Nickster90s/Inferno-FPGA/MCR_REPLACEMENT.md

# Replacing `mcr` — design for a Dante media clock

Written at the end of a session that hit three separate clock failures, all
centred on `mcr`. The conclusion, which the operator reached first: `mcr` is AVB
media-clock-recovery machinery and Dante does not need most of it.

## What mcr is, and why it fights us

`mcr` was built to recover a media clock from an **AVB CRF stream**. It carries:

- CRF stream binding (`crf_stream_id`, `crf_dmac`, talker EID), persisted in config
- a CRF-loss **watchdog** that snaps `current_increment` back to `base_increment`
- its own `servo_locked` state machine and a CRF PI servo
- a *secondary* path that derives the NCO from the gPTP addend ratio

**Dante has no CRF.** Nothing binds a stream, nothing feeds the CRF servo, the
watchdog can only ever fire in the "lost" direction, and the gPTP path is gated
on `gptp_t.servo_locked` — a flag set only by `gptp_servo_update()`, i.e. the
802.1AS servo, which this device no longer runs.

Net effect today: `mcr_compute_gptp_base()` always returns the undisciplined
`base_increment`. The media clock free-runs at the crystal rate.

## Measured evidence (this session)

| state | drift | underrun |
|---|---|---|
| undisciplined (current) | +4.34 ppm, +15.6 ms/hour | ~130 total, not growing |
| mcr pointed at `g_ptpv1` | **+0.17 ppm**, +0.61 ms/hour | 40547 in 4 min, then a 4.19M burst |
| following servo integral only | — | same underrun storm |
| firmware NCO trim on top | timestamp fell **5.3 s** behind in 115 s | — |

The drift fix works. Something about changing the NCO increment at runtime
starves the ring — and `fifo_level` reads centre (65-67) throughout, which no
one has explained. The 5.3 s divergence is three orders of magnitude beyond the
±50 ppm the trim was clamped to, so it is not an arithmetic error; it is the
same fault at its most extreme.

**Start the rewrite from that contradiction, not from the drift.**

## What a Dante media clock actually needs

One thing: an NCO whose rate is slaved to the PTPv1 rate estimate.

    increment = base_increment * (1 + rate_error)

where `rate_error` comes from the PTPv1 servo. `g_ptpv1` already exposes
`locked`, `base_addend_full` and `current_addend_full`; the ratio of the last two
IS the rate correction, in exactly the form needed.

Deliberately absent: CRF binding, CRF servo, the loss watchdog, `servo_locked`,
the config fields, the `cs` media-clock-source selector.

## Prime suspects for the underrun

1. **The watchdog.** `watchdog_reset_active` snaps the increment back to
   `base_increment`. If it fires while the gPTP path is also writing, the NCO
   oscillates between two rates — which would starve a ring while the *average*
   level still looks correct. This fits the `fifo_level`-at-centre contradiction
   better than anything else and should be checked first.
2. **CSR write path.** `mcr_increment_write()` is called from several places
   (`mcr.c:53, 388, 442`). Concurrent writers with different sources would
   produce exactly this.
3. **Deadband interaction.** The gPTP-base deadband suppresses rewrites; combined
   with a watchdog reset the effective rate could latch to the wrong value.

## Reference: statime's overlay clock (`origin/inferno-dev`)

That branch is the **PTPv1** fork, not upstream PTPv2 — I got this wrong once and
the operator corrected it. `statime/src/overlay_clock.rs` is directly relevant:

    pub struct ClockOverlay {
        pub last_sync: Time,   // underlying clock's timestamp of last sync
        pub shift: Duration,   // add to OS clock -> virtual clock
        pub freq_scale: f64,   // + accelerates the virtual clock
    }
    pub trait ClockOverlayExporter {
        fn export(&mut self, overlay: &ClockOverlay);
    }

Two things to take from it:

1. **Rate and phase are separate, explicit state.** `freq_scale` is the standing
   rate correction; `shift` is phase. Our servo conflates them inside one addend,
   which is why "follow the integral" and "follow the full addend" both went
   wrong in different ways — neither is cleanly one or the other.
2. **One owner, one export point.** The overlay is the single writer, and
   consumers are *told* when it changes via the exporter callback. Our
   `mcr_increment_write()` is called from three sites (`mcr.c:53, 388, 442`) with
   independently computed values. If two of them disagree the NCO alternates
   between rates — which starves a ring while its AVERAGE level still reads
   centre, matching the one observation nothing else explains.

The replacement should therefore be shaped as: PTPv1 owns `(shift, freq_scale)`,
exports `freq_scale` on change, and the NCO has exactly ONE writer that consumes
it. That is a stronger constraint than "slave the NCO to g_ptpv1" and is probably
the actual fix.

## Suggested order

1. Instrument before changing: log every `mcr_increment_write()` with its value
   and caller for 30 s with the clock disciplined. If the value oscillates,
   suspect 1 or 2 is confirmed and the rewrite is straightforward. This is the
   cheapest decisive experiment available and should come before any new code.
2. Write `mcr_dante.c`: NCO slaved to `g_ptpv1`, nothing else. ~50-80 lines.
3. Keep `mcr.c` in `_avb_reference/` — it is still the reference for the NCO
   arithmetic and the USB feedback servo scaling.
4. Verify in this order: `underrun` delta over 10 min (must stay 0), then drift
   rate over 1 h (target < 0.5 ppm), then an overnight run.

## Also still AVB-shaped, lower priority

- `config.h` carries `cs`, `crf_valid`, `crf_stream_id`, `crf_dmac`,
  `crf_talker_eid` — all dead under Dante.
- `gptp.c` remains as the TSU accessor and servo library; `ptpv1.c` reuses parts.
  That layering is fine, but `gptp_t.servo_locked` being read by `mcr` while only
  the 802.1AS servo sets it is exactly the trap that caused the undisciplined
  clock. Any remaining cross-module reads of gPTP state deserve the same audit.

---

# DONE (2026-08-03) — `mcr_dante.c`

Built and measured. `mcr_watchdog_tick()` no longer owns the NCO; `mcr_dante.c`
is the single writer.

## The mechanism, finally identified

Two things had been missed, and together they explain why both previous attempts
failed:

**1. An AVB watchdog was setting the Dante sample rate.** Under Dante there is no
CRF, so `mcr_pump_hw()` is a no-op, `mcr_servo_update()` is gated off
(`cs==1 && crf_rate_valid`), and `mcr_usb_lock()` — itself a PI servo that writes
the NCO — has **no callers at all**. The one live writer was the CRF-loss
watchdog's fallback branch (`mcr.c:267`), rewriting the increment on **every
main-loop iteration (~4 kHz)** with a 2-unit (~0.5 ppm) deadband.

**2. The ring already has a controller.** The USB wrapper's async feedback is not
a rate report. Traced in `rtl/usb_avb_subsystem.v`:

    err    = 64 - block_level      // setpoint = ring centre
    integ += err                   // integrator, clamped +/-0x080000
    fb_out = f(strobe_rate, err<<6, integ)    // updated every SOF

That is a PI servo on ring level. So disciplining the NCO adds a **second**
controller to one buffer — and the old code stepped it at 4 kHz underneath a
servo correcting at SOF rate.

So the missing constraint was never *which* rate estimate to follow. Following
the full addend (rate+phase) and following the integral alone both failed for the
same reason: **neither was slew-limited.**

## The rewrite

- **One owner.** `mcr_dante.c` only. `main.c` no longer calls
  `mcr_watchdog_tick()`.
- **Rate only.** Follows `g_ptpv1.rate_ppb` — the servo integral. The
  proportional term is phase and never reaches the audio sample rate.
- **Slew-limited to 100 ppb/s, updated at 1 Hz.** The whole 4.3 ppm correction
  takes ~43 s and costs **17 CSR writes**, against the old path's thousands per
  second.
- **Disabled at boot**, dry-run reporting first (`tools/mclk.py`).
- **Auto-disable** if underrun exceeds 10% duty with an active ring.

## Measured (no USB source attached; drift still valid, the packetizer emits at the media rate regardless)

| discipline | drift |
|---|---|
| ARMED | **+0.17 ppm  (+0.6 ms/hour)** |
| disarmed | **+4.86 ppm  (+17.5 ms/hour)** |

Toggled twice, causal and reversible. Dry-run cross-check passed before arming:
PTP's estimate (-4.28 ppm) against independently measured drift (+4.7 ppm) —
opposite sign, matching magnitude.

## Also found: the "underruns with fifo_level at centre" paradox is not one

`underrun_count` increments on **every 48 kHz media tick** while un-primed, not
per event — measured directly at 48009/s with the ring empty. So the historic
"40547 underruns in 4 minutes" is **0.845 s of un-primed time (0.35% duty)**:
brief, repeated dips. `fifo_level` was read as a ~1 Hz snapshot, which lands in a
dip almost never. Nothing paradoxical, just a fast transient sampled slowly.
`mcr_dante_level_sample()` now tracks min/max at 1 kHz; **watch min, not avg.**

## VALIDATED WITH AUDIO (2026-08-04)

The half that killed both previous attempts. MacBook streaming, two unicast
flows, talker on. Discipline toggled at runtime; same session, same bitstream.

| | disarmed | ARMED |
|---|---|---|
| drift | +3.61 ppm (+13.0 ms/hour) | **+0.39 ppm (+1.4 ms/hour)** |
| ring level | 45…77 | **48…78** |
| underrun delta | 0 | **0** |
| overrun delta | 0 | **0** |
| trips | 0 | **0** |

**The ring did not care.** Level range while armed (48…78) is
indistinguishable from undisciplined (45…77), against a centre of 64. Sampled
through the whole 44 s slew at 4 s intervals, the worst level minimum was 49 and
peak underrun was 0/s -- the ring never approached the prime floor.

That is the difference the slew limiter makes. Both earlier attempts stepped the
NCO at main-loop rate and produced underrun storms; at 100 ppb/s the USB PI
servo absorbs the change as an ordinary disturbance and the level does not move.

PTP stayed locked with no re-anchors, enables or disables throughout, and
rx_gate's writer_errors stayed at its usual armed residual -- so disciplining
the media clock disturbs neither the network nor the clock recovery.

## One gap in the safety net remains

The auto-disable guard requires `lvl_max >= 32` to distinguish "ring active"
from "no USB source". If a disciplined clock prevented the ring from priming at
all, `lvl_max` would stay low, the guard would never trip, and audio would be
silently dead. That did not happen here -- the ring never went near the floor --
but the hole is real and untested, because nothing has yet made the guard fire.
Worth closing before this runs unattended overnight.

    tools/mclk.py status      # target vs drift, and ring level min/max
    tools/mclk.py on          # slews over ~45 s
    tools/mclk.py watch 120   # watch level MIN and underrun delta
    tools/mclk.py off         # immediate, unconditional revert to nominal

Procedure:

---

# RATE IS NOT ENOUGH — the phase bug (2026-08-04)

Within hours of the rate discipline being declared working, **audio stopped
entirely** while every counter read healthy. The fix above was half a fix.

## Symptom

No audio at any receiver. Dante Controller showed the patch **fully green**.
Re-patching changed nothing. Meanwhile on the board:

    talker 1, 9001 pps on the wire, ring centred 55..73,
    underrun 0/s, overrun 0, PTP locked, rx_gate armed and clean

Everything that could be measured said the transmitter was healthy.

## Cause

    emitted 402927.04519    PTP 402926.41611   =  +10908 samples
                                               =  +227 ms INTO THE FUTURE

`DANTE_TX_TS_OFFSET` is +74 samples (1.5 ms). We were at **147x that**, in the
future. `flows_tx.rs:44` is explicit that the clock must be in the past --
"otherwise Dante devices receiving from us go mad and fart". Receivers negotiate
the subscription happily (the control plane is untouched, hence the green
patch) and then discard every audio packet as far-future.

**Two independent failures had to line up:**

1. **`ts_anchor()` only runs when the talker ENABLES.** The talker stayed on for
   two days while the USB host was off, free-running at +4.7 ppm the whole time.
   227 ms is about 13 hours of that.

2. **The re-anchor watchdog was structurally blind to it.** `dante_tx.c:327`
   compared only the **seconds** field and fired on `diff > 1`. The error lived
   entirely in the sub-second field, and the seconds differed by exactly 1 --
   which `> 1` does not catch. A one-second threshold is ~1000x a receiver's
   latency setting; it could never have protected audio.

## And the rate fix could not have caught it

`mcr_dante` corrects **rate**. Rate discipline stops the error growing; it never
returns what has already accumulated. With the phase 227 ms out, drift measured
a healthy +0.53 ppm the whole time -- perfectly flat, perfectly wrong.

This is exactly what `overlay_clock.rs` says and what the section above quoted
without acting on:

> **Rate and phase are separate, explicit state.** `freq_scale` is the standing
> rate correction; `shift` is phase.

Only `freq_scale` was built. `shift` was missing, and nothing measured it: the
status output printed `drift +10829 samples` for hours and it was read as a
benign running total rather than as 227 ms of phase error.

## Fix, both halves

- **`dante_tx.c`** — the re-anchor now measures phase in **samples**
  (`DANTE_TX_REANCHOR_SAMPLES` = 240 = 5 ms), not in whole seconds. It is a
  STEP and audible, so it is a coarse backstop only: PTP steps, and phase
  accumulated while the talker was idle.
- **`mcr_dante.c`** — a slow phase term alongside the rate. 4 ppb per sample of
  error, clamped to **+/-2000 ppb**, 1 ms deadband. Deliberately feeble: under
  half the crystal error the rate term already handles, so it cannot fight the
  ring or the USB servo. Its job is to stop phase ever accumulating, not to
  rescue a large one.

## Verified

    phase    +10908 samples  ->  -4 samples
    rate     +0.69 ppm armed
    ring     51..78 (centre 64), underrun delta 0, overrun delta 0
    PTP      locked, no re-anchors

**Audio confirmed back by ear.**

## The lesson worth keeping

A media clock has two error axes and this project had instruments for one.
Every counter on the box read healthy through a total audio outage, because
none of them measured phase. When adding a servo, ask what the OTHER axis is
doing -- and if nothing reports it, that is the bug waiting to happen.

---

# RETRACTION: the "fpp=16 timestamp is 167 us late" claim was WRONG (2026-08-05)

Commit 643a6a6 recorded, as a real unfixed bug, that fpp=16 flows are stamped
8 samples (167 us) late relative to their own audio, and that a device on
fpp=16 therefore renders 167 us apart from one on fpp=8.

**That is not true.** The reasoning read `ts_sub_emit` being latched once per
block and shared by every flow, saw the read base `rd - Mux(fpp16, 64, 0)`
(64 ring entries = 8 sample-times), and concluded the two were inconsistent. It
missed the line that reconciles them:

    f_ts_sub.eq(ts_sub_emit - (cur_fpp - 1))

The per-flow timestamp already compensates for fpp: 8 subtracts 7, 16 subtracts
15 -- a difference of exactly the 8 sample-times the read base moves. So

    fpp=8   reads [tick-7, tick],  stamps tick-7    correct
    fpp=16  reads [tick-15, tick], stamps tick-15   correct

Both label their own first sample. There is no inter-flow misalignment, and
nothing to fix.

Also checked while in there, since this file records a previous unsigned-wrap
disaster in exactly this arithmetic (`sec=85673 subsec=4294967264`): send_req
fires at `ts_sub[0:3] == 7`, so ts_sub_emit is congruent to 7 mod 8, and fpp=16
only fires on tick_hi where ts_sub is congruent to 15 mod 16. Both subtractions
bottom out at 0. No borrow, no wrap.

LESSON: the claim was made from two fragments of an expression without reading
the third, and stated confidently enough that the next step was a 20-minute
gateware build and a seed re-roll to fix a bug that did not exist.
