Nickster90s/Inferno-FPGA/docs/milestones/phase3_dante_controller_clock_status.png

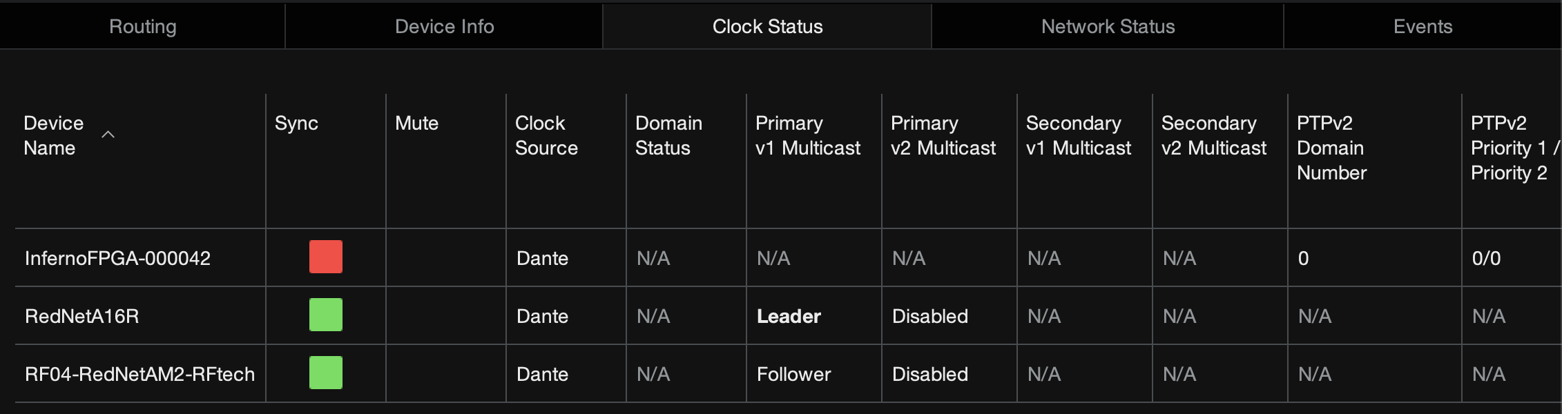
docs/milestones/phase3_dante_controller_clock_status.png
