Nickster90s/Inferno-FPGA/_avb_reference/firmware/avdecc.c

// IEEE 1722.1 AVDECC — minimal endpoint
//
// ADP: Periodic entity advertisement so controllers can discover us.
// ACMP: Handle connect/disconnect commands for talker and listener streams.
//
// PDU format (IEEE 1722.1-2013):
//   Ethernet header (14 bytes)
//   AVTPDU common header:
//     subtype(8) | sv(1) version(3) msg_type(4) | valid_time(5) control_data_len(11)
//     entity_id(64)
//   Protocol-specific fields follow.

#include "avdecc.h"
#include "gptp.h"
#include "cap.h"
#include "osc.h"
#include "config.h"

#include <generated/csr.h>
#include <generated/mem.h>
#include <generated/soc.h>
#include <string.h>
#include <stdio.h>

// Backreference to the gPTP module so ADP/AVB_INTERFACE can surface the
// learned grandmaster identity + our local clock_identity. Set by main.c
// after both gptp_init and avdecc_init via avdecc_set_gptp().
static const gptp_t *g_gptp = NULL;

// Backreference to the MCR module — when current_clock_source = 1, the
// CLOCK_DOMAIN LOCKED counter follows mcr.servo_locked rather than gPTP,
// so the Hive indicator turns green only when CRF actually flows.
static const mcr_state_t *g_mcr = NULL;

// Backreference to SRP module — GET_AVB_INFO RESPONSE must declare an
// msrp_mapping (traffic_class / priority / vlan_id) that matches what we
// emit on MSRP TalkerAdvertise. If avdecc says one priority and MSRP says
// another, the listener (Auvitran) reports MSRP failure 0x13 "SR Class
// Priority Mismatch" and the bridge refuses the reservation.
#include "srp.h"
static const srp_state_t *g_srp = NULL;
void avdecc_set_srp(const srp_state_t *s) { g_srp = s; }

// Vendor's Entity Model ID (EUI-64) — IDENTIFIES THE PRODUCT MODEL, not
// the specific device. All units running this firmware must report the
// same value; per-device uniqueness is the entity_id (MAC-derived).
// Layout: 02 FF EE (locally-administered OUI placeholder) | "NSAV" (4E53
// 4156, "N-Series AV") | 0001 (product revision).
static const uint8_t ENTITY_MODEL_ID[8] = {
    0x02, 0xFF, 0xEE, 0x4E, 0x53, 0x41, 0x56, 0x01
};

// ---------------------------------------------------------------------------
// Byte-order helpers
// ---------------------------------------------------------------------------

static inline void av_put_be16(uint8_t *p, uint16_t v)
{
    p[0] = (v >> 8); p[1] = v;
}

static inline void av_put_be32(uint8_t *p, uint32_t v)
{
    p[0] = (v >> 24); p[1] = (v >> 16); p[2] = (v >> 8); p[3] = v;
}

static inline void av_put_be64(uint8_t *p, uint64_t v)
{
    av_put_be32(p, (uint32_t)(v >> 32));
    av_put_be32(p + 4, (uint32_t)v);
}

static inline uint16_t av_get_be16(const uint8_t *p)
{
    return ((uint16_t)p[0] << 8) | p[1];
}

static inline uint32_t av_get_be32(const uint8_t *p)
{
    return ((uint32_t)p[0] << 24) | ((uint32_t)p[1] << 16) |
           ((uint32_t)p[2] << 8)  | p[3];
}

// ---------------------------------------------------------------------------
// TX
// ---------------------------------------------------------------------------

// Per-stream identity
#define N_STREAM_INPUTS   2     // [0]=CRF Media Clock, [1]=AAF Audio Input
#define N_STREAM_OUTPUTS  6     // 6x8ch AAF Audio Output (time-mux talker)
#define N_CLOCK_SOURCES   2     // [0]=Internal osc, [1]=CRF stream
#define N_CONTROLS        2     // [0]=USB A/B source (uint8), [1]=OSC IP/Subnet (UTF8 text)
#define N_AUDIO_CHANNELS  8     // 8ch AAF I/O

// USB A/B source select, driven by the AVDECC CONTROL descriptor (0=Main,
// 1=Backup). Phase-2: the 2nd USB's A/B mux will read this (via a CSR). For
// now it is the CONTROL's current value so the choice is pickable in Hive
// before the 2nd-oscillator hardware exists.
uint8_t g_usb_source = 0;
#define LISTENER_CRF_INDEX 0
#define LISTENER_AAF_INDEX 1
#define TALKER_AAF_INDEX   0
#define CLK_SRC_INTERNAL   0
#define CLK_SRC_MEDIA      1    // CRF-driven media clock

// Stream-format constants (decoded from session_mgr.aemt + IEEE 1722.1-2013
// Annex A; see avdecc.h for byte-by-byte derivation).
//
// Listener[0] = CRF audio-sample 48 kHz (Media Clock Input).
// Listener[1] = AAF PCM 8ch / 48 kHz / 32-bit (Audio Input).
// Talker[0]   = AAF PCM 8ch / 48 kHz / 32-bit (Audio Output).
static const uint8_t stream_fmt_crf_48k[8]     = STREAM_FMT_CRF_48K;
static const uint8_t stream_fmt_aaf_8ch_48k[8] = STREAM_FMT_AAF_8CH_48K;

static uint32_t avdecc_txslot;

static uint8_t *avdecc_tx_buf(void)
{
    return (uint8_t *)(ETHMAC_BASE + ETHMAC_SLOT_SIZE * (ETHMAC_RX_SLOTS + avdecc_txslot));
}

static void avdecc_eth_send(uint32_t len)
{
    cap_record(1, avdecc_tx_buf(), len);   // record our TX (ADP/AECP/ACMP) into the boot ring
    while (!ethmac_sram_reader_ready_read())
        ;
    ethmac_sram_reader_slot_write(avdecc_txslot);
    ethmac_sram_reader_length_write(len);
    ethmac_sram_reader_start_write(1);
    avdecc_txslot = (avdecc_txslot + 1) % ETHMAC_TX_SLOTS;
}

// Write Ethernet header, returns pointer past it.
static uint8_t *avdecc_eth_hdr(uint8_t *frame, const uint8_t *src_mac)
{
    static const uint8_t mcast[] = AVDECC_MCAST_ADDR;
    memcpy(frame, mcast, 6);
    memcpy(frame + 6, src_mac, 6);
    av_put_be16(frame + 12, AVDECC_ETHERTYPE);
    return frame + 14;
}

// ---------------------------------------------------------------------------
// ADP — AVDECC Discovery Protocol
// ---------------------------------------------------------------------------

// ADPDU layout (after Ethernet header):
//   [0]      subtype = 0x7A
//   [1]      sv(1)=0 | version(3)=0 | message_type(4)
//   [2..3]   valid_time(5) | control_data_length(11) = 56
//   [4..11]  entity_id (8 bytes)
//   [12..19] entity_model_id (8 bytes)
//   [20..23] entity_capabilities (4 bytes)
//   [24..25] talker_stream_sources (2 bytes)
//   [26..27] talker_capabilities (2 bytes)
//   [28..29] listener_stream_sinks (2 bytes)
//   [30..31] listener_capabilities (2 bytes)
//   [32..35] controller_capabilities (4 bytes)
//   [36..39] available_index (4 bytes)
//   [40..47] gptp_grandmaster_id (8 bytes)
//   [48]     gptp_domain_number
//   [49]     reserved (1 byte)   — IEEE 1722.1 §6.2.1.15 / la_avdecc. (GenAVB's
//            struct adp_pdu carries an extra rsvd1 u16 here; do NOT copy it — the
//            MOTU/Hive parse per la_avdecc and it shifts interface_index.)
//   [50..51] identify_control_index (2 bytes)
//   [52..53] interface_index (2 bytes)
//   [54..61] association_id (8 bytes)
//   [62..67] reserved (6 bytes) — keeps the AVTP frame body at 68 bytes so Hive
//            doesn't log "Adpdu::deserialize error: Not enough data in buffer".
// Total ADPDU = 68 bytes, control_data_length = 56 (per IEEE 1722.1)

#define ADPDU_LEN           68
#define ADP_CONTROL_DATA_LEN 56

static void adp_send(avdecc_state_t *s, uint8_t msg_type)
{
    uint8_t *frame = avdecc_tx_buf();
    uint8_t *p = avdecc_eth_hdr(frame, s->src_mac);

    // Subtype
    p[0] = AVTP_SUBTYPE_ADP;

    // sv=0 | version=0 | message_type
    p[1] = msg_type & 0x0F;

    // valid_time(5) | control_data_length(11) = 56
    uint16_t vt_cdl = ((uint16_t)ADP_VALID_TIME << 11) | ADP_CONTROL_DATA_LEN;
    av_put_be16(p + 2, vt_cdl);

    // entity_id
    memcpy(p + 4, s->entity_id, 8);

    // entity_model_id — static, identifies the firmware/product model.
    memcpy(p + 12, ENTITY_MODEL_ID, 8);

    // entity_capabilities — AEM_SUPPORTED is required for controllers to
    // issue READ_DESCRIPTOR; without it Hive lists the entity but treats
    // it as having no AEM model and shows it as empty.
    // AEM_INTERFACE_INDEX_VALID flags that the interface_index field
    // (byte 54) is meaningful — without it Hive marks the entity name
    // red in the patch matrix even when everything else validates.
    uint32_t caps = ADP_CAP_AEM_SUPPORTED |
                    ADP_CAP_VENDOR_UNIQUE_SUPPORTED |
                    ADP_CAP_CLASS_A_SUPPORTED |
                    ADP_CAP_GPTP_SUPPORTED |
                    ADP_CAP_AEM_INTERFACE_INDEX_VALID;
    av_put_be32(p + 20, caps);

    // talker_stream_sources = N_STREAM_OUTPUTS (1 AAF talker)
    av_put_be16(p + 24, N_STREAM_OUTPUTS);

    // talker_capabilities
    uint16_t talker_caps = ADP_TALKER_CAP_IMPLEMENTED | ADP_TALKER_CAP_AUDIO_SOURCE;
    av_put_be16(p + 26, talker_caps);

    // listener_stream_sinks = N_STREAM_INPUTS (1 CRF + 1 AAF)
    av_put_be16(p + 28, N_STREAM_INPUTS);

    // listener_capabilities — we have a CRF (Media Clock) listener at
    // STREAM_INPUT[0] AND an AAF (Audio) listener at STREAM_INPUT[1], so
    // advertise both sink capabilities. MEDIA_CLOCK_SINK is the critical
    // one for CRF: talkers (Auvitran) don't route CRF traffic to listeners
    // that only declare AUDIO_SINK — they look specifically for MediaClockSink.
    uint16_t listener_caps = ADP_LISTENER_CAP_IMPLEMENTED |
                             ADP_LISTENER_CAP_MEDIA_CLOCK_SINK |
                             ADP_LISTENER_CAP_AUDIO_SINK;
    av_put_be16(p + 30, listener_caps);

    // controller_capabilities = 0
    av_put_be32(p + 32, 0);

    // available_index
    av_put_be32(p + 36, s->adp_available_index);

    // gptp_grandmaster_id — learned from Announce messages by gPTP.
    // Zero until first Announce; matches the actual GM thereafter.
    if (g_gptp && g_gptp->gm_valid)
        memcpy(p + 40, g_gptp->gm_clock_id, 8);
    else
        memset(p + 40, 0, 8);

    // gptp_domain_number = 0
    p[48] = 0;

    // reserved
    // reserved: exactly ONE octet after gptp_domain_number (IEEE 1722.1
    // §6.2.1.15, and la_avdecc/Hive/MOTU parse it that way). The old code used
    // THREE reserved bytes (copied from GenAVB's struct adp_pdu, which carries an
    // extra rsvd1 u16) — that shifted identify_control_index/interface_index/
    // association_id +2, so our 0xFFFF landed in the field the MOTU reads as
    // interface_index (avb_session sends 0 there). A Milan listener checks
    // interface_index (adp_milan.c:400) and refused to bind our streams -> entity
    // visible ("green round") but no connection. Match la_avdecc / avb_session.
    p[49] = 0;

    // identify_control_index (offset 50): 0xFFFF = no CONTROL descriptor.
    av_put_be16(p + 50, 0xFFFF);
    // interface_index (offset 52): 0 = AVB_INTERFACE descriptor at index 0.
    av_put_be16(p + 52, 0);

    // association_id (offset 54)
    memset(p + 54, 0, 8);

    // reserved trailing (offset 62..67) — keeps ADPDU length unchanged.
    memset(p + 62, 0, 6);

    // Total frame
    uint32_t frame_len = 14 + ADPDU_LEN;
    if (frame_len < 64)
        frame_len = 64;  // Minimum Ethernet frame

    avdecc_eth_send(frame_len);

    if (msg_type == ADP_MSG_ENTITY_AVAILABLE)
        s->adp_available_index++;

    s->adp_tx_count++;
}

void avdecc_reannounce(avdecc_state_t *s)
{
    // DEPARTING then AVAILABLE (with a bumped available_index): a real ADP-level
    // state change the AxC observes. Milan listeners re-run fast-connect on this ->
    // re-send CONNECT_TX -> re-lock to our stream on the now-settled clock. A media
    // gap alone did NOT make the AxC re-derive (not an AVDECC event); this is the
    // standard control-plane way to force it.
    adp_send(s, ADP_MSG_ENTITY_DEPARTING);
    adp_send(s, ADP_MSG_ENTITY_AVAILABLE);
}

// ---------------------------------------------------------------------------
// ACMP — AVDECC Connection Management Protocol
// ---------------------------------------------------------------------------

// ACMPDU layout (after Ethernet header):
//   [0]      subtype = 0x7C
//   [1]      sv(1)=0 | version(3)=0 | message_type(4)
//   [2..3]   status(5) | control_data_length(11) = 44
//   [4..11]  stream_id (8 bytes)
//   [12..19] controller_entity_id (8 bytes)
//   [20..27] talker_entity_id (8 bytes)
//   [28..35] listener_entity_id (8 bytes)
//   [36..37] talker_unique_id (2 bytes)
//   [38..39] listener_unique_id (2 bytes)
//   [40..45] stream_dest_mac (6 bytes)
//   [46..47] connection_count (2 bytes)
//   [48..49] sequence_id (2 bytes)
//   [50..51] flags (2 bytes)
//   [52..53] stream_vlan_id (2 bytes)
//   [54..55] reserved (2 bytes)
// Total ACMPDU = 56 bytes, control_data_length = 44

#define ACMPDU_LEN              56
#define ACMP_CONTROL_DATA_LEN   44

// Offsets within ACMPDU (from start of PDU, past Ethernet header)
#define ACMP_OFF_STREAM_ID          4
#define ACMP_OFF_CONTROLLER_ID      12
#define ACMP_OFF_TALKER_ID          20
#define ACMP_OFF_LISTENER_ID        28
#define ACMP_OFF_TALKER_UID         36
#define ACMP_OFF_LISTENER_UID       38
#define ACMP_OFF_STREAM_DEST_MAC    40
#define ACMP_OFF_CONN_COUNT         46
#define ACMP_OFF_SEQ_ID             48
#define ACMP_OFF_FLAGS              50
#define ACMP_OFF_VLAN_ID            52

static int entity_id_match(const uint8_t *a, const uint8_t *b)
{
    for (int i = 0; i < 8; i++) {
        if (a[i] != b[i]) return 0;
    }
    return 1;
}

static void acmp_send_response(avdecc_state_t *s, uint8_t msg_type, uint8_t status,
                                const uint8_t *rx_pdu)
{
    uint8_t *frame = avdecc_tx_buf();
    uint8_t *p = avdecc_eth_hdr(frame, s->src_mac);

    // Copy the received ACMPDU as base and modify
    memcpy(p, rx_pdu, ACMPDU_LEN);

    // Subtype
    p[0] = AVTP_SUBTYPE_ACMP;

    // message_type = response type
    p[1] = msg_type & 0x0F;

    // status | control_data_length
    uint16_t st_cdl = ((uint16_t)(status & 0x1F) << 11) | ACMP_CONTROL_DATA_LEN;
    av_put_be16(p + 2, st_cdl);

    // Fill in our stream info for talker responses (by talker_unique_id)
    if (msg_type == ACMP_MSG_CONNECT_TX_RESPONSE ||
        msg_type == ACMP_MSG_GET_TX_STATE_RESPONSE ||
        msg_type == ACMP_MSG_DISCONNECT_TX_RESPONSE) {
        uint16_t tuid = av_get_be16(p + ACMP_OFF_TALKER_UID);
        if (tuid < AVDECC_MAX_TALKERS) {
            avdecc_talker_stream_t *t = &s->talkers[tuid];
            memcpy(p + ACMP_OFF_STREAM_ID, t->stream_id, 8);
            memcpy(p + ACMP_OFF_STREAM_DEST_MAC, t->dest_mac, 6);
            // Milan 1.3 §5.5.4.3: the talker MUST advertise
            // connection_count = 0 in GET_TX_STATE_RESPONSE (the spec
            // wants this field reserved for the listener-side count).
            // Hive logs a Milan compliance error if we report nonzero.
            uint16_t cc = (msg_type == ACMP_MSG_GET_TX_STATE_RESPONSE)
                            ? 0 : t->connection_count;
            av_put_be16(p + ACMP_OFF_CONN_COUNT, cc);
            // The TALKER is authoritative for the stream's VLAN + class flags;
            // don't echo the listener's command values (it may carry a wrong
            // assumption). Class A stream on VID 2 -> CLASS_B flag clear.
            av_put_be16(p + ACMP_OFF_VLAN_ID, 2);
            av_put_be16(p + ACMP_OFF_FLAGS, 0);
            // DIAGNOSTIC: show exactly what we hand the listener so it can set
            // its RX filter + declare a Listener Ready. If Frames RX stays 0,
            // compare these against what the listener actually subscribes to.
            if (msg_type == ACMP_MSG_CONNECT_TX_RESPONSE)
                printf("[ACMP] CONNECT_TX_RESPONSE -> listener: sid=%02x:%02x:%02x"
                       ":%02x:%02x:%02x:%02x:%02x dst=%02x:%02x:%02x:%02x:%02x:%02x"
                       " vlan=2 conn=%u\n",
                       t->stream_id[0], t->stream_id[1], t->stream_id[2],
                       t->stream_id[3], t->stream_id[4], t->stream_id[5],
                       t->stream_id[6], t->stream_id[7],
                       t->dest_mac[0], t->dest_mac[1], t->dest_mac[2],
                       t->dest_mac[3], t->dest_mac[4], t->dest_mac[5],
                       (unsigned)cc);
        }
    }

    // Fill in connection info for listener responses (by listener_unique_id).
    // Previously we only wrote connection_count — for GET_RX_STATE_RESPONSE
    // that left talker_eid/stream_id/dest_mac/vlan_id all zero, so Hive read
    // the response as "no connection" and showed the input as "running" even
    // when a CONNECT_RX had succeeded. Per IEEE 1722.1-2013 §8.2.2.6, the
    // response must echo the connection state: talker IDs, stream ID, dest
    // MAC, VLAN, flags (FAST_CONNECT/SAVED_STATE/CONNECTED/STREAMING).
    if (msg_type == ACMP_MSG_CONNECT_RX_RESPONSE ||
        msg_type == ACMP_MSG_GET_RX_STATE_RESPONSE ||
        msg_type == ACMP_MSG_DISCONNECT_RX_RESPONSE) {
        uint16_t luid = av_get_be16(p + ACMP_OFF_LISTENER_UID);
        if (luid < AVDECC_MAX_LISTENERS) {
            const avdecc_listener_stream_t *l = &s->listeners[luid];
            av_put_be16(p + ACMP_OFF_CONN_COUNT, l->connection_count);
            if (l->connected) {
                memcpy(p + ACMP_OFF_TALKER_ID,       l->talker_id, 8);
                av_put_be16(p + ACMP_OFF_TALKER_UID, l->talker_uid);
                memcpy(p + ACMP_OFF_STREAM_ID,       l->stream_id, 8);
                memcpy(p + ACMP_OFF_STREAM_DEST_MAC, l->dest_mac, 6);
                uint16_t vid = (l->stream_vlan_id != 0)
                                 ? l->stream_vlan_id : 2;
                av_put_be16(p + ACMP_OFF_VLAN_ID, vid);
                // ACMP has no explicit "connected" bit — a non-zero
                // talker_eid in the response IS the indication. We set
                // FAST_CONNECT + SAVED_STATE so a controller restart
                // (Hive) re-reads our persisted binding as fast-connect.
                av_put_be16(p + ACMP_OFF_FLAGS,
                            (uint16_t)(ACMP_FLAG_FAST_CONNECT |
                                       ACMP_FLAG_SAVED_STATE));
            }
        }
    }

    uint32_t frame_len = 14 + ACMPDU_LEN;
    if (frame_len < 64)
        frame_len = 64;

    avdecc_eth_send(frame_len);
    s->acmp_tx_count++;
}

// Defined near push_unsol_counters(); used here on the connect/disconnect edge.
static void push_unsol_stream_out_counters(avdecc_state_t *s, uint16_t uid);
static void push_unsol_stream_info(avdecc_state_t *s, uint16_t dt, uint16_t di);

static void acmp_handle_connect_tx(avdecc_state_t *s, const uint8_t *pdu)
{
    // A controller or listener is asking us (talker) to start streaming
    const uint8_t *listener_id = pdu + ACMP_OFF_LISTENER_ID;
    uint16_t tuid = av_get_be16(pdu + ACMP_OFF_TALKER_UID);
    uint16_t luid = av_get_be16(pdu + ACMP_OFF_LISTENER_UID);

    if (tuid >= AVDECC_MAX_TALKERS) {
        acmp_send_response(s, ACMP_MSG_CONNECT_TX_RESPONSE,
                           ACMP_STATUS_TALKER_UNKNOWN_ID, pdu);
        return;
    }

    avdecc_talker_stream_t *t = &s->talkers[tuid];

    // Reference-count DISTINCT listeners. Multiple listeners connect to the
    // same talker uid; keep TX enabled while ANY is connected. (memcmp isn't
    // linked in this bare-metal libc -> manual 8-byte compare.)
    int known = 0, freeslot = -1;
    for (int i = 0; i < AVDECC_MAX_LISTENERS_PER_TALKER; i++) {
        int zero = 1, same = 1;
        for (int k = 0; k < 8; k++) {
            if (t->listeners[i][k])                   zero = 0;
            if (t->listeners[i][k] != listener_id[k]) same = 0;
        }
        if (!zero && same) { known = 1; break; }
        if (zero && freeslot < 0) freeslot = i;
    }
    uint8_t was_n = t->n_listeners;
    if (!known && freeslot >= 0) {
        memcpy(t->listeners[freeslot], listener_id, 8);
        t->n_listeners++;
    }
    memcpy(t->listener_id, listener_id, 8);   // most-recent (diag / response)
    t->listener_uid = luid;
    t->connected = (t->n_listeners > 0);
    t->connection_count++;

    printf("[AVDECC] CONNECT_TX uid=%u <- listener "
           "%02x:%02x:%02x:%02x:%02x:%02x:%02x:%02x (n_listeners=%u)\n",
           tuid,
           listener_id[0], listener_id[1], listener_id[2], listener_id[3],
           listener_id[4], listener_id[5], listener_id[6], listener_id[7],
           t->n_listeners);

    // Enable TX only on the 0->1 transition (first listener).
    if (was_n == 0 && t->n_listeners > 0) {
        // Milan STREAM_START: bump on the empty->non-empty edge (matches the
        // reference handleConnectTx g_streamStartCount). Keep the §5.3.7.7
        // invariant |start-stop|<=1: only advance if start is level with stop.
        if (t->stream_start <= t->stream_stop)
            t->stream_start++;
        push_unsol_stream_out_counters(s, tuid);   // let Hive see it climb live
        // Push STREAM_INFO too so the controller/listener immediately sees the
        // talker flip to CONNECTED/streaming (matches avb_session's
        // notify_stream_info_changed(0x0006) on connect). Without this the
        // listener never learns the talker is live and never arms its input.
        push_unsol_stream_info(s, AEM_DESC_STREAM_OUTPUT, tuid);
        if (s->on_talker_connect)
            s->on_talker_connect(tuid, listener_id);
    }

    acmp_send_response(s, ACMP_MSG_CONNECT_TX_RESPONSE, ACMP_STATUS_SUCCESS, pdu);
}

static void acmp_handle_disconnect_tx(avdecc_state_t *s, const uint8_t *pdu)
{
    uint16_t tuid = av_get_be16(pdu + ACMP_OFF_TALKER_UID);
    const uint8_t *listener_id = pdu + ACMP_OFF_LISTENER_ID;
    if (tuid < AVDECC_MAX_TALKERS) {
        avdecc_talker_stream_t *t = &s->talkers[tuid];
        // Remove this listener from the set; disable TX only on 1->0 (last one).
        for (int i = 0; i < AVDECC_MAX_LISTENERS_PER_TALKER; i++) {
            int same = 1;
            for (int k = 0; k < 8; k++)
                if (t->listeners[i][k] != listener_id[k]) { same = 0; break; }
            if (same) {
                memset(t->listeners[i], 0, 8);
                if (t->n_listeners > 0) t->n_listeners--;
                break;
            }
        }
        if (t->connection_count > 0) t->connection_count--;
        t->connected = (t->n_listeners > 0);
        printf("[AVDECC] DISCONNECT_TX uid=%u (n_listeners=%u)\n", tuid, t->n_listeners);
        if (t->n_listeners == 0) {
            // Milan STREAM_STOP on the non-empty->empty edge, guarded so
            // stop never exceeds start (§5.3.7.7 |start-stop|<=1).
            if (t->stream_stop < t->stream_start)
                t->stream_stop++;
            push_unsol_stream_out_counters(s, tuid);
            push_unsol_stream_info(s, AEM_DESC_STREAM_OUTPUT, tuid);  // talker -> not connected
            if (s->on_talker_disconnect)
                s->on_talker_disconnect(tuid);
        }
    } else {
        printf("[AVDECC] DISCONNECT_TX uid=%u\n", tuid);
    }
    acmp_send_response(s, ACMP_MSG_DISCONNECT_TX_RESPONSE, ACMP_STATUS_SUCCESS, pdu);
}

static void acmp_handle_get_tx_state(avdecc_state_t *s, const uint8_t *pdu)
{
    acmp_send_response(s, ACMP_MSG_GET_TX_STATE_RESPONSE, ACMP_STATUS_SUCCESS, pdu);
}

// Send our own ACMP CONNECT_TX_COMMAND (slow-path resolve). We act as a
// pseudo-controller asking the talker for stream details so we can fill
// in the deferred CONNECT_RX_RESPONSE.
static void send_connect_tx_command(avdecc_state_t *s, const avdecc_resolve_t *r)
{
    uint8_t *frame = avdecc_tx_buf();
    uint8_t *p = avdecc_eth_hdr(frame, s->src_mac);

    memset(p, 0, ACMPDU_LEN);
    p[0] = AVTP_SUBTYPE_ACMP;
    p[1] = ACMP_MSG_CONNECT_TX_COMMAND;
    av_put_be16(p + 2, ACMP_CONTROL_DATA_LEN);          // status=0, cdl=44
    // stream_id (offset 4..11) = 0 (we don't know it yet — that's why we're asking)
    memcpy(p + ACMP_OFF_CONTROLLER_ID, s->entity_id, 8);
    memcpy(p + ACMP_OFF_TALKER_ID,     r->talker_id,  8);
    memcpy(p + ACMP_OFF_LISTENER_ID,   s->entity_id, 8);
    av_put_be16(p + ACMP_OFF_TALKER_UID,   r->talker_uid);
    av_put_be16(p + ACMP_OFF_LISTENER_UID, r->listener_uid);
    // dest_mac/conn_count zero; vlan zero; flags zero
    av_put_be16(p + ACMP_OFF_SEQ_ID, r->our_seq_id);

    avdecc_eth_send(14 + ACMPDU_LEN);
    s->acmp_tx_count++;
}

// Proactively initiate a listener connection (slow-path) WITHOUT a controller —
// used by the CRF auto-reconnect at boot. Sends CONNECT_TX_COMMAND to the talker
// for (listener_uid <- talker_eid[talker_uid]); the talker's CONNECT_TX_RESPONSE
// is handled by the normal resolve path (binds + on_listener_connect). A passive
// pending listener only binds if the talker spontaneously advertises — which it
// won't unless asked, so we ask here. ctrl_eid is zeroed (no controller), making
// the eventual deferred CONNECT_RX_RESPONSE a harmless no-op.
void avdecc_initiate_listener_connect(avdecc_state_t *s, uint8_t listener_uid,
                                      const uint8_t *talker_eid, uint16_t talker_uid)
{
    if (listener_uid >= AVDECC_MAX_LISTENERS) return;
    avdecc_resolve_t *r = &s->resolves[listener_uid];
    r->active           = 1;
    r->listener_uid     = listener_uid;
    r->our_seq_id       = s->next_acmp_seq++;
    memset(r->ctrl_eid_orig, 0, 8);
    r->ctrl_seq_id_orig = 0;
    memcpy(r->talker_id, talker_eid, 8);
    r->talker_uid       = talker_uid;
    r->start_ms         = gptp_uptime_ms();
    send_connect_tx_command(s, r);
}

// Send an ACMP DISCONNECT_TX_COMMAND to a talker — clears its stale
// talker/listener state before we re-bootstrap with CONNECT_TX. Used by
// the CRF data-flow watchdog. Carries the known stream_id (unlike the
// slow-path CONNECT_TX query which sends stream_id=0).
static void send_disconnect_tx_command(avdecc_state_t *s,
                                       const avdecc_resolve_t *r,
                                       const uint8_t *stream_id)
{
    uint8_t *frame = avdecc_tx_buf();
    uint8_t *p = avdecc_eth_hdr(frame, s->src_mac);

    memset(p, 0, ACMPDU_LEN);
    p[0] = AVTP_SUBTYPE_ACMP;
    p[1] = ACMP_MSG_DISCONNECT_TX_COMMAND;
    av_put_be16(p + 2, ACMP_CONTROL_DATA_LEN);
    if (stream_id) memcpy(p + ACMP_OFF_STREAM_ID, stream_id, 8);
    memcpy(p + ACMP_OFF_CONTROLLER_ID, s->entity_id, 8);
    memcpy(p + ACMP_OFF_TALKER_ID,     r->talker_id, 8);
    memcpy(p + ACMP_OFF_LISTENER_ID,   s->entity_id, 8);
    av_put_be16(p + ACMP_OFF_TALKER_UID,   r->talker_uid);
    av_put_be16(p + ACMP_OFF_LISTENER_UID, r->listener_uid);
    av_put_be16(p + ACMP_OFF_SEQ_ID, r->our_seq_id);

    avdecc_eth_send(14 + ACMPDU_LEN);
    s->acmp_tx_count++;
}

// Send an ACMP CONNECT_RX_COMMAND to the MOTU AxC listener — the FPGA acting as a
// CONTROLLER that drives the listener's connection itself (talker-side analog of
// the CRF's avdecc_initiate_listener_connect). FAST-CONNECT: we supply our real
// stream_id + dest_mac, so the AxC needs no slow-path resolve. This is the exact
// frame the switch fires at the AxC routinely (unlike the DISCONNECT that crashed
// the MOTU on 2026-07-04), so the AxC handles it safely. WIRE-PROVEN root: the AxC
// only re-establishes streams IT independently decides are disconnected and the
// switch's boot CONNECT_RX out-races the AxC's own fast-connect; driving the
// connection ourselves removes that race entirely.
// Send the AxC either a DISCONNECT_RX (msg 8) or CONNECT_RX (msg 6) command as a
// CONTROLLER, SLOW-PATH (stream_id=0, dest_mac=0) — byte-shaped exactly like the
// MOTU controller's own re-patch (WIRE-CAPTURED 2026-07-08: DISCONNECT_RX(sid-)
// -> CONNECT_RX(sid-) -> AxC sends us CONNECT_TX). The slow-path is essential: a
// fast-connect CONNECT_RX carrying our real stream_id makes the AxC reply
// "already connected, SUCCESS" and no-op; stream_id=0 forces it to RESOLVE, which
// (after the disconnect un-sticks its stale state) makes it CONNECT_TX us.
static void send_rx_command(avdecc_state_t *s, uint16_t uid, uint8_t msg_type)
{
    if (uid >= AVDECC_MAX_TALKERS || !s->axc_eid_valid) return;
    uint8_t *frame = avdecc_tx_buf();
    uint8_t *p = avdecc_eth_hdr(frame, s->src_mac);

    memset(p, 0, ACMPDU_LEN);
    p[0] = AVTP_SUBTYPE_ACMP;
    p[1] = msg_type;                                        // CONNECT_RX(6) or DISCONNECT_RX(8)
    av_put_be16(p + 2, ACMP_CONTROL_DATA_LEN);
    // stream_id + dest_mac left 0 = SLOW-PATH (matches the working controller).
    memcpy(p + ACMP_OFF_CONTROLLER_ID, s->entity_id, 8);    // we act as the controller
    memcpy(p + ACMP_OFF_TALKER_ID,     s->entity_id, 8);    // WE are the talker
    memcpy(p + ACMP_OFF_LISTENER_ID,   s->axc_eid,   8);    // the MOTU AxC
    av_put_be16(p + ACMP_OFF_TALKER_UID,   uid);
    av_put_be16(p + ACMP_OFF_LISTENER_UID, s->talker_patched_luid[uid]);
    av_put_be16(p + ACMP_OFF_SEQ_ID, s->next_acmp_seq++);

    avdecc_eth_send(14 + ACMPDU_LEN);
    s->acmp_tx_count++;
}

// Snoop the switch's CONNECT_RX aimed at the MOTU AxC for OUR talker streams
// (talker_id==us, listener_id==AxC). We're not the addressee, but this tells us
// which of our streams are patched, plus the AxC entity id + its input index —
// exactly what the talker-reconnect watchdog needs to drive them itself. Re-arms
// the retry budget each time (a fresh switch attempt = a fresh chance / network
// recovery), so it also recovers from link flaps, not just cold boot.
static void acmp_snoop_switch_connect_rx(avdecc_state_t *s, const uint8_t *pdu)
{
    uint16_t tuid = av_get_be16(pdu + ACMP_OFF_TALKER_UID);
    uint16_t luid = av_get_be16(pdu + ACMP_OFF_LISTENER_UID);
    if (tuid >= AVDECC_MAX_TALKERS) return;
    if (!s->axc_eid_valid) {
        memcpy(s->axc_eid, pdu + ACMP_OFF_LISTENER_ID, 8);
        s->axc_eid_valid = 1;
    }
    s->talker_patched[tuid]      = 1;
    s->talker_patched_luid[tuid] = luid;
    s->talker_rc_tries[tuid]     = 0;   // re-arm on every fresh switch attempt
    s->talker_rc_ms[tuid]        = 0;
    s->talker_rc_phase[tuid]     = 0;
}

// Talker-side proactive reconnect watchdog. For each AAF stream the switch has
// tried to patch to the AxC (learned by snoop) that is NOT currently connected,
// drive a CONNECT_RX_COMMAND to the AxC ourselves — every TALKER_RC_RETRY_MS,
// capped at TALKER_RC_MAX_TRIES per switch-attempt so we don't flood if the AxC
// ignores us (the snoop re-arms the budget on the next switch attempt / network
// recovery). Stops for a stream the instant a listener connects. Gated on gPTP
// lock. Call once per main-loop pass.
#define TALKER_RC_RETRY_MS      5000   // between full disconnect+connect cycles
#define TALKER_RC_DISC_CONN_MS  1500   // gap between our DISCONNECT_RX and CONNECT_RX
#define TALKER_RC_MAX_TRIES     6
void avdecc_talker_reconnect_watchdog(avdecc_state_t *s, uint8_t gptp_locked)
{
    if (!gptp_locked || !s->axc_eid_valid) return;
    uint32_t now = gptp_uptime_ms();
    for (uint16_t uid = 0; uid < AVDECC_MAX_TALKERS; uid++) {
        if (!s->talker_patched[uid]) continue;
        if (s->talkers[uid].n_listeners > 0) {      // connected -> done
            s->talker_rc_tries[uid] = 0;
            s->talker_rc_phase[uid] = 0;
            continue;
        }
        if (s->talker_rc_tries[uid] >= TALKER_RC_MAX_TRIES) continue;

        if (s->talker_rc_phase[uid] == 0) {
            // Phase 0: begin a cycle -> DISCONNECT_RX (rate-limited between cycles).
            if (s->talker_rc_ms[uid] != 0 &&
                (now - s->talker_rc_ms[uid]) < TALKER_RC_RETRY_MS) continue;
            s->talker_rc_ms[uid]    = now;
            s->talker_rc_phase[uid] = 1;
            printf("[AVDECC] talker reconnect uid=%u: DISCONNECT_RX (cycle %u)\n",
                   uid, s->talker_rc_tries[uid] + 1);
            send_rx_command(s, uid, ACMP_MSG_DISCONNECT_RX_COMMAND);
        } else {
            // Phase 1: after the gap -> CONNECT_RX (slow-path). The AxC, now
            // un-stuck by the disconnect, resolves and CONNECT_TXes us.
            if ((now - s->talker_rc_ms[uid]) < TALKER_RC_DISC_CONN_MS) continue;
            s->talker_rc_ms[uid]    = now;
            s->talker_rc_phase[uid] = 0;
            s->talker_rc_tries[uid]++;
            printf("[AVDECC] talker reconnect uid=%u: CONNECT_RX (cycle %u)\n",
                   uid, s->talker_rc_tries[uid]);
            send_rx_command(s, uid, ACMP_MSG_CONNECT_RX_COMMAND);
        }
    }
}

// CRF data-flow re-bootstrap watchdog (mirror of avb_session_mgr2's
// forceCrfRefresh + 5 s bootstrap watchdog). Auvitran's CRF talker
// expires on its own side (MSRP LeaveAll / internal state) and stops
// sourcing the stream even while our ACMP connection still reads
// "connected" — Hive then shows the connection green but with a red
// arrow / no black dot, and the MCR starves. Recovery: when CRF data
// stalls while connected, DISCONNECT_TX to clear the talker's stale
// state, then re-issue CONNECT_TX every few seconds to re-trigger it
// until the stream resumes.
//
// `rx_count` is the listener's running CRF-frame counter (mcr.rx_count),
// fed from main.c. `now_ms` is gptp_uptime_ms(). Call once per loop.
#define CRF_WD_STALL_MS   3000    // no CRF for 3 s while connected = stalled
#define CRF_WD_RETRY_MS   5000    // re-issue CONNECT_TX every 5 s

void avdecc_crf_flow_watchdog(avdecc_state_t *s, uint16_t luid,
                              uint32_t rx_count, uint32_t now_ms)
{
    if (luid >= AVDECC_MAX_LISTENERS) return;
    avdecc_listener_stream_t *l = &s->listeners[luid];

    // Not connected → idle; re-baseline so a fresh connect starts clean.
    if (!l->connected) {
        s->crf_wd_init     = 0;
        s->crf_wd_recovery = 0;
        return;
    }
    if (!s->crf_wd_init) {                 // first call after connect
        s->crf_wd_init        = 1;
        s->crf_wd_rx_snapshot = rx_count;
        s->crf_wd_flow_ms     = now_ms;
        s->crf_wd_recovery    = 0;
        return;
    }

    if (rx_count != s->crf_wd_rx_snapshot) {       // CRF flowing
        s->crf_wd_rx_snapshot = rx_count;
        s->crf_wd_flow_ms     = now_ms;
        if (s->crf_wd_recovery) {
            printf("[ACMP] CRF flow restored (uid=%u)\n", (unsigned)luid);
            s->crf_wd_recovery = 0;
        }
        return;
    }

    uint32_t stalled = now_ms - s->crf_wd_flow_ms;
    if (stalled > 2000000000u) {                   // wrap guard
        s->crf_wd_flow_ms = now_ms;
        return;
    }
    if (stalled < CRF_WD_STALL_MS) return;          // not stalled long enough

    // Stalled while connected — re-bootstrap the bound talker.
    avdecc_resolve_t r;
    memset(&r, 0, sizeof(r));
    r.listener_uid = (uint8_t)luid;
    memcpy(r.talker_id, l->talker_id, 8);
    r.talker_uid   = l->talker_uid;
    r.our_seq_id   = s->next_acmp_seq++;

    if (!s->crf_wd_recovery) {
        // Enter recovery: clear the talker's stale state first.
        send_disconnect_tx_command(s, &r, l->stream_id);
        s->crf_wd_recovery      = 1;
        s->crf_wd_last_retry_ms = now_ms;
        printf("[ACMP] CRF stalled %lus while connected — DISCONNECT_TX to "
               "talker, rebootstrapping\n", (unsigned long)(stalled / 1000));
        return;
    }
    // In recovery: re-issue CONNECT_TX every CRF_WD_RETRY_MS until flow returns.
    if (now_ms - s->crf_wd_last_retry_ms >= CRF_WD_RETRY_MS) {
        send_connect_tx_command(s, &r);
        s->crf_wd_last_retry_ms = now_ms;
        printf("[ACMP] CRF rebootstrap — CONNECT_TX to talker (seq=%u)\n",
               (unsigned)r.our_seq_id);
    }
}

// Build and send the deferred CONNECT_RX_RESPONSE to the original
// controller, using the talker's resolved stream_id / dest_mac / vlan.
// The original controller's sequence_id is echoed back so it matches
// up with their outstanding CONNECT_RX_COMMAND state.
// Forward decls — full definitions live near push_unsol_counters().
static void notify_listener_connected   (avdecc_state_t *s, uint16_t uid);
static void notify_listener_disconnected(avdecc_state_t *s, uint16_t uid);

static void send_deferred_connect_rx_response(avdecc_state_t *s,
                                               const avdecc_resolve_t *r,
                                               uint8_t status,
                                               const uint8_t *stream_id,
                                               const uint8_t *dest_mac,
                                               uint16_t vlan_id)
{
    uint8_t *frame = avdecc_tx_buf();
    uint8_t *p = avdecc_eth_hdr(frame, s->src_mac);

    memset(p, 0, ACMPDU_LEN);
    p[0] = AVTP_SUBTYPE_ACMP;
    p[1] = ACMP_MSG_CONNECT_RX_RESPONSE;
    av_put_be16(p + 2, ((uint16_t)(status & 0x1F) << 11) | ACMP_CONTROL_DATA_LEN);
    memcpy(p + ACMP_OFF_STREAM_ID,       stream_id, 8);
    memcpy(p + ACMP_OFF_CONTROLLER_ID,   r->ctrl_eid_orig, 8);
    memcpy(p + ACMP_OFF_TALKER_ID,       r->talker_id, 8);
    memcpy(p + ACMP_OFF_LISTENER_ID,     s->entity_id, 8);
    av_put_be16(p + ACMP_OFF_TALKER_UID,   r->talker_uid);
    av_put_be16(p + ACMP_OFF_LISTENER_UID, r->listener_uid);
    memcpy(p + ACMP_OFF_STREAM_DEST_MAC, dest_mac, 6);
    av_put_be16(p + ACMP_OFF_CONN_COUNT,
                s->listeners[r->listener_uid].connection_count);
    av_put_be16(p + ACMP_OFF_SEQ_ID,   r->ctrl_seq_id_orig);   // echo controller's seq
    av_put_be16(p + ACMP_OFF_FLAGS,    0);
    av_put_be16(p + ACMP_OFF_VLAN_ID,  vlan_id);

    avdecc_eth_send(14 + ACMPDU_LEN);
    s->acmp_tx_count++;
}

// Receive a CONNECT_TX_RESPONSE that's destined for our listener (we
// previously sent the matching CONNECT_TX_COMMAND). Extracts resolved
// stream_id + dst_mac + vlan, binds our listener, and forwards the
// deferred CONNECT_RX_RESPONSE to the original controller.
static void acmp_handle_connect_tx_response(avdecc_state_t *s, const uint8_t *pdu)
{
    // Only our self-sent ones come back with listener_eid == us.
    if (!entity_id_match(pdu + ACMP_OFF_LISTENER_ID, s->entity_id))
        return;

    uint16_t resp_seq = av_get_be16(pdu + ACMP_OFF_SEQ_ID);

    for (int i = 0; i < AVDECC_MAX_LISTENERS; i++) {
        avdecc_resolve_t *r = &s->resolves[i];
        if (!r->active || r->our_seq_id != resp_seq) continue;

        uint8_t status = (pdu[2] >> 3) & 0x1F;
        const uint8_t *resolved_sid = pdu + ACMP_OFF_STREAM_ID;
        const uint8_t *resolved_dst = pdu + ACMP_OFF_STREAM_DEST_MAC;
        uint16_t       resolved_vlan = av_get_be16(pdu + ACMP_OFF_VLAN_ID);

        printf("[ACMP] CONNECT_TX_RESPONSE seq=%u status=%u "
               "sid=%02x:%02x:%02x:%02x:%02x:%02x:%02x:%02x "
               "dest=%02x:%02x:%02x:%02x:%02x:%02x vlan=%u\n",
               resp_seq, status,
               resolved_sid[0], resolved_sid[1], resolved_sid[2], resolved_sid[3],
               resolved_sid[4], resolved_sid[5], resolved_sid[6], resolved_sid[7],
               resolved_dst[0], resolved_dst[1], resolved_dst[2],
               resolved_dst[3], resolved_dst[4], resolved_dst[5],
               resolved_vlan);

        if (status == ACMP_STATUS_SUCCESS) {
            avdecc_listener_stream_t *l = &s->listeners[r->listener_uid];
            memcpy(l->talker_id, r->talker_id, 8);
            l->talker_uid = r->talker_uid;
            memcpy(l->stream_id, resolved_sid, 8);
            memcpy(l->dest_mac,  resolved_dst, 6);
            l->connected = 1;
            l->connection_count++;
            l->stream_vlan_id = resolved_vlan;

            if (s->on_listener_connect)
                s->on_listener_connect(r->listener_uid,
                                        resolved_sid, resolved_dst, r->talker_id);

            notify_listener_connected(s, r->listener_uid);
        }

        send_deferred_connect_rx_response(s, r, status,
                                           resolved_sid, resolved_dst, resolved_vlan);
        r->active = 0;
        return;
    }
    // No matching pending resolve — likely from another listener's transaction
    // or stale; silently ignore.
}

static void acmp_handle_connect_rx(avdecc_state_t *s, const uint8_t *pdu)
{
    // A controller is telling us (listener) to connect to a talker stream
    const uint8_t *talker_id  = pdu + ACMP_OFF_TALKER_ID;
    const uint8_t *stream_id  = pdu + ACMP_OFF_STREAM_ID;
    const uint8_t *dest_mac   = pdu + ACMP_OFF_STREAM_DEST_MAC;
    uint16_t tuid = av_get_be16(pdu + ACMP_OFF_TALKER_UID);
    uint16_t luid = av_get_be16(pdu + ACMP_OFF_LISTENER_UID);

    if (luid >= AVDECC_MAX_LISTENERS) {
        acmp_send_response(s, ACMP_MSG_CONNECT_RX_RESPONSE,
                           ACMP_STATUS_LISTENER_UNKNOWN_ID, pdu);
        return;
    }

    // Two paths per IEEE 1722.1-2013 §8.2.2:
    //
    //   Path A — fast-connect: controller already filled stream_id +
    //            dst_mac (it queried the talker via CONNECT_TX itself).
    //            Bind immediately and respond.
    //
    //   Path B — slow path: stream_id and dst_mac both zero. WE (the
    //            listener) must send ACMP CONNECT_TX_COMMAND to the
    //            talker, await CONNECT_TX_RESPONSE, then send back the
    //            deferred CONNECT_RX_RESPONSE with resolved fields.
    int sid_zero = 1, mac_zero = 1, talker_known = 0;
    for (int i = 0; i < 8; i++) if (stream_id[i]) { sid_zero = 0; break; }
    for (int i = 0; i < 6; i++) if (dest_mac[i])  { mac_zero = 0; break; }
    for (int i = 0; i < 8; i++) if (talker_id[i]) { talker_known = 1; break; }

    if (sid_zero && mac_zero && talker_known) {
        avdecc_resolve_t *r = &s->resolves[luid];
        r->active           = 1;
        r->listener_uid     = (uint8_t)luid;
        r->our_seq_id       = s->next_acmp_seq++;
        memcpy(r->ctrl_eid_orig, pdu + ACMP_OFF_CONTROLLER_ID, 8);
        r->ctrl_seq_id_orig = av_get_be16(pdu + ACMP_OFF_SEQ_ID);
        memcpy(r->talker_id, talker_id, 8);
        r->talker_uid       = tuid;
        r->start_ms         = gptp_uptime_ms();

        printf("[ACMP] CONNECT_RX uid=%u slow-path → query talker "
               "%02x:%02x:%02x:%02x:%02x:%02x:%02x:%02x[%u] (our seq=%u)\n",
               luid,
               talker_id[0], talker_id[1], talker_id[2], talker_id[3],
               talker_id[4], talker_id[5], talker_id[6], talker_id[7], tuid,
               r->our_seq_id);

        send_connect_tx_command(s, r);
        // CONNECT_RX_RESPONSE deferred until CONNECT_TX_RESPONSE arrives
        // (or timeout in avdecc_poll).
        return;
    }

    // Path A — fast connect.
    // Reject the bind if talker_id is all-zero: Hive logs
    // "Listener StreamState notification advertises being connected
    //  but with no Talker Identification" otherwise. A zero talker_id
    // here means the controller didn't fill it AND we couldn't resolve
    // (talker_known check above already routed real cases to slow-path).
    if (!talker_known) {
        acmp_send_response(s, ACMP_MSG_CONNECT_RX_RESPONSE,
                           ACMP_STATUS_TALKER_UNKNOWN_ID, pdu);
        return;
    }
    avdecc_listener_stream_t *l = &s->listeners[luid];
    memcpy(l->talker_id, talker_id, 8);
    l->talker_uid = tuid;
    memcpy(l->stream_id, stream_id, 8);
    memcpy(l->dest_mac, dest_mac, 6);
    l->connected = 1;
    l->connection_count++;

    printf("[AVDECC] CONNECT_RX uid=%u talker=%02x:%02x:%02x:%02x:%02x:%02x:%02x:%02x[%u] "
           "stream=%02x:%02x:%02x:%02x:%02x:%02x:%02x:%02x dest=%02x:%02x:%02x:%02x:%02x:%02x\n",
           luid,
           talker_id[0], talker_id[1], talker_id[2], talker_id[3],
           talker_id[4], talker_id[5], talker_id[6], talker_id[7], tuid,
           stream_id[0], stream_id[1], stream_id[2], stream_id[3],
           stream_id[4], stream_id[5], stream_id[6], stream_id[7],
           dest_mac[0], dest_mac[1], dest_mac[2],
           dest_mac[3], dest_mac[4], dest_mac[5]);

    if (s->on_listener_connect)
        s->on_listener_connect(luid, stream_id, dest_mac, talker_id);

    // Paint the Hive black dot: bump MEDIA_LOCKED (Milan §5.3.8.10 guarded)
    // and push fresh COUNTERS + STREAM_INFO unsolicited responses so the
    // listener row's "active" indicator appears without a manual refresh.
    notify_listener_connected(s, luid);

    acmp_send_response(s, ACMP_MSG_CONNECT_RX_RESPONSE, ACMP_STATUS_SUCCESS, pdu);
}

static void acmp_handle_disconnect_rx(avdecc_state_t *s, const uint8_t *pdu)
{
    uint16_t luid = av_get_be16(pdu + ACMP_OFF_LISTENER_UID);
    if (luid < AVDECC_MAX_LISTENERS) {
        avdecc_listener_stream_t *l = &s->listeners[luid];
        l->connected = 0;
        if (l->connection_count > 0) l->connection_count--;
        if (s->on_listener_disconnect) s->on_listener_disconnect(luid);
        notify_listener_disconnected(s, luid);
    }
    printf("[AVDECC] DISCONNECT_RX uid=%u\n", luid);
    acmp_send_response(s, ACMP_MSG_DISCONNECT_RX_RESPONSE, ACMP_STATUS_SUCCESS, pdu);
}

static void acmp_handle_get_rx_state(avdecc_state_t *s, const uint8_t *pdu)
{
    acmp_send_response(s, ACMP_MSG_GET_RX_STATE_RESPONSE, ACMP_STATUS_SUCCESS, pdu);
}

// ---------------------------------------------------------------------------
// AECP — AVDECC Enumeration and Control Protocol
// ---------------------------------------------------------------------------

// AECP PDU offsets (from PDU start, past Ethernet header)
#define AECP_OFF_TARGET_ID      4
#define AECP_OFF_CONTROLLER_ID  12
#define AECP_OFF_SEQ_ID         20
#define AECP_OFF_CMD_TYPE       22


// Helper: write zero-padded 64-byte name field
static void write_name64(uint8_t *p, const char *s)
{
    memset(p, 0, 64);
    for (int i = 0; i < 63 && s[i]; i++)
        p[i] = s[i];
}

// Build unicast AECP response header, returns PDU pointer (frame + 14)
static uint8_t *aecp_begin_response(uint8_t *frame, const uint8_t *src_mac,
                                     const uint8_t *rx_frame, const uint8_t *rx_pdu)
{
    memcpy(frame, rx_frame + 6, 6);    // dst = sender's MAC (unicast)
    memcpy(frame + 6, src_mac, 6);
    av_put_be16(frame + 12, AVDECC_ETHERTYPE);

    uint8_t *p = frame + 14;
    p[0] = AVTP_SUBTYPE_AECP;
    p[1] = AECP_MSG_AEM_RESPONSE;
    // status/cdl set by caller via aecp_set_status_cdl
    memcpy(p + 4, rx_pdu + 4, 20);     // target_id + controller_id + seq_id + cmd_type
    return p;
}

static void aecp_set_status_cdl(uint8_t *pdu, uint8_t status, uint16_t cdl)
{
    av_put_be16(pdu + 2, ((uint16_t)(status & 0x1F) << 11) | (cdl & 0x7FF));
}

// ---- Descriptor builders ----
// Each writes directly into buffer d, returns descriptor length.

static uint32_t build_desc_entity(uint8_t *d, uint16_t idx, avdecc_state_t *s)
{
    if (idx != 0) return 0;
    // IEEE 1722.1-2013 Section 7.2.1 — 312 bytes
    memset(d, 0, 312);
    av_put_be16(d + 0, AEM_DESC_ENTITY);
    av_put_be16(d + 2, 0);                       // descriptor_index
    memcpy(d + 4, s->entity_id, 8);             // entity_id (unique per device)
    memcpy(d + 12, ENTITY_MODEL_ID, 8);          // entity_model_id (same for all units of this model)
    av_put_be32(d + 20, ADP_CAP_AEM_SUPPORTED |
                        ADP_CAP_VENDOR_UNIQUE_SUPPORTED |
                        ADP_CAP_CLASS_A_SUPPORTED |
                        ADP_CAP_GPTP_SUPPORTED |
                        ADP_CAP_AEM_INTERFACE_INDEX_VALID); // entity_capabilities
    av_put_be16(d + 24, N_STREAM_OUTPUTS);       // talker_stream_sources = 1
    av_put_be16(d + 26, ADP_TALKER_CAP_IMPLEMENTED | ADP_TALKER_CAP_AUDIO_SOURCE);
    av_put_be16(d + 28, N_STREAM_INPUTS);        // listener_stream_sinks = 2
    // listener_capabilities must match the ADP broadcast. MEDIA_CLOCK_SINK
    // is required for CRF listeners — see [[adp-listener-capability-media-clock-sink-required-for-crf]]
    av_put_be16(d + 30, ADP_LISTENER_CAP_IMPLEMENTED |
                        ADP_LISTENER_CAP_MEDIA_CLOCK_SINK |
                        ADP_LISTENER_CAP_AUDIO_SINK);
    av_put_be32(d + 36, s->adp_available_index); // available_index
    // association_id (offset 40, 8 bytes) — left as 0 (memset)
    write_name64(d + 48, "N-Series AVB Switchover"); // entity_name (inline)
    // Localized name refs: STRINGS desc 0 slot N = (0<<3)|N. We populate
    // slot 0="N-Series" (vendor), slot 1="AVB Switchover" (model).
    av_put_be16(d + 112, 0x0000);                // vendor_name_string → "N-Series"
    av_put_be16(d + 114, 0x0001);                // model_name_string → "AVB-AES3 Endpoint"
    write_name64(d + 116, "1.0.0");              // firmware_version (inline)
    // group_name (offset 180, 64 bytes) — empty
    // serial_number at offset 244 (64 bytes inline ASCII). Derived from
    // the MAC's lower 3 bytes so each unit is unique but the format is
    // stable per product (matches working endpoint convention of using
    // an ASCII numeric/short string).
    {
        char sn[16];
        sn[ 0] = 'N'; sn[ 1] = 'S'; sn[ 2] = '-';
        static const char hex[] = "0123456789ABCDEF";
        sn[ 3] = hex[(s->src_mac[3] >> 4) & 0xF];
        sn[ 4] = hex[ s->src_mac[3]       & 0xF];
        sn[ 5] = hex[(s->src_mac[4] >> 4) & 0xF];
        sn[ 6] = hex[ s->src_mac[4]       & 0xF];
        sn[ 7] = hex[(s->src_mac[5] >> 4) & 0xF];
        sn[ 8] = hex[ s->src_mac[5]       & 0xF];
        sn[ 9] = 0;
        write_name64(d + 244, sn);
    }
    av_put_be16(d + 308, 1);                     // configurations_count
    av_put_be16(d + 310, 0);                     // current_configuration
    return 312;
}

static uint32_t build_desc_configuration(uint8_t *d, uint16_t idx)
{
    if (idx != 0) return 0;
    // 7.2.2 — descriptor_counts lists ONLY top-level descriptors.
    // STREAM_PORT_*, AUDIO_CLUSTER, AUDIO_MAP, and STRINGS are children
    // (of AUDIO_UNIT, STREAM_PORT, STREAM_PORT, and LOCALE respectively)
    // and must NOT appear here — Hive rejects the model otherwise.
    // 7 top-level types × 4 bytes = 28; 74 + 28 = 102 bytes.
    memset(d, 0, 106);
    av_put_be16(d, AEM_DESC_CONFIGURATION);
    av_put_be16(d + 2, 0);
    write_name64(d + 4, "Default");
    av_put_be16(d + 68, 0xFFFF);   // localized_description (none)
    av_put_be16(d + 70, 8);        // descriptor_counts_count (7 + CONTROL)
    av_put_be16(d + 72, 74);       // descriptor_counts_offset

    uint8_t *c = d + 74;
    av_put_be16(c +  0, AEM_DESC_AUDIO_UNIT);     av_put_be16(c +  2, 1);
    av_put_be16(c +  4, AEM_DESC_STREAM_INPUT);   av_put_be16(c +  6, N_STREAM_INPUTS);
    av_put_be16(c +  8, AEM_DESC_STREAM_OUTPUT);  av_put_be16(c + 10, N_STREAM_OUTPUTS);
    av_put_be16(c + 12, AEM_DESC_AVB_INTERFACE);  av_put_be16(c + 14, 1);
    av_put_be16(c + 16, AEM_DESC_CLOCK_SOURCE);   av_put_be16(c + 18, N_CLOCK_SOURCES);
    av_put_be16(c + 20, AEM_DESC_LOCALE);         av_put_be16(c + 22, 1);
    av_put_be16(c + 24, AEM_DESC_CLOCK_DOMAIN);   av_put_be16(c + 26, 1);
    av_put_be16(c + 28, AEM_DESC_CONTROL);        av_put_be16(c + 30, N_CONTROLS);
    return 106;
}

static avdecc_state_t *g_self;                        // set in avdecc_init
static void push_unsol_control(avdecc_state_t *s, uint16_t idx);  // fwd (defined late)

// Apply the USB A/B source (shared by SET_CONTROL and OSC /switchover/*).
// Logs to UART and pushes an unsolicited AVDECC notification so Hive updates
// its control value live even when the change came from OSC (not SET_CONTROL).
void avdecc_apply_usb_source(uint8_t v)
{
    g_usb_source = v ? 1 : 0;
#ifdef CSR_MAIN_USB_SOURCE_SELECT_ADDR
    main_usb_source_select_write(g_usb_source);   // drive A/B mux
#endif
    printf("[SWITCH] USB source -> %s\n", g_usb_source ? "Backup" : "Main");
    if (g_self) push_unsol_control(g_self, 0);    // live-update Hive control[0]
}

// ---- control [0] = USB A/B source (LINEAR_UINT8, 0=Main, 1=Backup) ----------
static void ctrl_meta(uint16_t idx, const char **name, uint8_t *mn, uint8_t *mx,
                      uint8_t *stp, uint8_t *def, uint8_t *cur)
{
    (void)idx;
    *name="USB Source (off=Main, on=Backup)"; *mn=0; *mx=1; *stp=1; *def=0;
    *cur = g_usb_source ? 1 : 0;
}

// AVDECC CONTROL descriptor (IEEE 1722.1 §7.2.22).
//   idx 0 = LINEAR_UINT8  (USB source)        -> 104 fixed + 9-byte value = 113
//   idx 1 = UTF8 text     (OSC "a.b.c.d/pfx") -> 104 fixed + string+NUL
static uint32_t build_desc_control(uint8_t *d, uint16_t idx)
{
    if (idx >= N_CONTROLS) return 0;
    memset(d, 0, 160);
    av_put_be16(d,       AEM_DESC_CONTROL);
    av_put_be16(d + 2,   idx);
    av_put_be16(d + 68,  0xFFFF);                 // localized_description (none)
    av_put_be32(d + 82,  0x90e0f000u);            // control_type = ENABLE (generic)
    av_put_be16(d + 94,  104);                    // values_offset
    av_put_be16(d + 96,  1);                      // number_of_values
    av_put_be16(d + 98,  0xFFFF);                 // signal_type = INVALID (config-level)

    if (idx == 1) {                               // OSC IP/Subnet — UTF8 text
        write_name64(d + 4, "OSC IP/Subnet (a.b.c.d/16 or /24)");
        av_put_be16(d + 80, AEM_CONTROL_UTF8);
        char ip[24];
        int n = osc_ip_str(ip, sizeof(ip));
        memcpy(d + 104, ip, n + 1);               // string incl. NUL
        return 104 + n + 1;
    }

    const char *nm; uint8_t mn, mx, stp, def, cur;
    ctrl_meta(idx, &nm, &mn, &mx, &stp, &def, &cur);
    write_name64(d + 4, nm);
    av_put_be16(d + 80, AEM_CONTROL_LINEAR_UINT8);
    d[104] = mn; d[105] = mx; d[106] = stp; d[107] = def; d[108] = cur;
    av_put_be16(d + 109, 0);                       // unit (none)
    av_put_be16(d + 111, 0xFFFF);                  // localized_string (none)
    return 113;
}

static uint32_t build_desc_audio_unit(uint8_t *d, uint16_t idx)
{
    if (idx != 0) return 0;
    // 7.2.3 — 144 fixed + 1 sampling rate (4) = 148 bytes
    memset(d, 0, 148);
    av_put_be16(d, AEM_DESC_AUDIO_UNIT);
    av_put_be16(d + 2, 0);
    write_name64(d + 4, "Audio Unit");
    av_put_be16(d + 68, 0xFFFF);                 // localized_description
    av_put_be16(d + 70, 0);                       // clock_domain_index
    av_put_be16(d + 72, 1);                       // number_of_stream_input_ports
    av_put_be16(d + 74, 0);                       // base_stream_input_port
    av_put_be16(d + 76, N_STREAM_OUTPUTS);        // number_of_stream_output_ports (1 per stream)
    av_put_be16(d + 78, 0);                       // base_stream_output_port
    // 80..95 = other port counts (all 0)
    av_put_be32(d + 136, 48000);                  // current_sampling_rate
    av_put_be16(d + 140, 144);                    // sampling_rates_offset
    av_put_be16(d + 142, 1);                      // sampling_rates_count
    av_put_be32(d + 144, 48000);                  // rate[0]
    return 148;
}

static uint32_t build_desc_stream_input(uint8_t *d, uint16_t idx)
{
    // 7.2.6 — 132 fixed + 1 format (8) = 140 bytes
    if (idx >= N_STREAM_INPUTS) return 0;
    memset(d, 0, 140);
    av_put_be16(d, AEM_DESC_STREAM_INPUT);
    av_put_be16(d + 2, idx);

    const uint8_t *fmt;
    const char *name;
    uint16_t flags;
    if (idx == LISTENER_CRF_INDEX) {
        fmt   = stream_fmt_crf_48k;
        name  = "Media Clock Input";
        flags = STREAM_FLAG_CLOCK_SYNC_SOURCE | STREAM_FLAG_CLASS_A;
    } else {
        fmt   = stream_fmt_aaf_8ch_48k;
        name  = "Audio Input";
        flags = STREAM_FLAG_CLASS_A;
    }

    write_name64(d + 4, name);
    av_put_be16(d + 68, 0xFFFF);                  // localized_description
    av_put_be16(d + 70, 0);                       // clock_domain_index
    av_put_be16(d + 72, flags);                   // stream_flags
    memcpy(d + 74, fmt, 8);                       // current_format
    av_put_be16(d + 82, 132);                     // formats_offset
    av_put_be16(d + 84, 1);                       // number_of_formats
    // 86..103 = backup_talker_*  (zeroed)
    av_put_be16(d + 104, 0);                      // avb_interface_index
    av_put_be32(d + 106, 2000000);                // buffer_length (2ms in ns)
    memcpy(d + 132, fmt, 8);                      // format[0]
    return 140;
}

static uint32_t build_desc_stream_output(uint8_t *d, uint16_t idx)
{
    if (idx >= N_STREAM_OUTPUTS) return 0;
    memset(d, 0, 140);
    av_put_be16(d, AEM_DESC_STREAM_OUTPUT);
    av_put_be16(d + 2, idx);
    write_name64(d + 4, "Audio Output");
    av_put_be16(d + 68, 0xFFFF);
    av_put_be16(d + 70, 0);                       // clock_domain_index
    av_put_be16(d + 72, STREAM_FLAG_CLASS_A);
    memcpy(d + 74, stream_fmt_aaf_8ch_48k, 8);
    av_put_be16(d + 82, 132);
    av_put_be16(d + 84, 1);
    av_put_be16(d + 104, 0);
    av_put_be32(d + 106, 2000000);
    memcpy(d + 132, stream_fmt_aaf_8ch_48k, 8);
    return 140;
}

static uint32_t build_desc_avb_interface(uint8_t *d, uint16_t idx, avdecc_state_t *s)
{
    if (idx != 0) return 0;
    // 7.2.8 — 98 bytes (jdksavdecc JDKSAVDECC_DESCRIPTOR_AVB_INTERFACE_LEN).
    // Per IEEE 1722.1-2013, msrp_mappings are NOT inside this descriptor;
    // sending the older 104-byte form caused Hive payload-size mismatches
    // for some derived parsers. Use the canonical 98-byte layout.
    //
    // priority1/clock_class/etc are the GM values learned from Announce
    // (when we're a slave they belong to the upstream GM); fall back to
    // "slave-only / not GM-capable" defaults until first Announce.
    memset(d, 0, 98);
    av_put_be16(d, AEM_DESC_AVB_INTERFACE);
    av_put_be16(d + 2, 0);
    write_name64(d + 4, "Ethernet");
    av_put_be16(d + 68, 0xFFFF);                  // localized_description
    memcpy(d + 70, s->src_mac, 6);                // mac_address
    av_put_be16(d + 76, AVB_INTERFACE_FLAG_GPTP_SUPPORTED |
                        AVB_INTERFACE_FLAG_SRP_SUPPORTED);

    // clock_identity = our local gPTP clock identity (MAC + FF:FE), not entity_id.
    if (g_gptp)
        memcpy(d + 78, g_gptp->clock_id, 8);
    else
        memcpy(d + 78, s->entity_id, 8);

    if (g_gptp && g_gptp->gm_valid) {
        d[86] = g_gptp->gm_priority1;
        d[87] = g_gptp->gm_clock_class;
        av_put_be16(d + 88, g_gptp->gm_offset_scaled_log_variance);
        d[90] = g_gptp->gm_clock_accuracy;
        d[91] = g_gptp->gm_priority2;
    } else {
        d[86] = 248;                              // priority1 (slave-only)
        d[87] = 248;                              // clock_class (slave-only)
        av_put_be16(d + 88, 0x4E5D);              // offset_scaled_log_variance default
        d[90] = 0xFE;                             // clock_accuracy (unknown)
        d[91] = 248;                              // priority2
    }
    d[92] = 0;                                    // domain_number
    d[93] = LOG_SYNC_INTERVAL;                    // log_sync_interval
    d[94] = LOG_ANNOUNCE_INTERVAL;                // log_announce_interval
    d[95] = LOG_PDELAY_REQ_INTERVAL;              // log_pdelay_interval
    av_put_be16(d + 96, 1);                       // port_number
    return 98;
}

static uint32_t build_desc_clock_source(uint8_t *d, uint16_t idx, avdecc_state_t *s)
{
    if (idx >= N_CLOCK_SOURCES) return 0;
    // 7.2.9 — 86 bytes
    memset(d, 0, 86);
    av_put_be16(d, AEM_DESC_CLOCK_SOURCE);
    av_put_be16(d + 2, idx);

    if (idx == CLK_SRC_INTERNAL) {
        write_name64(d + 4, "Internal");
        av_put_be16(d + 68, 0xFFFF);
        av_put_be16(d + 70, 0);                   // flags
        av_put_be16(d + 72, CLOCK_SOURCE_TYPE_INTERNAL);
        memcpy(d + 74, s->entity_id, 8);          // identifier
        av_put_be16(d + 82, AEM_DESC_AUDIO_UNIT); // location_type
        av_put_be16(d + 84, 0);                   // location_index
    } else {
        write_name64(d + 4, "Media Clock");
        av_put_be16(d + 68, 0xFFFF);
        av_put_be16(d + 70, 0);
        av_put_be16(d + 72, CLOCK_SOURCE_TYPE_INPUT_STREAM);
        memcpy(d + 74, s->entity_id, 8);
        av_put_be16(d + 82, AEM_DESC_STREAM_INPUT);
        av_put_be16(d + 84, LISTENER_CRF_INDEX);  // points at CRF stream
    }
    return 86;
}

static uint32_t build_desc_clock_domain(uint8_t *d, uint16_t idx, avdecc_state_t *s)
{
    if (idx != 0) return 0;
    // 7.2.10 — 76 fixed + N_CLOCK_SOURCES × 2 bytes
    uint32_t len = 76 + N_CLOCK_SOURCES * 2;
    memset(d, 0, len);
    av_put_be16(d, AEM_DESC_CLOCK_DOMAIN);
    av_put_be16(d + 2, 0);
    write_name64(d + 4, "Clock Domain");
    av_put_be16(d + 68, 0xFFFF);
    // Defensive clamp: if current_clock_source somehow drifts out of
    // range, Hive logs "Reference for Domain 0: AEM Error" and treats
    // the whole entity as malformed (refuses to patch listeners → CRF
    // never arrives, MCR never binds, debugging spirals). Clamp to 0
    // (Internal) so the descriptor always references a valid source.
    uint16_t cs = s->current_clock_source;
    if (cs >= N_CLOCK_SOURCES) cs = 0;
    av_put_be16(d + 70, cs);                       // clock_source_index (dynamic, clamped)
    av_put_be16(d + 72, 76);                       // clock_sources_offset
    av_put_be16(d + 74, N_CLOCK_SOURCES);          // clock_sources_count
    for (uint16_t i = 0; i < N_CLOCK_SOURCES; i++)
        av_put_be16(d + 76 + 2 * i, i);
    return len;
}

static uint32_t build_desc_locale(uint8_t *d, uint16_t idx)
{
    if (idx != 0) return 0;
    // 7.2.11 — 72 bytes (jdksavdecc JDKSAVDECC_DESCRIPTOR_LOCALE_LEN)
    //  +0   descriptor_type
    //  +2   descriptor_index
    //  +4   locale_identifier (64 bytes)
    //  +68  number_of_strings
    //  +70  base_strings (index of first STRINGS descriptor used by this locale)
    memset(d, 0, 72);
    av_put_be16(d, AEM_DESC_LOCALE);
    av_put_be16(d + 2, 0);
    const char *loc = "en-US";
    memcpy(d + 4, loc, 5);
    av_put_be16(d + 68, 1);   // number_of_strings (1 STRINGS desc with 7 slots)
    av_put_be16(d + 70, 0);   // base_strings = 0
    return 72;
}

// 7-string STRINGS descriptor: each string is fixed 64 bytes.
// strings[0] = "AVB-AES3", strings[1] = "Audio Unit", etc.
static uint32_t build_desc_strings(uint8_t *d, uint16_t idx)
{
    if (idx != 0) return 0;
    // 7.2.12 — 4 header + 7 × 64 string slots = 452 bytes
    memset(d, 0, 452);
    av_put_be16(d, AEM_DESC_STRINGS);
    av_put_be16(d + 2, 0);
    static const char *const strs[7] = {
        "N-Series",          // 0 — vendor_name_string in ENTITY
        "AVB Switchover",    // 1 — model_name_string in ENTITY
        "Audio Unit",        // 2
        "Media Clock Input", // 3
        "Audio Input",       // 4
        "Audio Output",      // 5
        "Clock Domain"       // 6
    };
    for (int i = 0; i < 7; i++)
        write_name64(d + 4 + i * 64, strs[i]);
    return 452;
}

static uint32_t build_desc_stream_port(uint8_t *d, uint16_t desc_type, uint16_t idx)
{
    // 1 input stream-port (AAF listener); N_STREAM_OUTPUTS output stream-ports
    // (one per 8ch AAF talker stream). 0 clusters/0 maps on each (channel info
    // is in the stream_format) — matches the Hive-validated session_mgr.aemt.
    uint16_t max_idx = (desc_type == AEM_DESC_STREAM_PORT_OUTPUT) ? N_STREAM_OUTPUTS : 1;
    if (idx >= max_idx) return 0;
    // 7.2.13 — 20 bytes (jdksavdecc JDKSAVDECC_DESCRIPTOR_STREAM_PORT_LEN)
    //  +0  desc_type
    //  +2  desc_index
    //  +4  clock_domain_index
    //  +6  port_flags
    //  +8  number_of_controls
    // +10  base_control
    // +12  number_of_clusters
    // +14  base_cluster
    // +16  number_of_maps
    // +18  base_map
    //
    // Channel info comes from the stream_format (AAF specifies 8ch); the
    // working session_mgr.aemt uses 0 clusters / 0 maps on its stream_ports
    // — matching that gets Milan-compliant validation through Hive.
    memset(d, 0, 20);
    av_put_be16(d +  0, desc_type);
    av_put_be16(d +  2, idx);                              // descriptor_index
    av_put_be16(d +  4, 0);                                // clock_domain_index
    av_put_be16(d +  6, STREAM_PORT_FLAG_CLOCK_SYNC_SOURCE);
    av_put_be16(d +  8, 0);                                // number_of_controls
    av_put_be16(d + 10, 0);                                // base_control
    av_put_be16(d + 12, 0);                                // number_of_clusters
    av_put_be16(d + 14, 0);                                // base_cluster
    av_put_be16(d + 16, 0);                                // number_of_maps
    av_put_be16(d + 18, 0);                                // base_map
    return 20;
}

// ---- MVU (Milan Vendor Unique) command handler ----
//
// Wire layout inside the AECPDU:
//   tp+0..3   subtype/sv/ver/mt + status/cdl  (AVTPDU common)
//   tp+4..11  target_entity_id
//   tp+12..19 controller_entity_id
//   tp+20..21 sequence_id
//   tp+22..27 protocol_identifier (6)        ← MVU header begins here
//   tp+28..29 u(1) | command_type(15)
//   tp+30+    command_specific_data
//
// Hive issues MvuCommandType::GetMilanInfo immediately after enumeration
// when VendorUniqueSupported is advertised. Failing to respond inflates
// AECP retry counters and flags the entity red in the patch matrix.
static void mvu_handle(avdecc_state_t *s, const uint8_t *frame,
                        const uint8_t *pdu, uint32_t pdu_len)
{
    if (pdu_len < 30) return;

    // Must target our entity
    if (!entity_id_match(pdu + AECP_OFF_TARGET_ID, s->entity_id))
        return;

    static const uint8_t mvu_pid[6] = MVU_PROTOCOL_ID;
    {
        int diff = 0;
        for (int i = 0; i < 6; i++) diff |= pdu[22 + i] ^ mvu_pid[i];
        if (diff) return;   // not Milan VU — ignore other vendors' protocol_id
    }

    s->aecp_rx_count++;

    uint16_t cmd_type = av_get_be16(pdu + 28) & 0x7FFF;

    uint8_t *tf = avdecc_tx_buf();
    // Build response by copying the request frame and flipping msg_type.
    memcpy(tf, frame + 6, 6);          // dst = sender's MAC (unicast)
    memcpy(tf + 6, s->src_mac, 6);
    av_put_be16(tf + 12, AVDECC_ETHERTYPE);
    uint8_t *tp = tf + 14;
    memcpy(tp, pdu, 30);               // header + protocol_id + u|cmd_type
    tp[1] = AECP_MSG_VENDOR_UNIQUE_RESPONSE;
    av_put_be16(tp + 28, cmd_type);    // clear u bit on response

    if (cmd_type == MVU_CMD_GET_MILAN_INFO) {
        // 14-byte response payload (Milan 1.3 §5.4.4.1):
        //   +0..1   reserved16        = 0
        //   +2..5   protocol_version  = 1
        //   +6..9   features_flags    = 0
        //  +10..13  certification_ver = 0x01020000 (Milan v1.2)
        av_put_be16(tp + 30, 0);            // reserved
        av_put_be32(tp + 32, 1);            // protocol_version
        av_put_be32(tp + 36, 0);            // features_flags
        av_put_be32(tp + 40, 0x01020000);   // certification_version = Milan 1.2
        // CDL = AECPDU - 12 = (4 + 8 + 8 + 2 + 6 + 2 + 14) - 12 = 32
        aecp_set_status_cdl(tp, AECP_STATUS_SUCCESS, 32);
        avdecc_eth_send(64);            // 14 + 44 = 58 < 64, pad
    } else if (cmd_type == MVU_CMD_GET_STREAM_INPUT_INFO_EX) {
        // 18-byte response payload (Milan 1.3 §5.4.4.8):
        //   +0..1   reserved16 = 0
        //   +2..3   descriptor_type
        //   +4..5   descriptor_index
        //   +6..13  talker_entity_id
        //  +14..15  talker_stream_index
        //   +16    probing_status(3 bits, MSB) | acmp_status(5 bits, LSB)
        //   +17    reserved8 = 0
        // ProbingStatus values (Milan 1.3 §5.4.3.2.7.4):
        //   0 = Disabled, 1 = Passive, 2 = Active, 3 = Completed
        // For our listener: Disabled when not connected, Completed when
        // connected (we don't run a real Probing state machine — listener
        // is a single-step binding via ACMP CONNECT_RX).
        if (pdu_len < 34) return;
        uint16_t dt = av_get_be16(pdu + 30);
        uint16_t di = av_get_be16(pdu + 32);

        av_put_be16(tp + 30, 0);                          // reserved16
        av_put_be16(tp + 32, dt);                         // descriptor_type
        av_put_be16(tp + 34, di);                         // descriptor_index

        uint8_t probing = 0;      // Disabled by default
        uint8_t acmp_st = 0;      // Success
        if (dt == AEM_DESC_STREAM_INPUT && di < AVDECC_MAX_LISTENERS) {
            const avdecc_listener_stream_t *l = &s->listeners[di];
            if (l->connected) {
                memcpy(tp + 36, l->talker_id, 8);
                av_put_be16(tp + 44, l->talker_uid);
                probing = 3;                              // Completed
            } else {
                memset(tp + 36, 0, 8);
                av_put_be16(tp + 44, 0);
            }
        } else {
            memset(tp + 36, 0, 8);
            av_put_be16(tp + 44, 0);
        }
        tp[46] = ((probing & 0x07) << 5) | (acmp_st & 0x1F);
        tp[47] = 0;                                       // reserved8

        // CDL = AECPDU - 12 = (4 + 8 + 8 + 2 + 6 + 2 + 18) - 12 = 36
        aecp_set_status_cdl(tp, AECP_STATUS_SUCCESS, 36);
        avdecc_eth_send(64);            // 14 + 48 = 62 < 64, pad
    } else {
        // Unknown MVU command — respond NOT_IMPLEMENTED with the original
        // payload echoed back (matches working endpoint behaviour). Keeps
        // Hive's retry counter at zero for non-fatal commands.
        uint16_t orig_cdl = av_get_be16(pdu + 2) & 0x7FF;
        uint32_t aecpdu_len = 12 + orig_cdl;
        if (aecpdu_len > 500) aecpdu_len = 500;
        if (aecpdu_len > pdu_len) aecpdu_len = pdu_len;
        memcpy(tp, pdu, aecpdu_len);
        tp[1] = AECP_MSG_VENDOR_UNIQUE_RESPONSE;
        aecp_set_status_cdl(tp, AECP_STATUS_NOT_IMPLEMENTED, orig_cdl);
        uint32_t flen = 14 + aecpdu_len;
        if (flen < 64) flen = 64;
        avdecc_eth_send(flen);
    }
    s->aecp_tx_count++;
}

// ---- AECP command handler ----

static void aecp_handle(avdecc_state_t *s, const uint8_t *frame,
                         const uint8_t *pdu, uint32_t pdu_len)
{
    uint8_t msg_type = pdu[1] & 0x0F;

    if (msg_type == AECP_MSG_VENDOR_UNIQUE_COMMAND) {
        mvu_handle(s, frame, pdu, pdu_len);
        return;
    }
    if (msg_type != AECP_MSG_AEM_COMMAND)
        return;

    if (!entity_id_match(pdu + AECP_OFF_TARGET_ID, s->entity_id))
        return;

    s->aecp_rx_count++;

    uint16_t cmd_type = av_get_be16(pdu + AECP_OFF_CMD_TYPE) & 0x7FFF;

    switch (cmd_type) {

    case AEM_CMD_READ_DESCRIPTOR: {
        if (pdu_len < 32) return;

        uint16_t desc_type  = av_get_be16(pdu + 28);
        uint16_t desc_index = av_get_be16(pdu + 30);

        uint8_t *tf = avdecc_tx_buf();
        uint8_t *tp = aecp_begin_response(tf, s->src_mac, frame, pdu);
        av_put_be16(tp + 24, av_get_be16(pdu + 24));  // echo config_index
        av_put_be16(tp + 26, 0);                        // reserved

        uint8_t *desc = tp + 28;
        uint32_t desc_len = 0;

        switch (desc_type) {
            case AEM_DESC_ENTITY:
                desc_len = build_desc_entity(desc, desc_index, s); break;
            case AEM_DESC_CONFIGURATION:
                desc_len = build_desc_configuration(desc, desc_index); break;
            case AEM_DESC_AUDIO_UNIT:
                desc_len = build_desc_audio_unit(desc, desc_index); break;
            case AEM_DESC_STREAM_INPUT:
                desc_len = build_desc_stream_input(desc, desc_index); break;
            case AEM_DESC_STREAM_OUTPUT:
                desc_len = build_desc_stream_output(desc, desc_index); break;
            case AEM_DESC_AVB_INTERFACE:
                desc_len = build_desc_avb_interface(desc, desc_index, s); break;
            case AEM_DESC_CLOCK_SOURCE:
                desc_len = build_desc_clock_source(desc, desc_index, s); break;
            case AEM_DESC_CLOCK_DOMAIN:
                desc_len = build_desc_clock_domain(desc, desc_index, s); break;
            case AEM_DESC_CONTROL:
                desc_len = build_desc_control(desc, desc_index); break;
            case AEM_DESC_LOCALE:
                desc_len = build_desc_locale(desc, desc_index); break;
            case AEM_DESC_STRINGS:
                desc_len = build_desc_strings(desc, desc_index); break;
            case AEM_DESC_STREAM_PORT_INPUT:
            case AEM_DESC_STREAM_PORT_OUTPUT:
                desc_len = build_desc_stream_port(desc, desc_type, desc_index); break;
            default:
                break;
        }

        if (desc_len == 0) {
            aecp_set_status_cdl(tp, AECP_STATUS_NOT_IMPLEMENTED, 16);
            avdecc_eth_send(14 + 28);
            s->aecp_tx_count++;
            return;
        }

        aecp_set_status_cdl(tp, AECP_STATUS_SUCCESS, 16 + desc_len);
        uint32_t flen = 14 + 28 + desc_len;
        if (flen < 64) flen = 64;
        avdecc_eth_send(flen);
        s->aecp_tx_count++;
        break;
    }

    case AEM_CMD_ACQUIRE_ENTITY:
    case AEM_CMD_LOCK_ENTITY: {
        // Payload: flags(4) | owner/locked_id(8) | desc_type(2) | desc_index(2)
        //
        // The "release" flag bit lives in DIFFERENT positions between
        // ACQUIRE_ENTITY and LOCK_ENTITY (verified against la_avdecc
        // src/protocol/protocolDefines.cpp):
        //   AemAcquireEntityFlags::Release = 0x80000000  (bit 31, MSB)
        //   AemLockEntityFlags::Unlock     = 0x00000001  (bit 0,  LSB)
        // Hive flags "LockingEntity field is not set to 0 on UnlockEntity
        // response" if we treat them the same — the owner_id/locked_id
        // MUST be 8 zero bytes on a successful RELEASE or UNLOCK.
        if (pdu_len < 40) return;
        uint32_t flags = av_get_be32(pdu + 24);
        int is_release;
        if (cmd_type == AEM_CMD_ACQUIRE_ENTITY)
            is_release = (flags & 0x80000000u) ? 1 : 0;
        else
            is_release = (flags & 0x00000001u) ? 1 : 0;

        uint8_t *tf = avdecc_tx_buf();
        uint8_t *tp = aecp_begin_response(tf, s->src_mac, frame, pdu);
        memcpy(tp + 24, pdu + 24, 16);    // echo flags + owner + desc_type + desc_index

        if (is_release)
            memset(tp + 28, 0, 8);        // owner/locked_id = 0
        else
            memcpy(tp + 28, pdu + AECP_OFF_CONTROLLER_ID, 8);

        aecp_set_status_cdl(tp, AECP_STATUS_SUCCESS, 28);
        avdecc_eth_send(64);              // 14 + 38 = 52, pad to 64
        s->aecp_tx_count++;
        break;
    }

    case AEM_CMD_GET_STREAM_FORMAT: {
        if (pdu_len < 28) return;
        uint16_t dt = av_get_be16(pdu + 24);
        uint16_t di = av_get_be16(pdu + 26);
        const uint8_t *fmt = NULL;
        if (dt == AEM_DESC_STREAM_INPUT) {
            if (di == LISTENER_CRF_INDEX)      fmt = stream_fmt_crf_48k;
            else if (di == LISTENER_AAF_INDEX) fmt = stream_fmt_aaf_8ch_48k;
        } else if (dt == AEM_DESC_STREAM_OUTPUT && di < AVDECC_MAX_TALKERS) {
            // ALL N time-mux talker outputs are the same AAF 8ch/48k format —
            // not just index 0. Returning NO_SUCH_DESCRIPTOR for outputs 1..N-1
            // made controllers/listeners treat those streams as broken and
            // refuse to connect them (only output 0 was usable). (#69)
            fmt = stream_fmt_aaf_8ch_48k;
        }
        uint8_t *tf = avdecc_tx_buf();
        uint8_t *tp = aecp_begin_response(tf, s->src_mac, frame, pdu);
        memcpy(tp + 24, pdu + 24, 4);                 // echo desc_type + desc_index
        if (fmt) {
            memcpy(tp + 28, fmt, 8);
            aecp_set_status_cdl(tp, AECP_STATUS_SUCCESS, 24);
        } else {
            memset(tp + 28, 0, 8);
            aecp_set_status_cdl(tp, AECP_STATUS_NO_SUCH_DESCRIPTOR, 24);
        }
        avdecc_eth_send(64);  // 14 + 36 = 50, pad to 64
        s->aecp_tx_count++;
        break;
    }

    case AEM_CMD_SET_STREAM_FORMAT: {
        // Payload: desc_type(2) desc_index(2) stream_format(8)
        if (pdu_len < 36) return;
        uint16_t dt = av_get_be16(pdu + 24);
        uint16_t di = av_get_be16(pdu + 26);
        const uint8_t *want = pdu + 28;

        const uint8_t *expect = NULL;
        if (dt == AEM_DESC_STREAM_INPUT) {
            if (di == LISTENER_CRF_INDEX)      expect = stream_fmt_crf_48k;
            else if (di == LISTENER_AAF_INDEX) expect = stream_fmt_aaf_8ch_48k;
        } else if (dt == AEM_DESC_STREAM_OUTPUT && di < AVDECC_MAX_TALKERS) {
            expect = stream_fmt_aaf_8ch_48k;   // all N talker outputs, not just 0 (#69)
        }

        uint8_t st;
        if (!expect) {
            st = AECP_STATUS_NO_SUCH_DESCRIPTOR;
        } else {
            // Be permissive on Listener-side STREAM_INPUT — talkers (Auvitran
            // observed) send SET_STREAM_FORMAT before starting their stream,
            // and a strict byte-exact mismatch reply makes them refuse to
            // stream. The actual format is constrained by the wire content
            // (CRF/AAF subtype + parameters); the listener has no real
            // freedom to "set" it anyway. Accept and log for STREAM_INPUT;
            // strict check only on STREAM_OUTPUT (we control that one).
            int diff = 0;
            for (int i = 0; i < 8; i++)
                diff |= want[i] ^ expect[i];
            if (dt == AEM_DESC_STREAM_INPUT) {
                st = AECP_STATUS_SUCCESS;
                if (diff) {
                    printf("[AVDECC] SET_STREAM_FORMAT INPUT[%u] format diff "
                           "%02x%02x%02x%02x%02x%02x%02x%02x → accepted anyway\n",
                           di, want[0], want[1], want[2], want[3],
                           want[4], want[5], want[6], want[7]);
                }
            } else {
                st = diff ? AECP_STATUS_BAD_ARGUMENTS : AECP_STATUS_SUCCESS;
            }
        }

        uint8_t *tf = avdecc_tx_buf();
        uint8_t *tp = aecp_begin_response(tf, s->src_mac, frame, pdu);
        memcpy(tp + 24, pdu + 24, 12);                // echo desc_type+idx+format
        aecp_set_status_cdl(tp, st, 24);
        avdecc_eth_send(64);
        s->aecp_tx_count++;
        printf("[AVDECC] SET_STREAM_FORMAT dt=%u di=%u -> status=%u\n", dt, di, st);
        break;
    }

    case AEM_CMD_GET_CLOCK_SOURCE: {
        // Payload (response): desc_type(2) desc_index(2) clock_source_index(2) rsvd(2)
        if (pdu_len < 28) return;
        uint16_t dt = av_get_be16(pdu + 24);
        uint16_t di = av_get_be16(pdu + 26);
        uint8_t st = (dt == AEM_DESC_CLOCK_DOMAIN && di == 0)
                       ? AECP_STATUS_SUCCESS : AECP_STATUS_NO_SUCH_DESCRIPTOR;
        uint8_t *tf = avdecc_tx_buf();
        uint8_t *tp = aecp_begin_response(tf, s->src_mac, frame, pdu);
        memcpy(tp + 24, pdu + 24, 4);                 // echo desc_type+idx
        av_put_be16(tp + 28, s->current_clock_source);
        av_put_be16(tp + 30, 0);                       // reserved
        aecp_set_status_cdl(tp, st, 20);
        avdecc_eth_send(64);
        s->aecp_tx_count++;
        break;
    }

    case AEM_CMD_GET_CONTROL: {
        // control[0] LINEAR_UINT8 -> 1-byte value; control[1] UTF8 -> string.
        if (pdu_len < 28) return;
        uint16_t dt = av_get_be16(pdu + 24);
        uint16_t di = av_get_be16(pdu + 26);
        uint8_t *tf = avdecc_tx_buf();
        uint8_t *tp = aecp_begin_response(tf, s->src_mac, frame, pdu);
        memcpy(tp + 24, pdu + 24, 4);                 // echo desc_type + index

        if (dt == AEM_DESC_CONTROL && di == 1) {      // OSC IP/Subnet — UTF8
            char ip[24]; int n = osc_ip_str(ip, sizeof(ip));
            memcpy(tp + 28, ip, n + 1);
            aecp_set_status_cdl(tp, AECP_STATUS_SUCCESS, 12 + 4 + n + 1);
            uint32_t flen = 14 + 28 + (uint32_t)n + 1; if (flen < 64) flen = 64;
            avdecc_eth_send(flen);
            s->aecp_tx_count++;
            break;
        }
        uint8_t st;
        if (dt == AEM_DESC_CONTROL && di < N_CONTROLS) {
            const char *nm; uint8_t mn, mx, stp, def, cur;
            ctrl_meta(di, &nm, &mn, &mx, &stp, &def, &cur);
            tp[28] = cur; st = AECP_STATUS_SUCCESS;
        } else {
            tp[28] = 0;   st = AECP_STATUS_NO_SUCH_DESCRIPTOR;
        }
        aecp_set_status_cdl(tp, st, 12 + 5);
        avdecc_eth_send(64);
        s->aecp_tx_count++;
        break;
    }

    case AEM_CMD_SET_CONTROL: {
        if (pdu_len < 28) return;
        uint16_t dt = av_get_be16(pdu + 24);
        uint16_t di = av_get_be16(pdu + 26);

        if (dt == AEM_DESC_CONTROL && di == 1) {      // OSC IP/Subnet — UTF8 text
            char buf[40]; uint32_t k = 0;
            while (k < sizeof(buf) - 1 && (28u + k) < pdu_len && pdu[28 + k]) {
                buf[k] = (char)pdu[28 + k]; k++;
            }
            buf[k] = 0;
            uint8_t st;
            if (osc_parse_ipstr(buf)) {
                st = AECP_STATUS_SUCCESS;
                for (int j = 0; j < 4; j++) g_cfg.osc_ip[j] = g_osc_ip[j];
                g_cfg.osc_prefix = g_osc_prefix;
                cfg_save();                                    // persist to NV flash
            } else {
                st = AECP_STATUS_BAD_ARGUMENTS;
            }
            char ip[24]; int n = osc_ip_str(ip, sizeof(ip));   // echo current
            uint8_t *tf = avdecc_tx_buf();
            uint8_t *tp = aecp_begin_response(tf, s->src_mac, frame, pdu);
            memcpy(tp + 24, pdu + 24, 4);
            memcpy(tp + 28, ip, n + 1);
            aecp_set_status_cdl(tp, st, 12 + 4 + n + 1);
            uint32_t flen = 14 + 28 + (uint32_t)n + 1; if (flen < 64) flen = 64;
            avdecc_eth_send(flen);
            s->aecp_tx_count++;
            printf("[AVDECC] SET_CONTROL OSC IP -> %s (status=%u)\n", ip, st);
            break;
        }

        // control[0] = USB source (LINEAR_UINT8, 0=Main/1=Backup)
        uint8_t st = AECP_STATUS_SUCCESS;
        if (dt != AEM_DESC_CONTROL || di != 0)
            st = AECP_STATUS_NO_SUCH_DESCRIPTOR;
        else if (pdu_len >= 29)
            avdecc_apply_usb_source(pdu[28] ? 1 : 0);
        uint8_t cur = g_usb_source ? 1 : 0;
        uint8_t *tf = avdecc_tx_buf();
        uint8_t *tp = aecp_begin_response(tf, s->src_mac, frame, pdu);
        memcpy(tp + 24, pdu + 24, 4);
        tp[28] = cur;
        aecp_set_status_cdl(tp, st, 12 + 5);
        avdecc_eth_send(64);
        s->aecp_tx_count++;
        break;
    }

    case AEM_CMD_GET_AS_PATH: {
        // Milan 1.3 §5.4.4 mandatory. Response payload (12 bytes from
        // after cmd_type, IEEE 1722.1-2013 §7.4.41.2):
        //   +0   descriptor_index (2) — echoed AVB_INTERFACE index
        //   +2   count (2) — number of clock_identity entries
        //   +4   path[count] (count × 8 bytes)
        //
        // We return a single-entry path containing the current GM's
        // clock_id (we're directly bridged to it as far as gPTP knows;
        // there's no upstream boundary clock chain we measure). Same
        // approach the working endpoint takes.
        if (pdu_len < 26) return;
        uint16_t di = av_get_be16(pdu + 24);

        uint8_t *tf = avdecc_tx_buf();
        uint8_t *tp = aecp_begin_response(tf, s->src_mac, frame, pdu);
        av_put_be16(tp + 24, di);
        av_put_be16(tp + 26, 1);              // count = 1 entry
        if (g_gptp && g_gptp->gm_valid)
            memcpy(tp + 28, g_gptp->gm_clock_id, 8);
        else
            memset(tp + 28, 0, 8);
        // CDL = AECPDU - 12 = (4 + 8 + 8 + 2 + 2 + 12) - 12 = 24
        aecp_set_status_cdl(tp, AECP_STATUS_SUCCESS, 24);
        avdecc_eth_send(64);                  // 14 + 36 = 50, pad to 64
        s->aecp_tx_count++;
        break;
    }

    case AEM_CMD_GET_AVB_INFO: {
        // Milan 1.3 §5.4.4 mandatory dynamic info. Response payload (20
        // bytes from after cmd_type, IEEE 1722.1-2013 §7.4.40.2):
        //   +0   descriptor_type (2)        — should be AVB_INTERFACE
        //   +2   descriptor_index (2)
        //   +4   gptp_grandmaster_id (8)
        //   +12  propagation_delay (4)      — ns, our learned Pdelay
        //   +16  gptp_domain_number (1)
        //   +17  flags (1) — bit0 AS_CAPABLE | bit1 GPTP_ENABLED | bit2 SRP_ENABLED
        //   +18  msrp_mappings_count (2)    — 0 = no SR class mappings inline
        if (pdu_len < 28) return;
        uint16_t dt = av_get_be16(pdu + 24);
        uint16_t di = av_get_be16(pdu + 26);
        uint8_t st = (dt == AEM_DESC_AVB_INTERFACE && di == 0)
                       ? AECP_STATUS_SUCCESS : AECP_STATUS_NO_SUCH_DESCRIPTOR;

        uint8_t *tf = avdecc_tx_buf();
        uint8_t *tp = aecp_begin_response(tf, s->src_mac, frame, pdu);
        av_put_be16(tp + 24, dt);
        av_put_be16(tp + 26, di);
        if (g_gptp && g_gptp->gm_valid)
            memcpy(tp + 28, g_gptp->gm_clock_id, 8);
        else
            memset(tp + 28, 0, 8);
        uint32_t prop_delay = 0;
        if (g_gptp) {
            int64_t pd = g_gptp->mean_path_delay_ns;
            if (pd < 0)            prop_delay = 0;
            else if (pd > 0xFFFFFFFFLL) prop_delay = 0xFFFFFFFFu;
            else                   prop_delay = (uint32_t)pd;
        }
        av_put_be32(tp + 36, prop_delay);
        tp[40] = 0;                           // gptp_domain_number
        // flags: GPTP_ENABLED + SRP_ENABLED always, AS_CAPABLE once pdelay valid
        uint8_t flags = 0x06;
        if (g_gptp && g_gptp->mean_path_delay_ns > 0 && g_gptp->mean_path_delay_ns < 100000)
            flags |= 0x01;                    // AS_CAPABLE
        tp[41] = flags;
        // msrp_mappings_count = 1 — Class A. Source values from SRP if we've
        // heard a Domain advertise from the bridge, else 802.1Q defaults.
        // The mapping MUST match what we emit on MSRP TalkerAdvertise —
        // discrepancy = listener reports failure 0x13 SR Class Priority
        // Mismatch (IEEE 802.1Q-2018 §35.2.2.10.5).
        uint8_t  map_class = (g_srp && g_srp->domain_received) ? g_srp->rx_sr_class : 6;
        uint8_t  map_prio  = (g_srp && g_srp->domain_received) ? g_srp->rx_sr_prio  : 3;
        uint16_t map_vid   = (g_srp && g_srp->domain_received) ? g_srp->rx_sr_vid   : 2;
        av_put_be16(tp + 42, 1);
        tp[44] = map_class;
        tp[45] = map_prio;
        av_put_be16(tp + 46, map_vid);
        // CDL = AECPDU - 12 = (4 + 8 + 8 + 2 + 2 + 24) - 12 = 36
        aecp_set_status_cdl(tp, st, 36);
        avdecc_eth_send(68);                  // 14 + 48 = 62, pad to 68
        s->aecp_tx_count++;
        break;
    }

    case AEM_CMD_GET_COUNTERS: {
        // Milan 1.3 §5.4.4 mandatory dynamic info. Response payload (136
        // bytes from after cmd_type, per IEEE 1722.1-2013 §7.4.42.2):
        //   +0     descriptor_type (2)
        //   +2     descriptor_index (2)
        //   +4     counters_valid (4 — bit N set = counter[N] is meaningful)
        //   +8     counters[32] (32 × uint32 = 128 bytes)
        //
        // Valid bitmap by descriptor type (Milan §5.3.x / §6.8.x):
        //   AVB_INTERFACE  0x00000023: 0=LINK_UP 1=LINK_DOWN 5=GPTP_GM_CHANGED
        //   CLOCK_DOMAIN   0x00000003: 0=LOCKED   1=UNLOCKED
        //   STREAM_INPUT   0x00000FFF: 0..11 (MEDIA_LOCKED, MEDIA_UNLOCKED,
        //     STREAM_INTERRUPTED, SEQ_NUM_MISMATCH, MEDIA_RESET,
        //     TIMESTAMP_UNCERTAIN, TIMESTAMP_VALID, TIMESTAMP_NOT_VALID,
        //     UNSUPPORTED_FORMAT, LATE_TIMESTAMP, EARLY_TIMESTAMP, FRAMES_RX)
        //   STREAM_OUTPUT  0x0000001F: 0=STREAM_START 1=STREAM_STOP
        //     2=MEDIA_RESET 3=TIMESTAMP_UNCERTAIN 4=FRAMES_TX
        //
        // Values can be zero for compliance — Hive's check only requires
        // the response and the valid bitmap. We populate LINK_UP=1 and
        // CLOCK_DOMAIN.LOCKED from gPTP servo_locked so the UI shows
        // green status indicators.
        if (pdu_len < 28) return;
        uint16_t dt = av_get_be16(pdu + 24);
        uint16_t di = av_get_be16(pdu + 26);

        uint32_t valid = 0;
        uint32_t counters[32] = {0};

        switch (dt) {
        case AEM_DESC_AVB_INTERFACE:
            if (di == 0) {
                valid = 0x00000023;
                counters[0] = 1;                  // LINK_UP
                counters[1] = 0;                  // LINK_DOWN
                counters[5] = 0;                  // GPTP_GM_CHANGED
            }
            break;
        case AEM_DESC_CLOCK_DOMAIN:
            if (di == 0) {
                valid = 0x00000003;
                counters[0] = s->clock_locked_count;
                counters[1] = s->clock_unlocked_count;
            }
            break;
        case AEM_DESC_STREAM_INPUT:
            if (di < N_STREAM_INPUTS && di < AVDECC_MAX_LISTENERS) {
                valid = 0x00000FFF;
                counters[0] = s->stream_media_locked  [di];
                counters[1] = s->stream_media_unlocked[di];
                // 2..10 left zero (no STREAM_INTERRUPTED / SEQ_NUM_MISMATCH
                // / TIMESTAMP_* tracking yet)
                counters[11] = s->stream_frames_rx    [di];
            }
            break;
        case AEM_DESC_STREAM_OUTPUT:
            if (di < N_STREAM_OUTPUTS) {
                valid = 0x0000001F;
                counters[0] = s->talkers[di].stream_start;   // STREAM_START
                counters[1] = s->talkers[di].stream_stop;    // STREAM_STOP
                // 2=MEDIA_RESET, 3=TIMESTAMP_UNCERTAIN left 0
                counters[4] = s->stream_frames_tx[di];       // FRAMES_TX
            }
            break;
        default:
            break;
        }

        uint8_t *tf = avdecc_tx_buf();
        uint8_t *tp = aecp_begin_response(tf, s->src_mac, frame, pdu);
        av_put_be16(tp + 24, dt);
        av_put_be16(tp + 26, di);
        av_put_be32(tp + 28, valid);
        for (int i = 0; i < 32; i++)
            av_put_be32(tp + 32 + i * 4, counters[i]);
        // CDL = AECPDU - 12 = (4 + 8 + 8 + 2 + 2 + 136) - 12 = 148
        aecp_set_status_cdl(tp, AECP_STATUS_SUCCESS, 148);
        avdecc_eth_send(14 + 24 + 136);          // 174 bytes total
        s->aecp_tx_count++;
        break;
    }

    case AEM_CMD_GET_AUDIO_MAP: {
        // Milan 1.3 §5.4.4 mandatory for STREAM_PORT_INPUT/OUTPUT.
        // Response payload (12 bytes from after cmd_type):
        //   +0  desc_type(2)
        //   +2  desc_index(2)
        //   +4  map_index(2)
        //   +6  number_of_maps(2) = 0
        //   +8  number_of_mappings(2) = 0
        //  +10  reserved(2) = 0
        // Our STREAM_PORTs use number_of_clusters=0/number_of_maps=0 so
        // there are no actual mappings to return; the empty response is
        // the canonical "no mappings" answer (matches working endpoint).
        if (pdu_len < 30) return;
        uint16_t dt  = av_get_be16(pdu + 24);
        uint16_t di  = av_get_be16(pdu + 26);
        uint16_t mi  = av_get_be16(pdu + 28);
        uint8_t *tf = avdecc_tx_buf();
        uint8_t *tp = aecp_begin_response(tf, s->src_mac, frame, pdu);
        av_put_be16(tp + 24, dt);
        av_put_be16(tp + 26, di);
        av_put_be16(tp + 28, mi);
        av_put_be16(tp + 30, 0);            // number_of_maps
        av_put_be16(tp + 32, 0);            // number_of_mappings
        av_put_be16(tp + 34, 0);            // reserved
        // CDL = AECPDU - 12 = (4 + 8 + 8 + 2 + 2 + 12) - 12 = 24
        aecp_set_status_cdl(tp, AECP_STATUS_SUCCESS, 24);
        avdecc_eth_send(64);                  // 14 + 36 = 50, pad to 64
        s->aecp_tx_count++;
        break;
    }

    case AEM_CMD_REGISTER_UNSOLICITED:
    case AEM_CMD_DEREGISTER_UNSOLICITED: {
        // IEEE 1722.1-2013 §7.4.37/38 + Milan 1.3 §5.4.2.21 mandatory.
        // Track (controller_entity_id, src_mac) so subsequent state
        // changes (clock lock, listener connect/disconnect) push an
        // unsolicited AEM response to each registered controller.
        const uint8_t *ctrl_eid = pdu + AECP_OFF_CONTROLLER_ID;
        const uint8_t *ctrl_mac = frame + 6;        // sender MAC
        int slot = -1, free_slot = -1;
        for (int i = 0; i < AVDECC_MAX_UNSOL_CTRL; i++) {
            if (s->unsol_ctrl[i].active) {
                int eq = 1;
                for (int j = 0; j < 8; j++)
                    if (s->unsol_ctrl[i].controller_eid[j] != ctrl_eid[j]) { eq = 0; break; }
                if (eq) { slot = i; break; }
            } else if (free_slot < 0) {
                free_slot = i;
            }
        }
        if (cmd_type == AEM_CMD_REGISTER_UNSOLICITED) {
            int use = (slot >= 0) ? slot : free_slot;
            if (use >= 0) {
                // Reset sequence_id when a NEW controller registers
                // (not when an existing one re-registers — Hive expects
                // continuity across the original session).
                if (use == free_slot)
                    s->unsol_ctrl[use].unsol_seq_id = 0;
                s->unsol_ctrl[use].active = 1;
                memcpy(s->unsol_ctrl[use].controller_eid, ctrl_eid, 8);
                memcpy(s->unsol_ctrl[use].mac, ctrl_mac, 6);
            }
        } else if (slot >= 0) {
            s->unsol_ctrl[slot].active = 0;
        }
        uint8_t *tf = avdecc_tx_buf();
        uint8_t *tp = aecp_begin_response(tf, s->src_mac, frame, pdu);
        aecp_set_status_cdl(tp, AECP_STATUS_SUCCESS, 12);   // header only
        avdecc_eth_send(64);                                  // 14 + 24 = 38, pad to 64
        s->aecp_tx_count++;
        // New controller/listener registered → immediately hand it our talker
        // streams' info, so one that registers AFTER the gPTP-lock talker-ready
        // push still gets the stream_id/dest to resolve a stale binding + probe.
        if (cmd_type == AEM_CMD_REGISTER_UNSOLICITED && slot < 0 && free_slot >= 0)
            avdecc_notify_talkers_ready(s);
        break;
    }

    case AEM_CMD_GET_MAX_TRANSIT_TIME: {
        // Response payload (12 bytes from after cmd_type):
        //   +0  descriptor_type(2) +2 descriptor_index(2) +4 max_transit_time(8)
        // max_transit_time is the maximum buffer latency, in ns. We use
        // 2 ms (matches the buffer_length in our STREAM descriptors).
        if (pdu_len < 28) return;
        uint16_t dt = av_get_be16(pdu + 24);
        uint16_t di = av_get_be16(pdu + 26);
        uint8_t  st = AECP_STATUS_SUCCESS;
        if (!((dt == AEM_DESC_STREAM_OUTPUT && di < N_STREAM_OUTPUTS) ||
              (dt == AEM_DESC_STREAM_INPUT  && di < N_STREAM_INPUTS)))
            st = AECP_STATUS_NO_SUCH_DESCRIPTOR;

        uint8_t *tf = avdecc_tx_buf();
        uint8_t *tp = aecp_begin_response(tf, s->src_mac, frame, pdu);
        av_put_be16(tp + 24, dt);
        av_put_be16(tp + 26, di);
        // 64-bit max_transit_time = 2,000,000 ns (2 ms)
        av_put_be32(tp + 28, 0);
        av_put_be32(tp + 32, 2000000);
        aecp_set_status_cdl(tp, st, 24);              // 12 (hdr) + 12 (payload)
        avdecc_eth_send(64);                           // 14 + 36 = 50, pad to 64
        s->aecp_tx_count++;
        break;
    }

    case AEM_CMD_GET_STREAM_INFO: {
        // GET_STREAM_INFO returns the live stream parameters (stream_id,
        // dest_mac, MSRP latency, VLAN, format, flags). Hive populates its
        // "Dynamic Info" panel from this response — without it, every field
        // shows "No Value" even though the descriptor tree is correct.
        //
        // Milan 1.2 response payload (56 bytes, from after cmd_type) —
        // la_avdecc protocolAemPayloads.cpp:1492. The first 48 bytes are
        // the IEEE 1722.1-2013 layout; bytes 48..55 are the Milan
        // extension (streamInfoFlagsEx, probing_status, acmp_status).
        // Without the extension, Hive flags "Milan mandatory extended
        // GET_STREAM_INFO not found" and drops Milan compatibility.
        //   +0  descriptor_type
        //   +2  descriptor_index
        //   +4  aem_stream_info_flags
        //   +8  stream_format (8)
        //  +16  stream_id (8)
        //  +24  msrp_accumulated_latency (4)
        //  +28  stream_dest_mac (6)
        //  +34  msrp_failure_code (1)
        //  +35  reserved (1)
        //  +36  msrp_failure_bridge_id (8)
        //  +44  stream_vlan_id (2)
        //  +46  reserved2 (2)
        //  +48  stream_info_flags_ex (4)            ← Milan extension
        //  +52  probing_status(3 bits MSB) | acmp_status(5 bits LSB) (1)
        //  +53  reserved3 (1)
        //  +54  reserved4 (2)
        if (pdu_len < 28) return;
        uint16_t dt = av_get_be16(pdu + 24);
        uint16_t di = av_get_be16(pdu + 26);

        const uint8_t *fmt = NULL, *stream_id = NULL, *dest_mac = NULL;
        uint32_t info_flags = STREAM_INFO_FLAG_STREAM_FORMAT_VALID;
        int connected = 0;

        if (dt == AEM_DESC_STREAM_OUTPUT && di < AVDECC_MAX_TALKERS) {
            const avdecc_talker_stream_t *t = &s->talkers[di];
            fmt = stream_fmt_aaf_8ch_48k;
            stream_id = t->stream_id;
            dest_mac  = t->dest_mac;
            info_flags |= STREAM_INFO_FLAG_STREAM_ID_VALID
                        | STREAM_INFO_FLAG_STREAM_DEST_MAC_VALID
                        | STREAM_INFO_FLAG_MSRP_ACC_LATENCY_VALID
                        | STREAM_INFO_FLAG_STREAM_VLAN_ID_VALID;
            connected = t->connected;
            // Report CONNECTED (= streaming, STREAMING_WAIT clear) when a
            // listener is bound, so the controller/listener sees the talker as
            // live and arms the input. (Was computed but never flagged.)
            if (connected)
                info_flags |= STREAM_INFO_FLAG_CONNECTED;
        } else if (dt == AEM_DESC_STREAM_INPUT && di < AVDECC_MAX_LISTENERS) {
            const avdecc_listener_stream_t *l = &s->listeners[di];
            fmt = (di == LISTENER_CRF_INDEX) ? stream_fmt_crf_48k : stream_fmt_aaf_8ch_48k;
            if (l->connected) {
                stream_id = l->stream_id;
                dest_mac  = l->dest_mac;
                info_flags |= STREAM_INFO_FLAG_STREAM_ID_VALID
                            | STREAM_INFO_FLAG_STREAM_DEST_MAC_VALID;
                // Only flag CONNECTED if we have a real talker (non-zero
                // talker_id). FAST_CONNECT-style commands sometimes leave
                // talker_id zeroed; Hive flags "connected but no Talker
                // Identification" if we advertise CONNECTED in that case.
                int has_talker = 0;
                for (int i = 0; i < 8; i++)
                    if (l->talker_id[i]) { has_talker = 1; break; }
                if (has_talker) {
                    info_flags |= STREAM_INFO_FLAG_CONNECTED
                                | STREAM_INFO_FLAG_FAST_CONNECT
                                | STREAM_INFO_FLAG_SAVED_STATE;
                }
            }
        } else {
            // Unknown descriptor — respond NO_SUCH_DESCRIPTOR with bare echo (56-byte Milan layout)
            uint8_t *tf = avdecc_tx_buf();
            uint8_t *tp = aecp_begin_response(tf, s->src_mac, frame, pdu);
            memcpy(tp + 24, pdu + 24, 4);
            memset(tp + 28, 0, 52);
            aecp_set_status_cdl(tp, AECP_STATUS_NO_SUCH_DESCRIPTOR, 68);
            avdecc_eth_send(14 + 24 + 56);   // 94 bytes total
            s->aecp_tx_count++;
            return;
        }

        // Compute probing_status for STREAM_INPUT (Milan): Completed when
        // bound, Disabled otherwise. STREAM_OUTPUT keeps probing=0 (the
        // field is documented only for listener side; talker reads 0).
        uint8_t probing = 0, acmp_st = 0;
        if (dt == AEM_DESC_STREAM_INPUT && di < AVDECC_MAX_LISTENERS) {
            if (s->listeners[di].connected) probing = 3;   // Completed
        }

        // MSRP-derived fields: prefer the SRP-learned values stored
        // in the listener struct when present, fall back to our static
        // defaults (2 ms latency, VLAN 2) for the talker side or
        // un-yet-learned listeners.
        uint32_t msrp_latency = 2000000;
        uint16_t vlan_id      = 2;
        if (dt == AEM_DESC_STREAM_INPUT && di < AVDECC_MAX_LISTENERS) {
            const avdecc_listener_stream_t *l = &s->listeners[di];
            if (l->msrp_accumulated_latency_ns)
                msrp_latency = l->msrp_accumulated_latency_ns;
            if (l->stream_vlan_id)
                vlan_id      = l->stream_vlan_id;
        }

        uint8_t *tf = avdecc_tx_buf();
        uint8_t *tp = aecp_begin_response(tf, s->src_mac, frame, pdu);
        av_put_be16(tp + 24, dt);
        av_put_be16(tp + 26, di);
        av_put_be32(tp + 28, info_flags);
        memcpy   (tp + 32, fmt, 8);                            // stream_format
        if (stream_id) memcpy(tp + 40, stream_id, 8);
        else           memset(tp + 40, 0, 8);
        av_put_be32(tp + 48, msrp_latency);                    // MSRP accumulated latency
        if (dest_mac) memcpy(tp + 52, dest_mac, 6);
        else          memset(tp + 52, 0, 6);
        tp[58] = 0;                                            // msrp_failure_code
        tp[59] = 0;                                            // reserved
        memset(tp + 60, 0, 8);                                 // msrp_failure_bridge_id
        av_put_be16(tp + 68, vlan_id);                         // stream_vlan_id
        av_put_be16(tp + 70, 0);                               // reserved2
        // Milan extension (bytes 48..55 of the AEM payload = tp+72..tp+79):
        av_put_be32(tp + 72, 0);                               // stream_info_flags_ex (no special flags)
        tp[76] = ((probing & 0x07) << 5) | (acmp_st & 0x1F);   // probing | acmp
        tp[77] = 0;                                            // reserved3
        av_put_be16(tp + 78, 0);                               // reserved4
        // CDL = AECPDU - 12 = (4 + 8 + 8 + 2 + 2 + 56) - 12 = 68
        aecp_set_status_cdl(tp, AECP_STATUS_SUCCESS, 68);
        avdecc_eth_send(14 + 24 + 56);                         // 94 bytes total
        s->aecp_tx_count++;
        (void)connected;
        break;
    }

    case AEM_CMD_SET_CLOCK_SOURCE: {
        if (pdu_len < 32) return;
        uint16_t dt  = av_get_be16(pdu + 24);
        uint16_t di  = av_get_be16(pdu + 26);
        uint16_t src = av_get_be16(pdu + 28);

        uint8_t st;
        if (dt != AEM_DESC_CLOCK_DOMAIN || di != 0)
            st = AECP_STATUS_NO_SUCH_DESCRIPTOR;
        else if (src >= N_CLOCK_SOURCES)
            st = AECP_STATUS_BAD_ARGUMENTS;
        else {
            s->current_clock_source = src;
            // Don't reset the 0xFF sentinel — letting track_clock_lock
            // observe the natural transition from the OLD source's
            // tracked state to the NEW source's current state is what
            // bumps LOCKED/UNLOCKED. If we re-baseline here, the swap
            // looks like "already there" and the LOCKED counter stays
            // 0 even though Media Clock is locked to CRF.
            st = AECP_STATUS_SUCCESS;
            if (s->on_clock_source_change)
                s->on_clock_source_change(src);
        }

        uint8_t *tf = avdecc_tx_buf();
        uint8_t *tp = aecp_begin_response(tf, s->src_mac, frame, pdu);
        memcpy(tp + 24, pdu + 24, 4);
        av_put_be16(tp + 28, s->current_clock_source);
        av_put_be16(tp + 30, 0);
        aecp_set_status_cdl(tp, st, 20);
        avdecc_eth_send(64);
        s->aecp_tx_count++;
        printf("[AVDECC] SET_CLOCK_SOURCE -> %u (status=%u)\n",
               s->current_clock_source, st);
        break;
    }

    case AEM_CMD_GET_NAME: {
        // IEEE 1722.1-2013 §7.4.18. COMMAND payload (8 B): dt, di, ni, ci.
        // RESPONSE payload (72 B): dt, di, ni, ci + name (64 B utf-8 nul-pad).
        //
        // We don't expose multiple name slots — name_index 0 returns the
        // descriptor's primary object_name; any other ni returns empty +
        // SUCCESS rather than NO_SUCH_DESCRIPTOR so Hive's enumeration
        // doesn't downgrade Milan compliance.
        if (pdu_len < 32) return;
        uint16_t dt = av_get_be16(pdu + 24);
        uint16_t di = av_get_be16(pdu + 26);
        uint16_t ni = av_get_be16(pdu + 28);
        uint16_t ci = av_get_be16(pdu + 30);

        const char *name = "";
        uint8_t st = AECP_STATUS_SUCCESS;
        switch (dt) {
            case AEM_DESC_ENTITY:
                if (di == 0 && ni == 0)      name = "N-Series AVB Switchover";
                else if (di == 0 && ni == 1) name = "";   // group_name
                else                          st = AECP_STATUS_NO_SUCH_DESCRIPTOR;
                break;
            case AEM_DESC_CONFIGURATION:
                if (di == 0 && ni == 0) name = "Default";
                else                    st = AECP_STATUS_NO_SUCH_DESCRIPTOR;
                break;
            case AEM_DESC_AUDIO_UNIT:
                if (di == 0 && ni == 0) name = "Audio Unit";
                else                    st = AECP_STATUS_NO_SUCH_DESCRIPTOR;
                break;
            case AEM_DESC_STREAM_INPUT:
                if (di < N_STREAM_INPUTS && ni == 0) {
                    name = (di == 0) ? "Media Clock Input" : "Audio Input";
                } else st = AECP_STATUS_NO_SUCH_DESCRIPTOR;
                break;
            case AEM_DESC_STREAM_OUTPUT:
                if (di < N_STREAM_OUTPUTS && ni == 0) name = "Audio Output";
                else                                  st = AECP_STATUS_NO_SUCH_DESCRIPTOR;
                break;
            case AEM_DESC_AVB_INTERFACE:
                if (di == 0 && ni == 0) name = "Ethernet";
                else                    st = AECP_STATUS_NO_SUCH_DESCRIPTOR;
                break;
            case AEM_DESC_CLOCK_SOURCE:
                if (di < N_CLOCK_SOURCES && ni == 0)
                    name = (di == 0) ? "Internal" : "Media Clock";
                else
                    st = AECP_STATUS_NO_SUCH_DESCRIPTOR;
                break;
            case AEM_DESC_CLOCK_DOMAIN:
                if (di == 0 && ni == 0) name = "Clock Domain";
                else                    st = AECP_STATUS_NO_SUCH_DESCRIPTOR;
                break;
            default:
                st = AECP_STATUS_NO_SUCH_DESCRIPTOR;
                break;
        }
        (void)ci;   // configuration_index — only one config, value ignored

        uint8_t *tf = avdecc_tx_buf();
        uint8_t *tp = aecp_begin_response(tf, s->src_mac, frame, pdu);
        av_put_be16(tp + 24, dt);
        av_put_be16(tp + 26, di);
        av_put_be16(tp + 28, ni);
        av_put_be16(tp + 30, ci);
        write_name64(tp + 32, name);
        // CDL = AECPDU - 12 = (4 + 8 + 8 + 2 + 2 + 72) - 12 = 84
        aecp_set_status_cdl(tp, st, 84);
        avdecc_eth_send(110);                 // 14 + 96 = 110 bytes
        s->aecp_tx_count++;
        break;
    }

    default: {
        // Unknown command — echo with NOT_IMPLEMENTED
        uint16_t orig_cdl = av_get_be16(pdu + 2) & 0x7FF;
        uint32_t copy_len = 12 + orig_cdl;
        if (copy_len > 500) copy_len = 500;

        uint8_t *tf = avdecc_tx_buf();
        memcpy(tf, frame + 6, 6);           // dst = sender's MAC
        memcpy(tf + 6, s->src_mac, 6);
        av_put_be16(tf + 12, AVDECC_ETHERTYPE);

        uint8_t *tp = tf + 14;
        memcpy(tp, pdu, copy_len);
        tp[0] = AVTP_SUBTYPE_AECP;
        tp[1] = AECP_MSG_AEM_RESPONSE;
        aecp_set_status_cdl(tp, AECP_STATUS_NOT_IMPLEMENTED, orig_cdl);

        uint32_t flen = 14 + copy_len;
        if (flen < 64) flen = 64;
        avdecc_eth_send(flen);
        s->aecp_tx_count++;
        break;
    }

    } // switch cmd_type
}

// ---------------------------------------------------------------------------
// RX dispatch
// ---------------------------------------------------------------------------

void avdecc_process_rx(avdecc_state_t *s, const uint8_t *frame, uint32_t len)
{
    if (len < 14 + 4)
        return;

    const uint8_t *pdu = frame + 14;
    uint8_t subtype = pdu[0];
    uint8_t msg_type = pdu[1] & 0x0F;

    if (subtype == AVTP_SUBTYPE_ADP) {
        // We could track other entities here, but for a minimal endpoint
        // we just note that we're on an AVDECC-capable network.
        return;
    }

    if (subtype == AVTP_SUBTYPE_ACMP) {
        if (len < 14 + ACMPDU_LEN)
            return;

        s->acmp_rx_count++;

        // Check if the command is addressed to us
        const uint8_t *talker_id   = pdu + ACMP_OFF_TALKER_ID;
        const uint8_t *listener_id = pdu + ACMP_OFF_LISTENER_ID;

        switch (msg_type) {
            case ACMP_MSG_CONNECT_TX_COMMAND:
                if (entity_id_match(talker_id, s->entity_id))
                    acmp_handle_connect_tx(s, pdu);
                break;
            case ACMP_MSG_CONNECT_TX_RESPONSE:
                // Slow-path resolve: this is the talker's reply to our
                // CONNECT_TX_COMMAND. Match by listener_eid + seq_id.
                acmp_handle_connect_tx_response(s, pdu);
                break;
            case ACMP_MSG_DISCONNECT_TX_COMMAND:
                if (entity_id_match(talker_id, s->entity_id))
                    acmp_handle_disconnect_tx(s, pdu);
                break;
            case ACMP_MSG_GET_TX_STATE_COMMAND:
                if (entity_id_match(talker_id, s->entity_id))
                    acmp_handle_get_tx_state(s, pdu);
                break;
            case ACMP_MSG_CONNECT_RX_COMMAND:
                if (entity_id_match(listener_id, s->entity_id))
                    acmp_handle_connect_rx(s, pdu);
                else if (entity_id_match(talker_id, s->entity_id))
                    acmp_snoop_switch_connect_rx(s, pdu);   // learn AxC + patched set
                break;
            case ACMP_MSG_DISCONNECT_RX_COMMAND:
                if (entity_id_match(listener_id, s->entity_id))
                    acmp_handle_disconnect_rx(s, pdu);
                break;
            case ACMP_MSG_GET_RX_STATE_COMMAND:
                if (entity_id_match(listener_id, s->entity_id))
                    acmp_handle_get_rx_state(s, pdu);
                break;
        }
        return;
    }

    if (subtype == AVTP_SUBTYPE_AECP) {
        aecp_handle(s, frame, pdu, len - 14);
        return;
    }
}

// ---------------------------------------------------------------------------
// Init
// ---------------------------------------------------------------------------

void avdecc_init(avdecc_state_t *s, const uint8_t *mac_addr)
{
    memset(s, 0, sizeof(*s));

    // 0xFF sentinel — track_clock_lock adopts the first sample as the
    // baseline without bumping LOCKED/UNLOCKED. Default-0 from memset
    // would bump on the gPTP→locked transition (acceptable) but also
    // bump on a SET_CLOCK_SOURCE flip where new source hasn't locked.
    s->clock_last_locked = 0xFF;
    g_self = s;                     // for unsolicited control-change notifications

    memcpy(s->src_mac, mac_addr, 6);

    // Entity ID is an EUI-64 (per IEEE 1722.1 §6.2.1.1). Derive it from
    // the MAC by inserting FF:FE in the middle — the standard EUI-48 →
    // EUI-64 expansion. Matches our gPTP clock_identity, MOTU's format,
    // and avoids the "MAC + 0000 padding" look that has five trailing
    // zero bytes. e.g. MAC 02:00:00:00:00:42 → ID 02:00:00:FF:FE:00:00:42.
    s->entity_id[0] = mac_addr[0];
    s->entity_id[1] = mac_addr[1];
    s->entity_id[2] = mac_addr[2];
    s->entity_id[3] = 0xFF;
    s->entity_id[4] = 0xFE;
    s->entity_id[5] = mac_addr[3];
    s->entity_id[6] = mac_addr[4];
    s->entity_id[7] = mac_addr[5];

    avdecc_txslot = 0;

    printf("[AVDECC] Entity ID=%02x:%02x:%02x:%02x:%02x:%02x:%02x:%02x\n",
           s->entity_id[0], s->entity_id[1], s->entity_id[2], s->entity_id[3],
           s->entity_id[4], s->entity_id[5], s->entity_id[6], s->entity_id[7]);
}

void avdecc_set_talker_stream(avdecc_state_t *s, uint16_t uid,
                              const uint8_t *stream_id,
                              const uint8_t *stream_dest_mac)
{
    if (uid >= AVDECC_MAX_TALKERS) return;
    memcpy(s->talkers[uid].stream_id, stream_id, 8);
    memcpy(s->talkers[uid].dest_mac,  stream_dest_mac, 6);
}

void avdecc_set_gptp(const gptp_t *g)
{
    g_gptp = g;
}

void avdecc_set_mcr(const mcr_state_t *m)
{
    g_mcr = m;
}

void avdecc_depart(avdecc_state_t *s)
{
    adp_send(s, ADP_MSG_ENTITY_DEPARTING);
    printf("[AVDECC] Entity departing\n");
}

// ---------------------------------------------------------------------------
// Poll — periodic ADP advertisement
// ---------------------------------------------------------------------------

// Send an unsolicited GET_COUNTERS_RESPONSE for (dt, di) to every
// registered controller. U flag (bit 15 of cmd_type) tells Hive this
// is a push — sequence_id comes from our own monotonic counter.
// Caller supplies the valid-bitmap and the up-to-32 counter values.
static void push_unsol_counters(avdecc_state_t *s, uint16_t dt, uint16_t di,
                                 uint32_t valid, const uint32_t *counters)
{
    // Pushes only fire on actual state changes (track_clock_lock /
    // avdecc_listener_lock_changed) so volume is bounded by lock
    // transition rate. The earlier flood (590 pushes/s × N ctrls
    // crashing the network) came from a clock-source-change branch
    // that bumped the counter in a loop — that path was reverted
    // in 57d6d06. With MCR exit_streak=4 now suppressing single-
    // sample jitter spikes, transition rate is low enough for
    // Hive to show live updates without manual refresh.
    for (int i = 0; i < AVDECC_MAX_UNSOL_CTRL; i++) {
        if (!s->unsol_ctrl[i].active) continue;

        uint8_t *frame = avdecc_tx_buf();
        memcpy(frame, s->unsol_ctrl[i].mac, 6);              // dst = controller
        memcpy(frame + 6, s->src_mac, 6);
        av_put_be16(frame + 12, AVDECC_ETHERTYPE);

        uint8_t *p = frame + 14;
        p[0] = AVTP_SUBTYPE_AECP;
        p[1] = AECP_MSG_AEM_RESPONSE;
        memcpy(p + AECP_OFF_TARGET_ID,     s->entity_id, 8);
        memcpy(p + AECP_OFF_CONTROLLER_ID, s->unsol_ctrl[i].controller_eid, 8);
        av_put_be16(p + AECP_OFF_SEQ_ID,   s->unsol_ctrl[i].unsol_seq_id++);
        av_put_be16(p + AECP_OFF_CMD_TYPE, 0x8000 | AEM_CMD_GET_COUNTERS);

        av_put_be16(p + 24, dt);
        av_put_be16(p + 26, di);
        av_put_be32(p + 28, valid);
        for (int j = 0; j < 32; j++)
            av_put_be32(p + 32 + j * 4, counters[j]);
        aecp_set_status_cdl(p, AECP_STATUS_SUCCESS, 148);

        avdecc_eth_send(14 + 24 + 136);
        s->aecp_tx_count++;
    }
}

static void push_unsol_clock_counters(avdecc_state_t *s)
{
    uint32_t c[32] = {0};
    c[0] = s->clock_locked_count;
    c[1] = s->clock_unlocked_count;
    push_unsol_counters(s, AEM_DESC_CLOCK_DOMAIN, 0, 0x00000003, c);
}

static void push_unsol_stream_counters(avdecc_state_t *s, uint16_t uid)
{
    if (uid >= AVDECC_MAX_LISTENERS) return;
    uint32_t c[32] = {0};
    c[0]  = s->stream_media_locked  [uid];
    c[1]  = s->stream_media_unlocked[uid];
    c[11] = s->stream_frames_rx     [uid];
    push_unsol_counters(s, AEM_DESC_STREAM_INPUT, uid, 0x00000FFF, c);
}

// STREAM_OUTPUT (talker) counters — pushed on the connect/disconnect edge so
// Hive's STREAM_START / STREAM_STOP / FRAMES_TX update without a manual poll.
static void push_unsol_stream_out_counters(avdecc_state_t *s, uint16_t uid)
{
    if (uid >= AVDECC_MAX_TALKERS) return;
    uint32_t c[32] = {0};
    c[0] = s->talkers[uid].stream_start;   // STREAM_START
    c[1] = s->talkers[uid].stream_stop;    // STREAM_STOP
    c[4] = s->stream_frames_tx[uid];       // FRAMES_TX
    push_unsol_counters(s, AEM_DESC_STREAM_OUTPUT, uid, 0x0000001F, c);
}

// Build the 56-byte Milan GET_STREAM_INFO payload (the part that follows
// the AECP header at offset +24). Layout matches the response builder in
// aecp_handle's AEM_CMD_GET_STREAM_INFO case. dt must be STREAM_INPUT or
// STREAM_OUTPUT. Returns the number of bytes written (always 56).
static uint32_t build_stream_info_payload(avdecc_state_t *s, uint16_t dt,
                                          uint16_t di, uint8_t *p)
{
    const uint8_t *fmt = stream_fmt_aaf_8ch_48k;
    const uint8_t *stream_id = NULL, *dest_mac = NULL;
    uint32_t info_flags = STREAM_INFO_FLAG_STREAM_FORMAT_VALID;
    uint8_t  probing = 0;
    uint32_t msrp_latency = 2000000;
    uint16_t vlan_id = 2;

    if (dt == AEM_DESC_STREAM_OUTPUT && di < AVDECC_MAX_TALKERS) {
        const avdecc_talker_stream_t *t = &s->talkers[di];
        stream_id = t->stream_id;
        dest_mac  = t->dest_mac;
        info_flags |= STREAM_INFO_FLAG_STREAM_ID_VALID
                    | STREAM_INFO_FLAG_STREAM_DEST_MAC_VALID
                    | STREAM_INFO_FLAG_MSRP_ACC_LATENCY_VALID
                    | STREAM_INFO_FLAG_STREAM_VLAN_ID_VALID;
        // Report the talker as CONNECTED (and therefore STREAMING, since
        // STREAMING_WAIT is clear) once a listener is bound. Without this a
        // Milan controller/listener sees our talker as idle and never arms its
        // input -> AxC shows neither MEDIA_LOCKED nor MEDIA_UNLOCKED ("never
        // tries"). avb_session reports CONNECTED here (updateStreamInfoConnected).
        if (t->connected)
            info_flags |= STREAM_INFO_FLAG_CONNECTED;
    } else if (dt == AEM_DESC_STREAM_INPUT && di < AVDECC_MAX_LISTENERS) {
        const avdecc_listener_stream_t *l = &s->listeners[di];
        fmt = (di == LISTENER_CRF_INDEX) ? stream_fmt_crf_48k : stream_fmt_aaf_8ch_48k;
        if (l->connected) {
            stream_id = l->stream_id;
            dest_mac  = l->dest_mac;
            info_flags |= STREAM_INFO_FLAG_STREAM_ID_VALID
                        | STREAM_INFO_FLAG_STREAM_DEST_MAC_VALID;
            int has_talker = 0;
            for (int i = 0; i < 8; i++)
                if (l->talker_id[i]) { has_talker = 1; break; }
            if (has_talker) {
                info_flags |= STREAM_INFO_FLAG_CONNECTED
                            | STREAM_INFO_FLAG_FAST_CONNECT
                            | STREAM_INFO_FLAG_SAVED_STATE;
            }
            probing = 3;   // Completed
            if (l->msrp_accumulated_latency_ns)
                msrp_latency = l->msrp_accumulated_latency_ns;
            if (l->stream_vlan_id)
                vlan_id = l->stream_vlan_id;
        }
    }

    memset(p, 0, 56);
    av_put_be16(p +  0, dt);
    av_put_be16(p +  2, di);
    av_put_be32(p +  4, info_flags);
    memcpy   (p +  8, fmt, 8);                             // stream_format
    if (stream_id) memcpy(p + 16, stream_id, 8);
    av_put_be32(p + 24, msrp_latency);                     // MSRP accumulated latency
    if (dest_mac) memcpy(p + 28, dest_mac, 6);
    // bytes 34..43 reserved/failure already zero from memset
    av_put_be16(p + 44, vlan_id);                          // stream_vlan_id
    // Milan extension (offset 48..55):
    // 48..51 = stream_info_flags_ex (0), 52 = probing|acmp, 53 = rsvd, 54..55 = rsvd
    p[52] = ((probing & 0x07) << 5);                       // acmp_status=0
    return 56;
}

// Emit an unsolicited GET_STREAM_INFO_RESPONSE for (dt,di) to every
// registered controller. Mirrors sm2's notify_stream_info_changed —
// causes Hive to refresh the listener's flags + probing_status without
// waiting for its own poll, which is what makes the "active" black dot
// appear in the patch matrix right after CONNECT_RX.
static void push_unsol_stream_info(avdecc_state_t *s, uint16_t dt, uint16_t di)
{
    for (int i = 0; i < AVDECC_MAX_UNSOL_CTRL; i++) {
        if (!s->unsol_ctrl[i].active) continue;

        uint8_t *frame = avdecc_tx_buf();
        memcpy(frame, s->unsol_ctrl[i].mac, 6);
        memcpy(frame + 6, s->src_mac, 6);
        av_put_be16(frame + 12, AVDECC_ETHERTYPE);

        uint8_t *p = frame + 14;
        p[0] = AVTP_SUBTYPE_AECP;
        p[1] = AECP_MSG_AEM_RESPONSE;
        memcpy(p + AECP_OFF_TARGET_ID,     s->entity_id, 8);
        memcpy(p + AECP_OFF_CONTROLLER_ID, s->unsol_ctrl[i].controller_eid, 8);
        av_put_be16(p + AECP_OFF_SEQ_ID,   s->unsol_ctrl[i].unsol_seq_id++);
        av_put_be16(p + AECP_OFF_CMD_TYPE, 0x8000 | AEM_CMD_GET_STREAM_INFO);

        build_stream_info_payload(s, dt, di, p + 24);
        aecp_set_status_cdl(p, AECP_STATUS_SUCCESS, 68);   // 12 (hdr) + 56 (payload)

        avdecc_eth_send(14 + 24 + 56);
        s->aecp_tx_count++;
    }
}
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
