Nickster90s/Inferno-FPGA/firmware/dstats.c

// Runtime counters over UDP, because the UART is not ours to read.
//
// /dev/ttyACM0 belongs to the operator's picocom, so the build host cannot see
// console output and every "is it underrunning?" question has had to be
// answered by asking for a pasted log. These are the counters that actually
// distinguish a transmit-side glitch from a receive-side one, so they are worth
// a bound port: send any byte to 7779, get a fixed array of
// big-endian u32 counters back. Binary, not text: this libc has no snprintf.

#include "net.h"
#include "dante_dev.h"
#include "dante_arc.h"
#include "mdns.h"
extern uint32_t usb_fb_manual;
extern uint16_t g_mcast_fpp;
extern uint32_t g_phase_adj;
extern uint8_t  usb_fb_sweep_hold;
#include "dante_tx.h"
#include "gptp.h"
#include "ptpv1.h"
#include "dante_flows.h"
#include "dante_tx.h"
#include "gptp.h"
#include "rx_gate.h"
#include "mcr_dante.h"
#include "telem.h"
#include <generated/csr.h>
#include <stdio.h>

#define STATS_PORT 7779

static void put32(uint8_t *p, uint32_t n, uint32_t v)
{
    p[n] = (uint8_t)(v >> 24); p[n+1] = (uint8_t)(v >> 16);
    p[n+2] = (uint8_t)(v >> 8); p[n+3] = (uint8_t)v;
}

// rx_gate control + readout, on a SEPARATE request opcode.
//
// Deliberately NOT extra fields on the main reply. Growing that reply from 200
// to 208 bytes once killed the port outright -- no response at all, while ARC
// and flow control kept answering -- and the cause was never found (see the
// comment further down). The main reply therefore stays byte-identical and
// rx_gate gets its own, smaller record. A different reply is not a bigger one.
//
// Request: 'g'                -> status only
//          'g' '1'            -> arm, provisionally (auto-reverts, see below)
//          'g' '0'            -> disarm
//          'g' 'c'            -> commit (cancel the auto-revert)
//
// Arming over the network is provisional on purpose: if the allow-list is
// wrong, the packet carrying "turn it off" is exactly the one that gets
// dropped. The board undoes it by itself unless told the network survived.
#define RXGATE_REVERT_MS 30000u

static void rxgate_rx(const uint8_t src_ip[4], uint16_t src_port,
                      const uint8_t *req, uint32_t len)
{
    if (len >= 2) {
        switch (req[1]) {
            case '1': rx_gate_set(1, RXGATE_REVERT_MS); break;
            case '0': rx_gate_set(0, 0);                break;
            case 'c': rx_gate_commit();                 break;
            default:  break;                            // status-only
        }
    }

    rx_gate_status_t g;
    rx_gate_get_status(&g);

    uint8_t *p = net_udp_payload_buf();
    uint32_t n = 0;
    put32(p, n, 0x52584731u);          n += 4;   // 'RXG1' — version tag, so the
                                                 // host parses by name and never
                                                 // by a hand-counted offset.
    put32(p, n, g.enabled);            n += 4;
    put32(p, n, g.pending_revert);     n += 4;
    put32(p, n, g.revert_in_ms);       n += 4;
    put32(p, n, g.match);              n += 4;
    put32(p, n, g.nomatch);            n += 4;
    put32(p, n, g.discarded);          n += 4;
    put32(p, n, ((uint32_t)g.last_drop_mac[0] << 24) |
                ((uint32_t)g.last_drop_mac[1] << 16) |
                ((uint32_t)g.last_drop_mac[2] << 8)  |
                 (uint32_t)g.last_drop_mac[3]);  n += 4;
    put32(p, n, ((uint32_t)g.last_drop_mac[4] << 8) |
                 (uint32_t)g.last_drop_mac[5]);  n += 4;
    // The two counters that say whether this is working, alongside the gate's
    // own: writer_errors is the thing being fixed, and rx_filtered is the
    // SOFTWARE filter's drop count -- it should go flat as the gate takes over.
    put32(p, n, ethmac_sram_writer_errors_read()); n += 4;
    put32(p, n, rx_gate_sw_filtered());            n += 4;

    net_udp_commit(src_ip, src_port, STATS_PORT, n, NET_TOS_BEST_EFFORT);
}

// Media-clock control + readout, opcode 'm'. Same reasoning as 'g': a separate,
// smaller record rather than extra fields on the 200-byte main reply, which
// died once when it grew to 208.
//
//   'm'        -> status only
//   'm' '1'    -> arm the discipline
//   'm' '0'    -> disarm (NCO back to nominal, immediately)
static void mclk_rx(const uint8_t src_ip[4], uint16_t src_port,
                    const uint8_t *req, uint32_t len)
{
    if (len >= 2) {
        if (req[1] == '1') mcr_dante_set_enabled(1);
        else if (req[1] == '0') mcr_dante_set_enabled(0);
        else if (req[1] == 'P') mcr_dante_set_phase_enabled(1);
        else if (req[1] == 'p') mcr_dante_set_phase_enabled(0);
    }

    mcr_dante_status_t m;
    mcr_dante_get_status(&m);

    uint8_t *p = net_udp_payload_buf();
    uint32_t n = 0;
    put32(p, n, 0x4D434C4Bu);                    n += 4;   // 'MCLK' version tag
    put32(p, n, m.enabled);                      n += 4;
    put32(p, n, m.ptp_locked);                   n += 4;
    put32(p, n, (uint32_t)m.target_ppb);         n += 4;
    put32(p, n, (uint32_t)m.applied_ppb);        n += 4;
    put32(p, n, m.base_inc);                     n += 4;
    put32(p, n, m.applied_inc);                  n += 4;
    put32(p, n, m.nco_writes);                   n += 4;
    put32(p, n, m.trips);                        n += 4;
    put32(p, n, m.lvl_min);                      n += 4;
    put32(p, n, m.lvl_avg);                      n += 4;
    put32(p, n, m.lvl_max);                      n += 4;
    put32(p, n, m.underrun_per_s);               n += 4;
    put32(p, n, (uint32_t)m.drift_samples);      n += 4;
    put32(p, n, aaf_pkt_underrun_count_read());  n += 4;
    put32(p, n, aaf_pkt_overrun_count_read());   n += 4;
    put32(p, n, m.phase_enabled);                n += 4;
    put32(p, n, (uint32_t)m.phase_ppb);          n += 4;

    net_udp_commit(src_ip, src_port, STATS_PORT, n, NET_TOS_BEST_EFFORT);
}

static void stats_rx(const uint8_t src_ip[4], const uint8_t dst_ip[4],
                     uint16_t src_port, const uint8_t *req, uint32_t len)
{
    (void)dst_ip;

    if (len >= 1 && req[0] == 'g') {
        rxgate_rx(src_ip, src_port, req, len);
        return;
    }
    // Servo tuning: 's' <median_n> <ki_num BE32> <exact>  -> current tuning back.
    if (len >= 1 && req[0] == 's') {
        if (len >= 7)
            ptpv1_set_tuning(req[1],
                             (int32_t)(((uint32_t)req[2] << 24) |
                                       ((uint32_t)req[3] << 16) |
                                       ((uint32_t)req[4] << 8)  | req[5]),
                             req[6]);
        uint8_t mn, ex; int32_t ki;
        ptpv1_get_tuning(&mn, &ki, &ex);
        uint8_t *p = net_udp_payload_buf();
        uint32_t n = 0;
        put32(p, n, 0x53525630u); n += 4;   // 'SRV0'
        put32(p, n, mn);          n += 4;
        put32(p, n, (uint32_t)ki); n += 4;
        put32(p, n, ex);          n += 4;
        net_udp_commit(src_ip, src_port, STATS_PORT, n, NET_TOS_BEST_EFFORT);
        return;
    }
    // Per-flow detail, opcode 'f'. What we ACTUALLY bound: destination socket,
    // slot count, fpp and the slot->channel map. Exists because diagnosing "all
    // green in Dante Controller but no audio" repeatedly came down to guessing
    // at this from packet rates when the console had it written down.
    // 'p' -- pacing diagnostics: per-context DUE vs EMIT counts.
    //
    // "packets per second is a fraction of nominal" does not localise the
    // fault, and three attempts at inferring it from the aggregate were wrong.
    // due tells us what the pacing decided, emit what reached the wire.
    if (len >= 1 && req[0] == 'p') {
        uint8_t *p3 = net_udp_payload_buf();
        uint32_t n3 = 0;
        put32(p3, n3, 0x50414331u); n3 += 4;                 // 'PAC1'
        put32(p3, n3, DANTE_TX_CHANNELS / 8); n3 += 4;       // contexts
        put32(p3, n3, aaf_pkt_ts_now_sub_read()); n3 += 4;   // live sample counter
        net_udp_commit(src_ip, src_port, STATS_PORT, n3, NET_TOS_BEST_EFFORT);
        return;
    }

    if (len >= 1 && req[0] == 'f') {
        uint8_t *p = net_udp_payload_buf();
        uint32_t n = 0;
        put32(p, n, 0x464C5731u); n += 4;          // 'FLW1'
        put32(p, n, 6);           n += 4;          // N_FLOWS
        for (unsigned f = 0; f < 6; f++) {
            dante_tx_flow_detail_t d;
            dante_tx_flow_detail(f, &d);
            put32(p, n, ((uint32_t)d.in_use << 24) | ((uint32_t)d.nslots << 16) |
                        ((uint32_t)d.fpp << 8) | d.mcast);            n += 4;
            put32(p, n, ((uint32_t)d.dst[0] << 24) | ((uint32_t)d.dst[1] << 16) |
                        ((uint32_t)d.dst[2] << 8) | d.dst[3]);        n += 4;
            put32(p, n, d.dport);                                     n += 4;
            put32(p, n, d.age_ms);                                    n += 4;
            for (unsigned i = 0; i < 8; i += 2)
                { put32(p, n, ((uint32_t)d.chans[i] << 16) | d.chans[i+1]); n += 4; }
        }
        net_udp_commit(src_ip, src_port, STATS_PORT, n, NET_TOS_BEST_EFFORT);
        return;
    }
    // 'o' [ASCII signed decimal] -- set the TX timestamp offset in samples and
    // re-anchor. Replies with the value now in force so a sweep can confirm the
    // write landed rather than assuming it did.
    // 'F' [ASCII decimal] -- hold the USB async-feedback value (0 = auto loop).
    //
    // The wrapper exposes this precisely to sweep hardcoded feedback live and
    // characterise the host's response without a rebuild. There is a console
    // 'F' command already, but driving the UART perturbs the system under
    // measurement, so this is the same knob over UDP.
    //
    // Value is Q16.16 samples per microframe; nominal 6.0 = 393216.
    // 'u' -- USB ingress localisation. rx_beats is what the core hands the
    // endpoint; ep_out is what the endpoint hands the decoder. A gap between
    // them is audio arriving over USB and never reaching the ring, which is a
    // LEAK, not a rate error -- and a leak is what the feedback loop has been
    // silently compensating for.
    // 'M' [ASCII fpp] -- set the fpp used for ARC-created multicast bundles,
    // and (with no digits) create one on channels 1-2 so a stream at any fpp can
    // be decoded from the build host without Dante Controller.
    // 'P' [ASCII] -- pacing phase seed adjustment, swept live. It was a
    // #define tuned at fpp=16; at fpp=60 the emitted subsec comes out congruent
    // to 59 (i.e. -1) with the same value, so the correction is not the simple
    // fixed pipeline delay it was assumed to be.
    if (len >= 1 && req[0] == 'P') {
        if (len >= 2 && req[1] >= '0' && req[1] <= '9') {
            uint32_t v = 0; uint32_t i = 1;
            for (; i < len && req[i] >= '0' && req[i] <= '9'; i++)
                v = v * 10u + (uint32_t)(req[i] - '0');
            g_phase_adj = v;
        }
        uint8_t *p7 = net_udp_payload_buf();
        uint32_t n7 = 0;
        put32(p7, n7, 0x50485631u); n7 += 4;              // 'PHV1'
        put32(p7, n7, g_phase_adj); n7 += 4;
        net_udp_commit(src_ip, src_port, STATS_PORT, n7, NET_TOS_BEST_EFFORT);
        return;
    }

    if (len >= 1 && req[0] == 'M') {
        if (len >= 2 && req[1] >= '0' && req[1] <= '9') {
            uint16_t v = 0; uint32_t i = 1;
            for (; i < len && req[i] >= '0' && req[i] <= '9'; i++)
                v = (uint16_t)(v * 10 + (req[i] - '0'));
            if (dante_tx_fpp_supported(v)) g_mcast_fpp = v;
        } else {
            // FOUR channels, matching what DVS negotiates on unicast. The
            // remaining failure is DVS-unicast-only, and fpp=60 is proven good
            // (DVS has audio on a fpp=60 multicast), so slot count is the next
            // variable: 2 slots is 360 B of payload, 4 slots is 720 B.
            uint16_t ch[4] = { 1, 2, 3, 4 };
            dante_tx_bind_multicast(0x40, ch, 4);
        }
        uint8_t *p6 = net_udp_payload_buf();
        uint32_t n6 = 0;
        put32(p6, n6, 0x4D434131u); n6 += 4;              // 'MCA1'
        put32(p6, n6, g_mcast_fpp); n6 += 4;
        net_udp_commit(src_ip, src_port, STATS_PORT, n6, NET_TOS_BEST_EFFORT);
        return;
    }
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
