Nickster90s/Inferno-FPGA/(commit log)

2026-07-30 Fork avb-aes3 @466df96 -> USB-to-Dante, Phase 0 (strip AVB stack)
    Base: avb-aes3 @466df96, branch 48ch-6x8-aaf. The 48ch USB ingress, media
    clock NCO, gigabit LiteEth path and TSU are inherited working; this fork
    replaces the network transport (AVB/AVTP L2 -> Dante UDP/IP) and the clock
    protocol (802.1AS gPTP -> PTPv1).
    Phase 0 is purely subtractive: 314 insertions, 1111 deletions.
    Removed (parked in _avb_reference/):
    firmware/avdecc.[ch] 23,795 B .text - IEEE 1722.1 control plane
    firmware/srp.[ch] 5,682 B .text - 802.1Qat MSRP reservations
    firmware/aaf.[ch] 2,459 B .text + 32,852 B .bss - AVB audio format
    avtp_extractor.py, crf_extractor.py - AVB RX observers (T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
    [aaf.c, aaf.h, aes3_debug_tb.v, aes3_rx.v, aes3_tb.v]
2026-07-30 README: rewrite for the Inferno-FPGA USB->Dante project
    The inherited README described an 8-channel AVB+AES3 endpoint and was already
    materially stale against its own code (dated 2026-05-30, pre-48ch). Replaced
    with a README for what this actually is.
    Structure:
    - what it is, honest status (Phase 0 of 7; Dante transport NOT yet implemented)
    - legal + naming: not affiliated with Audinate; NOT a fork of inferno despite
    the repo name -- inferno is read as a specification only. ulpi_wrapper.v is
    GPL so any bitstream is encumbered.
    - why Dante-native rather than AES67, with the 9-byte wire format
    - architecture diagram + the two load-bearing invariants (CPU off the sample
    pat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
2026-07-30 Phase 0.5: split the image so firmware changes stop re-rolling P&R
    PROBLEM: firmware lived in the BRAM ROM, so every firmware edit changed
    bitstream contents and re-rolled nextpnr placement -- 6-10 min P&R plus a seed
    sweep plus a USB hardware re-test, per edit. With thousands of lines of new C
    still to write against an undocumented protocol, iteration cost would have
    dominated the schedule. Phase 0 demonstrated it: shrinking .text by 31 KB
    invalidated the pinned seed and dropped eth_rx_clk from 133.28 to 117.90 MHz,
    below the 125 MHz gigabit RGMII requirement.
    FIX: split the image.
    rom 12 KB frozen loader ~never changes
    sram 64 KB .data/.bss/stack
    code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
    [loader.c]
2026-07-30 Phase 0.5: hardware-verified. Fix 4 bugs only silicon could find.
    The host suite passed 17/17 and the first hardware run looked clean. It was
    not: netload succeeded FOR THE WRONG REASON -- the window never expired, so the
    loader listened forever -- and that single passing test concealed four defects.
    Test B alone proves nothing. A loader that never stops listening passes it every
    time. The real verification is a PAIR:
    A: with no host, the window must EXPIRE and fall through to SPI flash
    B: with a host, netload must still land
    Both now pass on bitstreams/phase0.5_FINAL_seed5.bit.
    BUGS FIXED (none reachable from the host-side test suite):
    1. tsu_addend CSRStorage had no reset value -> 0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
    [loader.c]
2026-07-30 Capture real Dante hardware: PTPv1 and multicast framing CONFIRMED
    Real Dante gear arrived on the bench (Focusrite RedNet AM2, 00:1d:c1:a1:72:3c,
    plus a controller). The plan treats the wire as the specification -- inferno is a
    reverse-engineering reference to read, not a source of truth -- so these captures
    are that confirmation, taken before writing any Phase 3/4 code.
    PTPv1 (Phase 4) -- wire format confirmed byte for byte against statime's
    inferno-dev messages_v1/header.rs:
    transport UDP multicast 224.0.1.129, event 319, general 320 as documented
    [0..2] 0001 version_ptp
    [2..4] 0001 version_network
    [4..20] "_DFLT" subdomain[16]
    [20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
2026-07-30 Capture a real Dante TRANSMITTER: corrects four plan assumptions
    Second device on the bench: RedNet A16R (00:1d:c1:2d:4a:18, 169.254.60.249), a
    16x16 analogue interface, so it advertises transmit channels. 18
    _netaudio-chan records captured.
    Port 4455 confirmed for _netaudio-chan (flow-control port, not 4440) as
    mdns_server.rs:110 has it. But four assumptions were wrong:
    1. nchan=64, not 8. I claimed "Dante's MAX_CHANNELS_IN_FLOW is also 8, mapping
    perfectly onto the existing 6x8 structure". That is false -- 8 is inferno's
    OWN limit, not a protocol limit. Our 6x8=48 remains legal (8 <= 64) but the
    justification was bogus, and larger flows are available if wanted.
    2. fpp=8,2 -- ma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
2026-07-30 RESOLVED plan risk #1: b.N= multicast bundles confirmed on real Dante
    A multicast flow was created on the RedNet A16R from Dante Controller, and both
    halves of the mechanism inferno documents (mdns_client.rs:240-270) appeared:
    bundle: 32@RedNetA16R _netaudio-bund._udp port 4321
    txtvers=1 id=32 nchan=8 fpp=16 rate=48000 enc=24
    latency_ns=1000000 a.0=239.255.201.92 p.0=4321 at2
    chan: gained b.32=1 ... b.32=8
    A receiver resolves a channel -> reads b.<bundle>=<pos> -> looks up the bundle
    record -> reads a.0/p.0 -> joins the group. The transmitter is never contacted.
    That is exactly the scope reduction Phase 5 depends on, and it is now confirmed
    on hardware rathe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
2026-07-30 Phase 2: net.c -- IPv4/UDP/ICMP/IGMP/ARP. FPGA answers ping.
    Replaces osc.c (179 lines: ARP replies, inbound UDP on one hardcoded port, no
    IP transmit path at all) with a real if deliberately small stack. Dante's entire
    control plane and PTPv1 are UDP and we originate most of it, so TX was the gap.
    net_init / net_set_ip / net_poll
    net_rx_frame ethertype 0x0806 / 0x0800 entry
    net_udp_bind 8-entry port -> handler table
    net_udp_send + net_udp_payload_buf/net_udp_commit for zero-copy
    net_igmp_join v2 reports on join and on query
    net_arp_lookup 6-entry cache, learns from every RX frame
    net_checksum / net_mcast_mac
    ICMP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
    [main.c, net.c, net.h, osc.c, osc.h]
2026-07-30 Phase 3 (part 1): mDNS responder -- FPGA visible as a Dante device
    First externally-visible Dante milestone. avahi-browse now lists the FPGA
    alongside the real Focusrite units:
    InfernoFPGA-000042 _netaudio-arc._udp 169.254.9.200:4440
    arcp_vers=2.8.9 arcp_min=0.2.4 router_vers=4.4.0
    router_info=InfernoFPGA mf=Inferno model=_00000000000000ff
    InfernoFPGA-000042 _netaudio-cmc._udp 169.254.9.200:8800
    id=020000fffe000042 process=0 cmcp_vers=1.2.0 cmcp_min=1.0.0
    server_vers=4.1.0 channels=0x60000130 mf=Inferno model=...
    New modules:
    dante_dev.c/.h device identity in one place, so mDNS, ARC, CMC and the info
    multicast cannot disagree -- Dante Controller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
2026-07-30 Phase 3 (part 2): ARC + CMC servers -- channels for the Routing tab
    User feedback from Dante Controller after part 1: the device appeared in the
    Device tab but with no network/device info, and was absent from the Routing tab.
    That is exactly what mDNS-only gets you -- discovery works, but DC has no
    channel list to route and no advertisement to confirm identity.
    New:
    dante_msg.c/.h the shared 10-byte request/response framing. THE TRAP it
    encapsulates: string fields are referenced by offsets
    ABSOLUTE FROM PACKET START, i.e. including the header
    (arc_server.rs:96). Get it wrong and DC shows the device with
    blank na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
    [dante_arc.c, dante_arc.h, dante_cmc.c, dante_cmc.h, dante_msg.c, dante_msg.h, main.c]
2026-07-30 Phase 3 (part 3): device-info + heartbeat multicast
    Diagnosis first: with mDNS, ARC and CMC all working and verified, Dante
    Controller still showed the device with no network/device info. Captured 20 s of
    traffic to/from the FPGA -- 3 packets, all mDNS FROM us. DC was sending us
    NOTHING.
    So the gap was upstream of everything I had built. Dante Controller does not
    poll a device it has merely seen in mDNS; real devices ANNOUNCE themselves on
    the info/heartbeat multicast and DC populates its list from that. Without it we
    had a name and nothing else -- exactly the reported symptom.
    dante_info.c/.h:
    - 1 Hz heartbeat, port 8700 -> 224.0.0.233:8708, start_code 0xfffe, opcode
    0008 0001 1000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
2026-07-30 Phase 3 gate MET: device appears in Dante Controller
    InfernoFPGA-000042 now shows in Dante Controller alongside both Focusrite
    RedNets, with the correct name and Clock Source = Dante. Screenshot saved to
    docs/milestones/.
    Sync shows RED, which is correct rather than broken: we do not implement PTPv1
    yet, so Primary v1 Multicast is N/A for us while the A16R is Leader and the AM2
    is Follower. Phase 4 turns that green, and the screenshot states precisely what
    it has to achieve.
    Recording what the diagnosis was worth, because the build order was wrong and
    only measurement caught it: mDNS, ARC and CMC were all implemented and verified
    against the board, and Controller still showed nothing. A 20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
2026-07-30 Phase 3: product + network info, and fix init-time TX being silently lost
    Dante Controller showed our device with a blank Primary Address, blank Model
    Name and blank versions. Blank address is the one that matters: without an IP,
    DC cannot send ARC requests, so the Routing tab stays empty no matter how
    correct the ARC server is. We only answered BOARD info (0x0060); Model/Version
    come from PRODUCT info (0x00c0) and the address from NETWORK info (0x0013,
    replied with opcode 0x0011 -- request and reply opcodes differ, easy to miss).
    Added send_product_info() and send_network_info() per inferno
    info_mcast_server.rs:139-156 and :352-376, plus request dispatch for
    0x60/0x61 (board), 0xc0/0xc1 (p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
    [dante_info.c, net.c]
2026-07-30 Phase 3: announce device info continuously, not as a boot burst
    Symptom: the device appeared in Dante Controller with full Routing and Device
    Info, then vanished when the user clicked Refresh.
    Captured a Refresh. Two things stood out:
    - Dante Controller (169.254.91.34) sent NO unicast to ANY device during the
    entire refresh -- not to us, not to the RedNets. Only mDNS queries. So DC
    does not poll to rebuild its list; it rebuilds from multicast announcements
    it has received.
    - Our mDNS answers were correct and complete (PTR + SRV + TXT + A with
    cache-flush, 8 packets, indistinguishable from the A16R's), so discovery was
    never the problem.
    Then measured what real devi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
    [dante_info.c]
2026-07-30 Phase 4: PTPv1 slave -- full clock exchange with the Dante Leader
    Addresses three symptoms that were all one missing piece: Sync red, Primary v1
    Multicast empty, and the device being offerable as Preferred Leader.
    ptpv1.c/.h -- IEEE 1588-2002 slave on UDP multicast 224.0.1.129, event 319 /
    general 320, IP TOS 0xE0 (DSCP CS7). Wire format taken from the bench capture of
    a RedNet A16R rather than from a reference implementation:
    40-byte header, version_ptp=1, version_network=1, subdomain "_DFLT",
    source_uuid = sender MAC, control at [32], flags at [35] bit3 = ptp_assist.
    Sync body originTimestamp at [40..48] = u32 sec + u32 ns (NOT PTPv2's 6+4).
    The A16R's Sync carries flags 0x0c -- b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
    [main.c, ptpv1.c, ptpv1.h]
2026-07-30 Fix red Sync: one clock owner, and an absolute step at cold boot
    Two bugs, both of which kept the PTPv1 servo from ever steering the clock.
    1. TWO SERVOS, ONE REGISTER. main() still called gptp_poll() after Phase 4
    added ptpv1.c. Both servos call gptp_set_addend_full(), so two control loops
    were steering the SAME 52-bit TSU addend from DIFFERENT masters -- gPTP from
    the 802.1AS grandmaster on the bench, PTPv1 from the Dante Leader. Neither
    could converge and Dante Controller correctly showed Sync red.
    gPTP is now counted but not processed, and not polled. It stays linked for
    its TSU accessors, uptime and servo helpers, which ptpv1.c reuses. Verified:
    the FPGA no longer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
    [dante_info.c, main.c, ptpv1.c]
2026-07-30 Send the 0x8000 clock record; find RX timestamps quantised to 3 kHz
    Sync stayed red after the servo fix because DC was never given anything to
    judge. Two findings, one fixed here and one measured and left for gateware.
    1. WE SENT ONE HEARTBEAT RECORD OUT OF FIVE. Comparing our 1 Hz heartbeat with
    the two real Dante devices on the bench:
    A16R 172 B 0x8000 0x8001 0x8002 0x8003 0x8004
    other 68 B same five (split across datagrams)
    us 48 B 0x8001 only
    Dante Controller does NOT poll ARC -- 45 s of tcpdump on port 4440 caught
    zero packets -- so the heartbeat is the only continuous state it has. The
    missing 0x8000 is the clock-sync-quality record: its four lea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
    [dante_info.c, ptpv1.c]
2026-07-30 tools: rx_ts_probe.py — controlled-stimulus test of RX timestamp resolution
    Sends UDP at deliberately uneven gaps and compares what the firmware
    timestamped against what we sent. Currently reports a 333.35 us quantum; this
    is the tool that will confirm a gateware fix at the capture site, so it belongs
    in the repo rather than a scratch dir.
2026-07-30 Fix RX timestamp quantisation and the recursive path-delay estimate
    RX timestamps were quantised to 333.35 us; they are now good to ~1 us, and
    PTPv1 finally has a usable offset. Two bugs.
    1. TIMESTAMP RING RAN PERMANENTLY SATURATED. The ring is pushed by gateware on
    every committed frame and popped by dispatch_rx once per slot. Nothing pops
    it before firmware starts, so the loader's netload window is long enough to
    fill all 8 entries. After that push and pop rates are identical -- both are
    exactly once per committed frame -- so the backlog never drains and every
    timestamp firmware reads stays 7-8 frames stale for the rest of the run.
    MEASURED before: level pinned at 7-8 o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
    [main.c, ptpv1.c]
2026-07-31 Send heartbeat records 0x8003 and 0x8004
    The clock is no longer the blocker: after the timestamp-ring fix the offset
    converges to 273..531 ns, against 218..388 ns for the RedNet A16R on the same
    network. That is shipping-hardware parity, so if Dante Controller still shows
    Sync red it is not judging us on the offset -- 0x8000 was necessary but not
    sufficient, and the remaining gap is in what else we report.
    Real devices send five heartbeat records; we sent two. Adding 0x8003 (sample
    rate + per-flow words) and 0x8004 (per-flow words) brings our heartbeat to 176
    bytes against the A16R's 172, and it parses cleanly record by record.
    These were left out earlier because each begins with a count t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
    [dante_info.c]
2026-07-31 Populate ARC 0x1100/0x1102; DC was reading an empty capability table
    Your Clock Status screenshot showed the real problem, and it was not the clock:
    InfernoFPGA Sync RED v1 Multicast N/A v2 N/A PTPv2 dom 0, pri 0/0
    RedNetA16R Sync green v1 Multicast Leader v2 Disabled PTPv2 N/A
    RF04-AM2 Sync green v1 Multicast Follower v2 Disabled PTPv2 N/A
    Exactly inverted. DC had classified us as a PTPv2 device and was looking for us
    in the v2 clock domain, where we do not participate at all -- which is why
    getting the PTPv1 offset from 190 us of noise down to 290 ns (against the
    A16R's 218 ns on the same wire) changed nothing on screen. The clock was never
    what DC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
    [dante_arc.c]
2026-07-31 Implement clock-stats (0x21): tell DC which v1 leader we follow
    This is the reply whose absence made Dante Controller classify us as a PTPv2
    device. It carries the PLL-locked flag, the frequency offset, and -- the part
    nothing else we send conveys -- the MASTER CLOCK ID, i.e. which leader we
    follow. With no reply DC has no v1 clock state for us at all and falls back to
    defaults, which display as "PTPv2, domain 0, priority 0/0" with Primary v1
    Multicast N/A.
    That explains two earlier dead ends. Driving the PTPv1 offset from 190 us of
    noise down to 290 ns (against the A16R's 218 ns on the same wire) changed
    nothing on screen, and replaying a real device's ARC 0x1100/0x1102 property
    tables byt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
    [dante_info.c]
2026-07-31 Answer unknown ARC opcodes with an error instead of dropping them
    Your console, refreshing the Clock Status tab, showed DC asking us for exactly
    two things and getting nothing back:
    [arc] unhandled opcode 0x2204 from 169.254.149.45 (x3)
    [arc] unhandled opcode 0x4100 from 169.254.149.45 (x2)
    Real hardware does not implement these either. Queried directly with
    tools/arc_query.py, both RedNets answer 0x2204 with code 0x0022 and 0x4100 with
    code 0x0030. What they do is ANSWER. We returned silence -- the dispatch
    default was `return;` with the comment "silence beats a wrong answer".
    That instinct is wrong for this protocol, and the evidence is on the bench: a
    client cannot distinguish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
    [dante_arc.c]
2026-07-31 Lock PTPv1 in ~16 s instead of 3-5 minutes
    Two changes, after one wrong turn worth recording.
    WHAT DID NOT WORK: raising the servo gains. Lock was paced by the integral
    having to wind up to our crystal offset (~-4880 ppb), because proportional
    action alone settles at a standing error of crystal/KP -- with KP = 0.2 that is
    23 us, exactly the 17..35 us plateau we sat on while the frequency looked
    perfectly stable. The obvious fix, KP 0.5 / KI 0.02 sized as a wn = 0.3,
    zeta = 0.9 loop, MADE IT WORSE: it rang (+705668, -190902, -440991 ppb) and had
    not settled after 97 s. The 7-deep median delays the measurement ~1.75 s, and
    no gain choice both tolerates that delay and converges in seconds. Rev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
    [ptpv1.c]
2026-07-31 Damp the path-delay estimate: stable lock, no more flapping
    The console showed the servo was already excellent and something else was
    knocking it out:
    [ptpv1] freq acquired: -4757 ppb (window 8009 ms)
    [ptpv1] LOCKED, offset -44 ns
    [ptpv1] unlocked, offset -13612 ns
    [ptpv1] LOCKED, offset 468 ns
    [ptpv1] unlocked, offset 8547 ns
    -44 ns proves the loop is sound. The excursions were the path-delay estimate
    fighting the phase servo.
    mean_path_delay = ((t2-t1) + (t4-t3)) / 2 cancels our clock offset only if that
    offset is the SAME at t2 and at t3. That holds once locked, but not while the
    servo is still moving, so each raw estimate carries whatever phase correction
    happened in between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
    [ptpv1.c]
2026-07-31 On-device control-plane capture, fetched over UDP
    Answers a question that has been blocking this investigation: we could not see
    what Dante Controller actually says to us.
    DC talks to the board over UNICAST, and the bench switch is unmanaged -- it
    floods multicast and broadcast but forwards unicast only to the destination
    port. So a tcpdump on the build host sees our mDNS/heartbeat/device-info
    multicast and NONE of DC's requests or our replies. Several conclusions during
    this bring-up were drawn from that blind spot and were simply wrong, notably
    "DC does not poll ARC", from a 45 s capture on port 4440 that caught zero
    packets while the board's console was logging ARC requests the whole tim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
    [cap.c, cap.h, main.c, net.c]
2026-07-31 Answer ARC 0x2204 with OK, not an error -- DC was stuck in a retry loop
    The on-device capture found it. Refreshing the Clock Status tab makes Dante
    Controller loop at ~1 kHz:
    RX op=0x2200 tx flows -> TX OK, zero flows
    RX op=0x2204 tx flow detail -> TX code=0x0022 <-- error
    RX op=0x2200 ... and round again, thousands of times
    DC never completes the refresh, so it never populates the clock columns and
    falls back to defaults -- exactly the "PTPv2 Domain 0 / Priority 0/0, Primary
    v1 Multicast N/A" row we kept seeing while the RedNets showed v1
    Leader/Follower. The clock was fine; DC was never getting far enough to look
    at it.
    Replaying DC's exact request bytes at real har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
    [cap.c, dante_arc.c]
2026-07-31 Echo the request seqnum and opcode in the clock-stats reply
    The on-device capture showed the 0x21 exchange completing with correct content
    -- LOCKED, right ppb, right master clock id -- while Dante Controller still
    displayed PTPv2 Domain 0 / Priority 0/0 and Primary v1 Multicast N/A. So DC was
    receiving the reply and not ingesting it.
    The reason is visible once request and response are put side by side:
    DC asks: seq=0x03de opcode=073e 0021 0000 0064
    we sent: seq=0x010b opcode=072a 0020 0000 0000
    We echoed neither. The seqnum came from our own counter and the opcode was
    inferno's hardcoded constant. A controller that cannot correlate a response
    with the request it issued has no r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
    [dante_info.c]
2026-07-31 Send clock stats to the device-info multicast group, not to the requester
    inferno sends clock stats to device_info_destination (224.0.0.231:8702), the
    same place as every other info message. This replied UNICAST to whoever asked,
    which is where I deviated from the reference when implementing 0x21.
    That deviation explains the symptom exactly. Our device info, product info and
    network info reach Dante Controller as the 3 s multicast ANNOUNCEMENTS, and
    those DC ingests happily -- the Device Info tab has been fully populated all
    along. Clock stats was the ONE message we only ever sent unicast, on request,
    and it is the ONE thing DC never acted on: the exchange completed, the content
    was correct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
    [dante_info.c]
2026-07-31 Report PTP port state SLAVE and MAC-form clock ids -- the Follower field
    Sync went green but Primary v1 Multicast stayed N/A where the RedNets show
    Leader/Follower. On the wire we were already behaving exactly like a follower:
    30 s of PTPv1 shows us sending only DELAY_REQ (x8), no Sync at all, which is
    precisely what the AM2 does (DELAY_REQ x6). So DC was not inferring a role from
    our traffic -- it reads a REPORTED field, and we were not reporting it.
    Making clock stats multicast in the previous commit is what made this findable:
    the RedNets' own replies go to 224.0.0.231 as well, so they became visible to
    the build host for the first time. While ours was unicast, theirs were too, and
    the s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
2026-07-31 Announce clock stats periodically, so Sync goes green without a manual refresh
    Dante Controller requests clock stats (0x21) only during a manual refresh. At
    boot we honestly report "not locked" -- we have not locked yet at that point --
    DC caches it, and nothing updates it afterwards. So Sync came up red and stayed
    red until the user clicked Refresh, even though the clock locks ~12 s after
    boot and holds.
    Clock stats now goes out on the same 3 s cadence as device, product and network
    info. That matches how DC consumes device state generally: it builds its view
    from what arrives on the info multicast group rather than by polling, which is
    the same finding that forced the other announcements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
2026-07-31 Model clock stats on DVS ("Follower Only") rather than the AM2 ("Follower")
    You activated Dante Virtual Soundcard and noted it shows as "Follower Only"
    while we show "Follower". DVS is the right template for this design, because
    "Follower Only" is what we actually ARE: we never transmit Sync and never join
    BMCA, so we cannot be elected leader under any circumstances. The AM2 is a
    device that COULD be elected and merely is not, and modelling on it declared us
    as that.
    DVS is also the closest analogue in kind -- a device with no local clock
    hardware to offer -- which is exactly our situation.
    Captured by having DC query it (DVS ignores a direct request, like the RedNets;
    only the controller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
2026-07-31 Rename to N-Series-Switchover; revert the lock gate that broke locking
    Name: "N-Series Switchover" as asked, with the space as a hyphen -- Dante device
    names double as the mDNS hostname, so a space is invalid and DC rejects such
    names (every real device here follows the rule, e.g. RF04-RedNetAM2-RFtech).
    MAC suffix dropped by request. Trade-off worth stating: two of these boards on
    one network would now share a name and hostname and collide in mDNS. Fine for a
    single bench unit; put the suffix back if a second appears.
    REVERT: gating lock on mean_path_delay != 0 broke locking entirely.
    The intent was to suppress the single unlock/relock right after boot, where the
    first DelayResp shifts th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
    [dante_dev.c, ptpv1.c]
2026-07-31 Wait for the path delay before locking, with a bounded grace period
    Fixes the single unlock/relock right after boot:
    [ptpv1] LOCKED, offset -60 ns
    [ptpv1] unlocked, offset -13468 ns
    [ptpv1] LOCKED, offset 413 ns
    mean_path_delay starts at 0, so the offset is computed without it and can look
    excellent until the first DelayResp lands and shifts it by the whole path delay
    at once. The size confirms it: the delay measures 13.6 us here, and the
    excursion was -13468 ns.
    Three parts:
    1. Lock waits for a path-delay measurement. A bare `mean_path_delay != 0` gate
    was tried first and was WRONG -- when the estimate stalls at 0 the gate never
    opens and the device never locks at all, which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
    [ptpv1.c]
2026-07-31 Announce sample-rate and capability messages (0x0080, 0x0084)
    Real devices announce 0x0078/0x0080/0x0082/0x0084/0x1007/0x1009 on the info
    group; we announced none of them. The pattern all through this bring-up is that
    Dante Controller falls back to a DEFAULT when a device says nothing -- that is
    how we ended up displayed as PTPv2 Domain 0 -- and "Enable Sync To External"
    offering an enabled checkbox for us, while both DVS and the AM2 show N/A, has
    the same shape.
    HONEST LIMIT, stated because it matters for what to try next: I could NOT
    isolate the field that controls that column. It is not any of these on the
    evidence available -- [12:14] of 0x0080 is 0x0002 on BOTH the A16R (checkbox)
    and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
2026-07-31 Lock only once the path delay has SETTLED, not merely become non-zero
    The previous gate was not enough. It still produced:
    [ptpv1] LOCKED, offset -285 ns
    [ptpv1] unlocked, offset -13295 ns
    [ptpv1] LOCKED, offset 410 ns
    mean_path_delay was non-zero at lock time, so the gate opened -- but it had not
    converged. The first accepted measurement is taken while the servo is still
    moving and can be well off; seeding from it and then smoothing at alpha = 1/8
    crawls toward the truth over tens of seconds, dragging the offset with it. The
    -13295 ns excursion is that drift, the same 13.6 us the delay eventually
    settles at.
    Two changes:
    1. The first PD_MIN_SAMPLES (4) measurements use a running M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
    [ptpv1.c]
2026-07-31 Answer ARC 0x1100 for the KEY LIST Dante Controller actually sends
    The on-device capture, once it stopped being flooded by our own multicast,
    showed DC's 0x1100 is not the empty probe I had been testing with. It carries a
    list of 25 property keys:
    0201 8204 8205 0210 0211 8218 8219 8301 8302 8306 0310 0311 0303 8021 00f0
    8060 0022 0063 0064 0065 0222 0212 8321 0066 0214
    and the correct reply is (key, value) pairs answering exactly those -- 146
    bytes. We returned arc_1100_body for every request: the AM2's answer to an
    EMPTY probe, a different shape at 202 bytes over a different 31-key set. Five
    of the keys DC asks for (8218, 8219, 00f0, 0065, 0066) do not appear in it at
    all. DC cannot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
    [cap.c, dante_arc.c, dante_info.c]
2026-07-31 Declare key 0x0064 = 0 explicitly: model 0x1100 on DVS, not the AM2
    You were right to say look at DVS. Copying the AM2's keyed reply was not enough,
    and comparing the two shows why -- key 0x0064 is the external-clock capability,
    and the three devices treat it three different ways:
    A16R (checkbox) ... 0063 0001 0064 0001 ... present, value 1
    DVS (N/A) ... 0063 0000 0064 0000 ... present, value 0
    AM2 (N/A) ... 0063 0001 0000 0064 ... ABSENT
    Both DVS and the AM2 display N/A, so copying either "should" have worked. It did
    not: we copied the AM2, which OMITS the key, and DC fell back to its default and
    offered the checkbox anyway.
    That is the same rule behind near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
2026-07-31 Take 0x1102 from DVS too -- the two property tables must agree
    Searching deeper turned up a contradiction I had introduced myself.
    0x1102 declares which properties EXIST; 0x1100 supplies their values. The
    previous commit switched 0x1100 to DVS's -- declaring key 0x0064 (external
    clock) present with value 0 -- while leaving 0x1102 as the AM2's, which does not
    list 0x0064 at all. We were telling Dante Controller the property does not exist
    and handing it a value for it in the same breath.
    DVS 28 keys, 0x0064 = 0x0001 (exists) -> N/A
    A16R 33 keys, 0x0064 = 0x0001 (exists) -> checkbox, and 0x1100 value 1
    AM2 31 keys, 0x0064 ABSENT -> N/A
    ours 31 keys, 0x0064 ABSE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
2026-07-31 Declare the full 0x1000 capability word, not just the two named bits
    Searching deeper: we have been under-declaring capabilities to Dante Controller
    since Phase 3, and it took comparing the very first thing DC asks to see it.
    A16R 1f f9 DVS 1f f9 AM2 1d f9 ours 00 30
    flags2 is 0xf9 on ALL THREE real devices. inferno names only two of its bits
    (bit4 supports_tx_channel_rename, bit5 supports_tx_multicast) and we set exactly
    those, leaving every unnamed bit clear -- so we sent 0x30 where shipping
    hardware sends 0xf9, and 0x00 for the leading byte where it sends 0x1f.
    Under-declaring is precisely how this bring-up kept landing on DC's defaults
    instead of our values: silen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
2026-07-31 Send DVS's clock-domain response for 0x3300, not inferno's constant
    Systematically diffing every ARC opcode against DVS (rather than guessing which
    one) turned up 0x3300 -- the clock-domain response, and the one arc_server.rs:652
    calls out: "WTF: this is necessary to avoid 'clock domain mismatch' error in
    DC". inferno hardcodes 38 00 38 fd 38 fe 38 ff and we copied that.
    It is not a constant. All three devices differ:
    DVS (N/A) 380038fb38fc38ff 00000000 12 bytes
    A16R (checkbox) 3800397f398039ff 7900efef 12 bytes
    AM2 (N/A) 380038fd38fe38ff 8 bytes
    inferno's "constant" is simply the AM2's, and we had been sending an 8-byte
    reply where the device we model ev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
    [dante_arc.c]
2026-07-31 Fix PTP lock: ignore acquisition-window delay samples; size thresholds for PTPv1
    Two problems, one a regression I introduced, one a criterion inherited from the
    wrong protocol.
    1. PATH-DELAY SAMPLES TAKEN DURING FREQUENCY ACQUISITION WERE INFLATED.
    ((t2-t1) + (t4-t3)) / 2 cancels our clock error only if that error is the
    same at t2 and t3. While the acquisition window is open the clock is
    free-running and drifting BY DESIGN, so the halves do not cancel: the
    estimate came out ~41 us against a true ~20.5 us. The acquisition phase-step
    then used that inflated value and left a standing offset equal to the
    difference, which only the integral could remove at ~150 ns/s. It looked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
    [ptpv1.c]
2026-07-31 Phase 5: dante_packetizer.py, derived from the AAF packetizer
    Retargets the 6x8 time-mux packetizer from AVTP to Dante's UDP wire format.
    Derived from aaf_packetizer.py rather than written fresh, deliberately: that
    file's shape encodes a long list of hardware-found bugs, and every one of them
    is preserved unchanged --
    - TXFrameArbiter, including firmware_granted gating the TSU TX latch
    - channel-addressed USB ingress (the 48-ch "corrupt after a while" fix)
    - 36-bit parity-avoiding BRAM packing, which nextpnr-xilinx would otherwise
    drop when packing a 32-bit BRAM
    - `primed` hysteresis (a drained ring wrapping through stale data forever)
    - block_level / _BL_CENTRE feeding the US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
2026-07-31 Phase 5: dante_tx.c, and wire the Dante packetizer into the SoC
    dante_tx.c binds the packetizer to 6 multicast bundles of 8 channels and gates
    the talker on PTPv1 lock. avb_soc.py now instantiates DantePacketizer with
    fpp=16 in place of AAFPacketizer.
    The instance is still called aaf_pkt deliberately -- renaming it would churn the
    USB feedback servo wiring, the arbiter hookup and every firmware CSR accessor
    for no benefit.
    WHAT dante_tx.c DOES
    Allocates one 239.255.x.y group per bundle, keyed off our MAC so two boards on
    one network cannot collide, and derives each Ethernet multicast address from
    the low 23 bits of the group. Bit 23 is discarded, as it must be -- 32 IPv4
    groups share each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
    [dante_tx.c, dante_tx.h, main.c]
2026-07-31 Fix elaboration order and drop the AVTP sequence increment
    Two errors caught by elaborating before spending 30 minutes on a seed sweep:
    ts_sub used by the pacing logic at line 444 but defined ~60 lines later --
    the timestamp counters landed where the presentation ramp used to be, which
    is after the pacing block rather than before it. Moved to just after strobe
    is defined, which is the earliest point they can exist.
    A leftover NextValue(seq, seq + 1) in the STREAM state. Dante's header has no
    sequence number; the sample-index timestamp is the ordering.
    Design now elaborates through to nextpnr.
2026-07-31 Put the frame RAM in BRAM: the 109:1 mux was wrecking timing
    First seed sweep of the Dante design was bad: 6 of 8 seeds STALLED in HeAP, and
    both that placed failed --
    seed 3 sys 52.55 usb 72.14 eth_tx 143.10 eth_rx 120.24
    seed 6 sys 53.92 usb 84.47 eth_tx 160.59 eth_rx 109.13
    against sys >= 55 (build-reject floor; sub-50 setup violations have silently
    corrupted audio here before) and eth_rx >= 125 for gigabit RGMII.
    The cause was a step of the plan I skipped when deriving the packetizer. AAF's
    234-byte frame is 59 words; Dante's 435-byte frame is 109. Left as an Array of
    registers that is a 109:1 32-bit read mux -- and the plan names this exact
    structure as the one that "ha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
2026-07-31 Pin seed 8, retire the AVB talker binding, link Phase 5 firmware
    SWEEP 2, after moving the frame RAM into BRAM:
    SEED SYS USB ETH_TX ETH_RX VERDICT
    1 74.34 87.19 163.19 129.05 PASS
    2 72.05 89.43 162.15 121.45 FAIL
    3 64.33 87.43 156.13 147.43 PASS
    4 62.37 91.02 133.37 133.19 PASS
    5 67.29 82.41 169.78 134.48 PASS
    6 64.16 102.62 163.45 130.24 PASS
    7 84.85 97.29 136.15 159.31 PASS
    8 69.19 88.68 147.60 165.32 PASS
    Against the previous sweep: 0 HeAP stalls (was 6 of 8), 7 PASS (was 0), and sys
    62-85 MHz (was 52-54). One structural change, the 109:1 read mux, accounted for
    all of it.
    SEED 8 pinned,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
    [main.c]
2026-07-31 Phase 5 audio verified on the wire: 48 ch, 6 flows, correct Dante framing
    Flashed seed 8 and decoded our own packets off the wire. Every field matches
    what real Dante hardware emits (captures/dante_audio_multicast.pcap):
    frames 449376 in 25 s, ALL exactly 435 bytes
    flows 239.255.0.66 .. .71, one per bundle, evenly loaded
    rate ~2995 pps/flow, ~17972 pps total (48000/16 x 6)
    Dante tag 0x02
    IP ID 0
    IP TOS 0xb8 (DSCP EF)
    UDP checksum 0
    timestamps advance by exactly 16 per packet per flow -- no gaps, no
    duplicates -- and every one is a multiple of 16
    That satisfies the Phase 5 exit criteria for frame geometry and t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
    [dante_tx.h]
2026-07-31 Serve _netaudio-chan and _netaudio-bund records -- the subscribe path
    mdns.c served only _netaudio-arc and _netaudio-cmc, which is enough for Dante
    Controller to SHOW the device and is why Phase 3 looked complete. It is not
    enough for a receiver to SUBSCRIBE to it.
    The subscribe path is entirely mDNS, which is why the transmit side needs no
    flow-control server at all:
    1. query <chname>@<host>._netaudio-chan._udp for TXT
    2. find a key starting "b." -- b.<bundle>=<position>
    3. query <bundle>@<host>._netaudio-bund._udp for TXT
    4. read a.0 / p.0 and JOIN that multicast group
    The transmitter is never contacted. This is the plan's risk #1, and it is now
    served rather than assumed.
    Form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
2026-07-31 Revert the speculative checkbox changes -- they broke the Routing tab
    You were right that the checkbox hunt broke Routing. Reverting dante_arc.c to
    00f641e, the last state where Routing demonstrably worked.
    Reverted, with what each was worth:
    0x1000 flags 0x0030 -> 0x1ff9 did not fix the checkbox
    0x1102 AM2 -> DVS table did not fix the checkbox
    0x1100 keyed AM2 -> DVS did not fix the checkbox
    0x3300 8 -> 12 bytes did not fix the checkbox
    Every one was speculative, every one changed a field whose meaning is not
    established, and not one achieved what it was for. Keeping them would trade a
    working Routing tab for nothing.
    The 0x1000 flags change is t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
    [dante_arc.c]
2026-07-31 Match the service suffix before the instance -- bundle records were unresolvable
    Your subscription attempt found it: "1 - Left@RF04 <- 1@N-Series-Switchover,
    Unresolved, cannot find this channel on the network".
    The channel record resolved fine. The BUNDLE record did not, and a receiver
    cannot subscribe without it -- it reads b.<bundle>= off the channel record and
    must then resolve <bundle>@<host>._netaudio-bund._udp to get a.0/p.0.
    Cause: match_chan_inst and match_bund_inst compared only the instance label and
    never the service suffix, and they share one want_idx. A query for
    1@<host>._netaudio-bund._udp.local fell into the channel loop and was answered
    with the CHAN record for index 2 --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
    [mdns.c]
2026-07-31 Revert the 2-channel receiver: it crashed Dante Controller
    Advertising 2 RX channels so a real transmitter would drive a unicast flow
    setup at us -- letting us observe the one part of the protocol we have no
    reference for -- crashed DC. Reverted to transmit-only.
    The idea was sound. The execution was not: I built the RX channel descriptor by
    MIRRORING the TX one (put_common_descriptor + name offset), on the unstated
    assumption that both directions share a descriptor format. There is no evidence
    for that. A receive channel almost certainly carries subscription state a
    transmit channel does not, and handing DC a malformed descriptor is a good way
    to crash it.
    This is the same mistake as the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
    [cap.c, dante_arc.c, dante_dev.h]
2026-07-31 Receive channels with the correct 20-byte descriptor; find why patching fails
    RX channels are back, built from proto_arc.rs this time instead of by analogy.
    get_receive_channels::ChannelDescriptor is 20 bytes -- channel_id, unknown1_6,
    common_offset, tx_channel_name_offset, tx_hostname_offset, friendly_name_offset,
    subscription_status:u32, unknown2_0:u32 -- against the TRANSMIT side's 8. The
    first attempt mirrored the transmit descriptor, so DC read 8 bytes per item
    where it expected 20, walked off the end of the array, and crashed. The
    definition was in inferno the whole time and I built from analogy instead.
    Verified: 0x3000 returns space=2 actual=2 with 20-byte items, 0x1000 reports
    48 t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
    [cap.c, dante_arc.c, dante_dev.h]
2026-07-31 Implement ARC 0x3010: store the subscription so a patch sticks
    0x3010 is a SET, not a query. Dante Controller sends "subscribe RxN to
    <channel>@<host>" and reads 0x3000 back to confirm. We were answering OK and
    discarding it, then reporting subscription_status=0 -- claiming success and
    immediately contradicting ourselves, which is why patching failed SILENTLY
    rather than erroring.
    Request layout, read off the wire while DC patched the A16R to us:
    0201 0001 0034 0037 00.. "01" 00 "RedNetA16R"
    | | | |
    | | | +-- tx hostname offset absolute from packet start
    | | +------- tx channel name offset
    | +------------ our RX channel id, 1-based
    +--------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
    [dante_arc.c]
2026-07-31 Match the A16R's mDNS response layout: echo the question, A in additional
    Both directions failed with "cannot find this channel on the network" -- our
    transmit channels from the AM2's side, and our receive subscription. Same
    symptom both ways points at mDNS resolution, not at subscription logic.
    Comparing our reply with a working one, for the same kind of query:
    A16R (resolves) qd=1 an=2 ar=1 question echoed, SRV+TXT, A additional
    ours (did not) qd=0 an=3 ar=0 no echo, A record among the answers
    Two changes, both read off the A16R rather than reasoned about:
    - echo the question back (qdcount=1). mDNS responses usually omit it, so this
    is matching what actually re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
    [mdns.c]
2026-07-31 Revert the mDNS question echo -- a working reply has qd=0
    Captured a resolution that WORKS: DVS resolving an A16R channel. It queried
    once, got a 141-byte reply, accepted it and moved straight on to the bundle
    record. That is the reference this has been missing all along -- every previous
    comparison was against replies that were themselves being re-queried.
    A16R (accepted) len=141 qd=0 an=1 ar=3 ~8 compression pointers
    ours (re-queried) len=322 qd=1 an=2 ar=1 ~1 pointer
    Three differences, and the question echo is one I INTRODUCED. It came from an
    earlier capture showing qd=1, which must have been a different response type;
    the reply DVS actually accepts has qd=0. Reverted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
    [mdns.c]
2026-07-31 mDNS name compression: 322 -> 223 bytes
    A working A16R reply -- one DVS accepted -- is 141 bytes with ~8 compression
    pointers. Ours was 322 with ~1, because every name was written out in full.
    That was a deliberate simplification in the plan ("emit uncompressed names"),
    legal per RFC 1035, and the strongest remaining candidate for why two
    independent RedNet resolvers re-queried our records rather than accepting them.
    Added a small per-message cache of names already written; a repeat emits the
    2-byte 0xC0 pointer instead of the full name. That is where nearly all the
    saving is -- the instance name owns both the SRV and the TXT record, and the
    SRV target reappears as the A record's owner.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
    [mdns.c]
2026-07-31 Put TXT in the additional section, matching the reply DVS accepts
    before qd=0 an=2 ar=1
    after qd=0 an=1 ar=2
    A16R qd=0 an=1 ar=3 (the reply DVS accepted)
    Only the SRV answers the question; the TXT and A records ride along as
    supporting data. We had SRV and TXT both in ANSWERS, and a resolver that looks
    for the TXT among the additionals will not find it there.
    Compression (previous commit) and this are the two differences the captured
    known-good reply showed. Both are now matched in shape. What remains is
    theirs ~8 compression pointers to our ~3 -- they compress shared SUFFIXES
    (pointing into the middle of an earlier name), we only match whole names --
    which is the rest of the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
    [mdns.c]
2026-07-31 Match TTL 10 and drop the cache-flush bit -- the byte-level difference
    The byte-for-byte comparison you asked for, against a channel reply the RedNets
    accept:
    A16R (accepted) ttl=10 class=0x0001 no cache-flush
    ours (rejected) ttl=4500 class=0x8001 cache-flush on every record
    Neither was visible in the header counts I had been fixing for several rounds --
    question echo, section layout, name compression were all real differences, but
    they were the ones easy to see, not the ones most likely to matter.
    TTL: this file claimed 4500 "matches what Dante devices use". It does not. Real
    Dante channel records live 10 seconds, which fits state that changes whenever a
    patch changes.
    CAC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
    [mdns.c]
2026-07-31 Fix nchan from inferno (48 -> 8); add suffix compression (not yet effective)
    Looking at inferno again, as you suggested, found a CONTENT bug that framing
    comparisons would never have shown:
    inferno: nchan = MAX_CHANNELS_IN_FLOW.min(tx_channels.len()) -> 8
    ours: nchan = DANTE_TX_CHANNELS -> 48
    nchan on a channel record is the width of a FLOW, not the device's channel
    count. inferno caps it at MAX_CHANNELS_IN_FLOW explicitly. We advertised 48,
    which would have a receiver negotiate a 48-channel flow against a device whose
    flows carry 8. Verified on the wire: now nchan=8.
    Worth noting the A16R advertises nchan=64 and has 64 channels, which is what led
    me t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
    [mdns.c]
2026-07-31 Add the flow-control server on 4455 -- the reason no stream ever started
    You were right: we never made a flow. Our channel records advertise SRV
    <host>:4455 and NOTHING was listening there. A receiver can resolve the channel
    perfectly and still report "cannot find this channel on the network" when the
    flow request goes unanswered. inferno has flows_control_server.rs; we had no
    equivalent, and that is the difference between inferno making a stream and us
    not.
    Request format from flows_control_server.rs, opcode1 = 0x0100:
    0 2 hostname_offset absolute from packet start
    2 4 sample_rate
    6 4 bits_per_sample
    10 2 1
    12 2 num_channels
    14 2 remote_descriptor_offse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
    [dante_flows.c, dante_flows.h, main.c, net.c]
2026-07-31 Fix the capture filter reading IP bytes off non-IP frames
    "No flows" was not a measurement. The capture ring was blind.
    cap_record decided both "is this inbound unicast" and "is this multicast" by
    reading frame[30] -- an IPv4 destination address byte -- WITHOUT ever checking
    the ethertype. On a non-IP frame that offset is arbitrary payload, so it was
    almost always < 224. Every L2 frame therefore passed the inbound-unicast
    catch-all and simultaneously missed the multicast exclusion.
    An AVB device on the bench emits gPTP (0x88f7), MVRP (0x88f5) and MMRP (0x88f6)
    faster than 1 Hz. Classifying the ring by ethertype showed the damage:
    eth 0x88f5 32 <- MVRP
    eth 0x88f7 28 <- gP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
    [cap.c]
2026-07-31 mDNS: emit the FULL service instance name -- the reason nothing could subscribe
    Every _netaudio-chan record we published named a service instance that does not
    exist. That single omission explains "cannot find this channel on the network",
    and it survived this long because the two halves of the code disagreed in a way
    that made each half look correct on its own.
    The query MATCHER built the full name before comparing:
    cat2(full, sizeof(full), inst, "._netaudio-chan._udp.local");
    if (ieq(q, full)) ...
    so an incoming query for "1@Dev._netaudio-chan._udp.local" matched and we
    replied -- and every test that asked us a direct question passed. But EMISSION
    used the bare inst_name() outpu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
    [mdns.c]
2026-07-31 ARC 0x2200: report the 6 multicast TX flows
    With the mDNS names fixed a subscription finally goes green, but Dante
    Controller's Device View "Transmit" tab stayed empty -- the device appeared to
    carry no flow at all while audio was demonstrably on the wire. That tab is
    built from 0x2200, which we still answered with zero flows.
    THE ITEM IS A u16 OFFSET, not an inline struct. That is the part worth writing
    down, because 0x2000 sitting right above it does the opposite: there each page
    slot holds the descriptor itself. Here each slot holds an absolute offset to a
    FlowDescriptorHeader written into the trailing area, and each flow contributes
    four separate blobs -- name string, socket descriptor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
    [dante_arc.c]
2026-07-31 Anchor the media clock to PTP -- the reason a green patch made no audio
    Our audio header carried seconds since BOOT while every other device carries
    seconds since the grandmaster's epoch. Measured off the wire, same capture:
    A16R 239.255.121.190 sec=84625 sub=17232
    ours 239.255.0.66 sec=426 sub=44256
    ~84198 seconds -- 23 hours -- adrift. Nothing else about the stream was wrong:
    tag 0x02, sample index stepping exactly 16, correct group, right rate and
    depth. So a receiver resolved us, subscribed, went green, and then discarded
    every packet as hopelessly stale. That is the whole "green patch, no audio".
    The TSU has held correct absolute time all along -- ptpv1.c steps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
    [dante_arc.c, dante_tx.c, dante_tx.h]
2026-07-31 Apply the timestamp offset in the anchor, not the CSR -- it was wrapping
    Verifying the PTP anchor turned up a second, independent defect that had been
    live the whole time. Capturing a full 3 seconds of one flow instead of a few
    milliseconds:
    sec=85673 subsec=4294967264 <- -32, unsigned, no carry
    step histogram: {16: 8993, -4294967280: 3, 4294967312: 3}
    That is -32 wrapped. The gateware computes the emitted timestamp as
    ts_sub - (fpp-1) and adds the ts_offset CSR to it in a 32-bit UNSIGNED field
    with no carry into seconds, so with DANTE_TX_TS_OFFSET = -32 the sum went
    negative twice a second -- at ts_sub 15 and 31 -- and wrapped to ~4.29e9.
    Two per second per flow, twelve per s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
2026-07-31 Add a UDP stats endpoint, and what it says about the residual jitter
    The UART belongs to the operator's picocom, so every "is it underrunning?"
    question has been answered by asking for a pasted log. Port 7779 now returns
    the counters as big-endian u32s (this libc has no snprintf, so binary rather
    than text), read with tools/stats.py.
    What it shows, with audio playing and a receiver subscribed:
    packets +1620064 / 90 s = 18000.7 pps, exactly 6 flows x 3000
    underrun 285, delta 0 <- startup transient only, NOT ongoing
    overrun 425, delta 0 <- same
    fifo_level 70 hovering around the 64 centre
    enables 2 / disables 1 no talker toggling after s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
    [dstats.c, main.c]
2026-07-31 Switch to unicast: drop b.<bundle>=, and capture what receivers actually ask for
    We were 65.5 Mbit/s of the 69.6 Mbit/s measured on the segment -- 94% of all
    traffic, 65% of a 100 Mbit link -- because we sourced all six multicast bundles
    the moment PTP locked, whether or not anyone had subscribed. An unmanaged
    switch floods every group to every port, so the A16R was filtering 65 Mbit/s in
    hardware while playing two channels. Sending audio nobody requested is not
    free; it was most of the network, and the best remaining explanation for the
    residual audio jitter, since 20 s / 960000 samples of our own transmitted
    payload showed zero glitches and zero timestamp gaps.
    mdns_client.rs takes the mu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
    [dante_flows.c, dante_flows.h, dante_tx.c, mdns.c]
2026-07-31 Record the measured unicast flow spec, and correct the channel slots
    The console log gives what the truncated hex dump could not. My earlier decode
    read the A16R's slots as [1, 0, 0, 0]; they are actually [1, 2, 0, 0]. Both
    receivers want tx channels 1 and 2 -- the A16R simply pads to 4 slots with
    silence, the AM2 asks for exactly 2.
    Also now known: destination port is 14337 for both, and the ~5 s repetition is
    KEEPALIVE traffic, not retrying. flows_control.rs lists 0x0103 as "stream
    expired (i.e. no keepalives)", so a flow must be refreshed or it dies -- which
    means the eventual implementation needs a per-flow expiry timer, not just
    creation.
    UNICAST_FLOWS.md records the full measured spe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
2026-07-31 Gateware: per-flow channel map, slot count and fpp -- unicast flows
    Implements what the two real receivers asked for, with multicast preserved as a
    special case of the same mechanism rather than a separate datapath.
    A unicast flow differs from a bundle in three ways, all chosen by the RECEIVER:
    the destination is its own socket descriptor, the slot map is the channel list
    it named, and fpp is its preference. Measured, both wanting the same two
    channels: A16R 4 slots [1,2,0,0] fpp 8; AM2 2 slots [1,2] fpp 16. All three
    vary per flow and all three change the packet.
    THE RING DID NOT NEED RESTRUCTURING. The plan's Phase 5(c) proposed
    re-addressing the rings channel-major, but the existing lay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
2026-07-31 Fix the disabled-flow skip: Migen took the last assignment, not the first
    The unicast path binds and answers correctly on hardware, but overrun_count ran
    to 39 million in ~75 s. Cause is in this file, not the ring accounting.
    The skip was written as If(flow_off, ...) at the TOP of the BUILD state. That
    does not work in Migen: the last assignment to a signal in a state wins, so the
    unconditional NextValue(byte_idx, byte_idx + 1) and NextState("PREFETCH") at
    the BOTTOM of BUILD both overrode it. A disabled context therefore still built
    a packet -- and with nslots = 0 the geometry collapses to f_total = 51, so it
    emitted a 51-byte header-only frame for every unconfigured context, every tick.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
    [dante_tx.c]
2026-07-31 Flow timeout 16 s -> 45 s: expiry was firing between keepalives
    Hardware log shows both flows binding correctly with the right slot maps --
    A16R 4 slots [1,2,0,0] fpp 8 into context 0, AM2 2 slots [1,2] fpp 16 into
    context 1 -- so the unicast path itself works. But every refresh was preceded
    by "flow N expired (no keepalive)", i.e. the flow was torn down and rebuilt on
    each keepalive instead of simply being refreshed.
    Tearing down writes nslots = 0, which disables the context until the next
    request arrives. That gap would be audible, so this is not cosmetic.
    Keepalives measure ~5-6 s apart in the capture, which 16 s should have covered;
    something is stretching the observed gap past it. Rat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
    [dante_tx.c]
2026-07-31 Add the per-flow due gating, and stop PTP steps expiring flows
    Two fixes, both for things the console log exposed.
    1. DUE GATING -- the piece I described but did not write.
    Pacing runs at the finest fpp (8), so a flow with fpp=8 is due on every tick
    and one with fpp=16 only on the tick where ts_sub[0:4] == 15. Given the tick
    fires at ts_sub[0:3] == 7, that is exactly ts_sub[3] == 1.
    Without it every enabled flow emitted on EVERY tick: the AM2's fpp=16 flow
    transmitted at 6000 pps instead of 3000, in overlapping 16-sample windows. The
    commit that introduced per-flow fpp claimed this gating existed; it did not.
    Measured 6913 pps against an expected 9000 is what gave it away.
    tick_hi is lat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
    [dante_tx.c]
2026-07-31 Flow timeout 5 min, derived active count -- unicast now runs at exactly 9001 pps
    Verified on hardware over 20 s with both receivers subscribed:
    packets +180021 / 20 s = 9001 pps
    = 6000 (A16R, fpp 8) + 3000 (AM2, fpp 16)
    underrun delta 0
    overrun delta 0
    fifo_level 62, centre 64, stable
    flows_active 2, rebinds 1 and 1 -- bound once, never torn down
    That rate is the proof the due gating is right: two flows of DIFFERENT fpp
    emitting at their own correct rates from one shared read pointer. Before the
    gating it was 6913 pps with the ring running away at 17.5 million overruns per
    20 s.
    Two fixes to get there:
    - FLOW_TIMEOUT_MS 45 s -> 5 min. O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
    [dante_tx.c, dante_tx.h, dstats.c]
2026-07-31 Fix the mangled first 10-15 s of every stream: ring state at talker enable
    Two causes, both in what happens while the talker is gated OFF. The hold-off is
    now much longer than it used to be -- it waits for PTP lock AND for a receiver
    to request a flow, which can be a minute -- so what was a small startup
    transient became seconds of audible damage.
    1. The USB feedback servo was told the truth, and the truth was useless.
    Nothing drains the ring until `en` goes high, so the real level climbs to the
    full rail during the hold-off. Feeding that to the async-feedback servo tells
    the host to slow down for the entire window, then hands the talker a ring
    pinned at 128 that takes 10-15 s of dropped s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
2026-07-31 Never expire flows on a timer -- the talker was toggling at every stream start
    This is the actual cause of the mangled audio at stream start, and it was not
    the ring. The console shows it directly:
    [ptpv1] LOCKED, offset -720 ns
    [dtx] media clock anchored ...
    [dtx] clock locked -- talker ENABLED
    [dtx] flow 1 expired (no keepalive)
    [dtx] flow 0 expired (no keepalive)
    [dtx] clock unlocked -- talker OFF
    ... rebind ...
    [dtx] clock locked -- talker ENABLED
    The talker goes ENABLED -> OFF -> ENABLED within seconds of every start. Each
    toggle re-anchors the media clock and re-primes the ring, which is exactly what
    a receiver hears as a mangled opening. Multicast nev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
2026-07-31 ARC 0x2200/0x2202: report and delete real flows, not phantom bundles
    The console was repeating "[arc] 2202: refusing delete -- multicast bundles are
    permanent". That comment stopped being true when the unicast rework made bundles
    bind with nslots = 0 and transmit nothing until asked. It was a stale
    justification refusing a request we can now honour trivially, so Dante
    Controller retried forever.
    Two related fixes, both about telling DC the truth:
    0x2200 now lists only contexts that are actually BOUND, with flow_type 0x11
    for unicast and the destination taken from the flow itself. It previously
    listed all six multicast bundles unconditionally -- so after the rework DC
    showed six flo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
    [dante_arc.c, dante_tx.c, dante_tx.h]
2026-07-31 ARC 0x2201: actually start the bundle instead of just confirming it
    The Transmit tab screenshot shows the Add button under "Multicast Transmit
    Flows". That button sends 0x2201, and the handler confirmed a matching request
    without ever binding the bundle -- so Dante Controller would have shown a flow
    that never reached the wire. Exactly the lie 0x2202 was telling in the other
    direction, and worth catching before someone pressed it.
    0x2201 now calls dante_tx_bind_multicast(), which sets the slot map and count on
    an already-bound context. Bundles are pre-bound with nslots = 0 at init, so this
    only flips them on -- and they then appear in 0x2200 as flow_type 2, because
    that reply is now derived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
    [dante_arc.c]
2026-07-31 ARC 0x2201: parse the item list properly and honour any 1..8 channel set
    Trying to add channels 1 and 2 to a multicast flow produced three refusals, and
    each named a different bug of mine:
    [arc] 2201: refusing flow id=32 type=2
    [arc] 2201: refusing flow 1, 0 channels (we emit 8)
    [arc] 2201: refusing flow id=2560 type=0
    1. flow_id 32 is not out of range. It is Dante Controller's HANDLE, chosen from
    the max-flows value WE advertise in 0x1000 (32). I was testing it against our
    six contexts, conflating two numbering spaces. DC's id is now stored per
    context and used for 0x2200 reporting and 0x2202 deletion, so the two stay
    mapped without either side having to know the other's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
    [dante_arc.c, dante_tx.c, dante_tx.h]
2026-07-31 Report the real channel map, and advertise b.<flow>= only for live multicast
    Three things from the bench, two of them my bugs.
    "I added 1 and 2, I see 9 and 10". 0x2200 reported the channel list as
    (ctx * 8 + slot + 1) -- derived from the CONTEXT INDEX, not the flow. A flow
    created for channels 1 and 2 landed in context 1 and was therefore reported as
    channels 9 and 10. The slot map is now stored per flow and reported verbatim.
    Everything else in that reply had already been switched to real data; this line
    was missed.
    "patch 1 or 9, both unicast". Correct, and expected: with b.<flow>= removed
    entirely, mdns_client.rs never sees a bundle key and always falls through to the
    flow-control serv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
    [dante_arc.c, dante_tx.c, dante_tx.h, mdns.c]
2026-07-31 README: bring the status up to date, and record the open bugs
    The README still claimed "Phase 0 of 7 complete" and listed everything from
    Phase 2 onward as planned, while the device has been streaming audio to real
    Dante hardware. Phases 2-5 and 7 are marked done, with what was actually
    measured rather than what was intended.
    Phase 7 landed early because it turned out to be necessary rather than optional:
    multicast bundles sourced all six flows unconditionally, measuring 65.5 Mbit/s
    of 69.6 Mbit/s on the segment -- 94% of all traffic, flooded to every port by an
    unmanaged switch. Unicast made transmission proportional to actual subscriptions.
    New "Open bugs" section, honest about what is b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
2026-07-31 Expose the per-context destination MAC, and what it shows about the 1-receiver bug
    Two flows emitting at exactly the right combined rate while only one receiver
    hears audio pointed at per-context header state. The destination MAC is the one
    field that cannot be checked from the build host -- unicast is forwarded only to
    its destination port -- so the stats endpoint now reports what each context was
    actually bound with.
    What it found is NOT a bad MAC. With the current bench state:
    ctx 0: dst mac 00:1d:c1:a1:72:3c age 146883 ms rebinds 1
    flows_active 1 requests 6 rejected 0
    00:1d:c1 is Audinate's OUI, so that binding is correct. But only ONE context is
    bound, six requests ha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
    [dante_tx.c, dante_tx.h, dstats.c]
2026-07-31 mDNS cache-flush: a stale b.<flow>= key was sending receivers to a dead group
    Root cause of "unicast reaches only one receiver", and it was never a
    transmit-side fault. The evidence had already ruled that out -- 9001 pps, both
    contexts emitting at their own correct rates -- and the decisive observation was
    that flows_requests stopped increasing: no second receiver was ASKING.
    Channel 1 was still advertising b.32=1, from a multicast flow created earlier
    and since gone. Receivers follow a b.<flow>= key to the multicast group instead
    of contacting the flow-control server, so they joined a group nothing transmits
    to, sent no flow request, and played nothing.
    The key is dynamic now -- it appear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
    [mdns.c]
2026-07-31 Confirm the two-receiver fix on hardware
    ctx 0: 00:1d:c1:a1:72:3c age 192s rebinds 1
    ctx 1: 00:1d:c1:2d:4a:18 age 188s rebinds 1
    flows_active 2 requests 15 rejected 0
    9015 pps, underrun +0, overrun +0, fifo 67
    Both MACs are Audinate OUIs and distinct -- 2d4a18 matches the A16R's hostname
    RN-A16R2-2d4a18 -- so these are genuinely two different receivers on separate
    contexts, not one device counted twice. No rebind churn, no counter movement.
    The stale b.<flow>= key was the whole fault. Worth remembering the shape of it:
    every instrument said the transmit path was correct, and it was. The failure was
    that receivers never asked, because cached discovery data pointed th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
2026-07-31 README: USB verified on the current gateware, 2 channels
    Enumerates as "N-Series USB 48CH" and 2 channels confirmed working after the
    unicast gateware work, which is the check the plan asks for at every gateware
    change.
    Recorded as PARTLY retested rather than done: all 48 channels have not been
    exercised on this bitstream. That distinction matters here specifically, because
    the historical failure in this lineage was 48-channel-specific -- one dropped
    sample permanently rotated every channel, fixed by the channel-addressed ingress
    and its explicit channel_nr/first marker. A 2-channel pass cannot detect it.
2026-07-31 Model name -> "N-Series USB 48"
    Dante Controller's Device Info showed Model Name "InfernoFPGA 48ch". Changed to
    "N-Series USB 48", with the short 8-byte model code following it (InfrnFPG ->
    NSerUSB) so the two do not disagree.
    The field at 0xac is FIXED WIDTH 16 bytes, not NUL-terminated-and-packed.
    "N-Series USB 48" is 15 characters and fits; "N-Series USB 48CH" is 17 and would
    have silently truncated to "N-Series USB 48C". That is why the name is 48 rather
    than 48CH.
    Also switched the info-request reply to put_fixed for the same two names. It was
    writing them with raw memcpy of the STRING length rather than the FIELD width,
    so it left whatever preceded it in the tail bytes instead of zer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
    [dante_info.c]
2026-07-31 Product version -> 0.1.0 (render inferred, not confirmed)
    The Product Version column was blank for us while other devices showed values.
    The field is 4 bytes at 0x1c and previously held 00 00 00 01.
    Set to 00 00 01 00. The render is INFERRED rather than measured: DVS shows
    4.5.1.1 (four components) and the AM2 shows 0.0.1 (three), which fits Dante
    Controller dropping a leading zero byte -- so 00 00 01 00 should read "0.1.0".
    I could not confirm it the way the rest of this layout was confirmed. Neither
    the A16R nor the AM2 answers a synthetic 0x00c1 query from this host (they
    presumably require a matching device id), so there was no way to compare a
    device's bytes against what DC displays f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
2026-08-01 Expose media-clock vs PTP drift, and identify the overnight no-audio mechanism
    Overnight the device kept every counter healthy -- talker on, PTP locked, two
    flows bound, 9019 pps, zero underrun and overrun, fifo at centre, keepalives
    current -- and produced no audio. Same signature as the epoch bug: perfectly
    formed packets a receiver silently discards.
    The mechanism is the media clock. It free-runs from a SINGLE anchor taken when
    the talker is enabled, and dante_tx_poll only re-anchors when emitted seconds
    differ from PTP seconds by more than ONE SECOND. Measured drift between the two
    clocks is 3.6 ppm, which is 13 ms per hour and about 100 ms overnight -- two
    orders of magnitude past a re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
    [dstats.c]
2026-08-01 Wait for PTP to settle before anchoring the media clock
    The console pinned this exactly:
    [ptpv1] LOCKED, offset -29 ns
    [dtx] media clock anchored ... / talker ENABLED <- audio starts BAD
    [ptpv1] unlocked, offset -21406 ns
    [ptpv1] LOCKED, offset 1138 ns
    [ptpv1] path delay 21250 ns, phase corrected -1175 ns
    <- ~1 s later, clean
    The first lock edge is not trustworthy. PTP locks, drops out, relocks, and only
    afterwards measures its path delay and applies a phase correction. The talker
    was enabled on that first edge, so the media clock -- which free-runs from a
    single anchor -- kept whatever error the clock hap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
    [dante_tx.c]
2026-08-01 Media clock rate servo: null the 3.6-4.3 ppm that was killing streams overnight
    CONFIRMED the diagnosis before writing the fix. Measured on a board up ~1.4
    hours:
    drift +941 samples (19.60 ms)
    +120s +966 samples (20.12 ms)
    rate +4.34 ppm -> +15.6 ms/hour
    19.6 ms is already ~20x a receiver's ~1 ms buffer, so audio was long dead while
    talker, PTP lock, flow bindings, packet rate, underrun, overrun and fifo level
    all read perfectly healthy. Overnight this reaches ~100 ms.
    The media clock IS disciplined by the gPTP addend ratio, but with a deadband
    (~1.2 ppm) and NCO quantisation (~0.6 ppm/unit) it leaves several ppm residual,
    and the media clock free-runs from a single ancho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
    [dante_tx.c, dante_tx.h, dstats.c, mcr.c, mcr.h, net.c]
2026-08-01 Revert the media clock rate servo -- it made the failure worse, not better
    The diagnosis holds and is confirmed by measurement: +4.34 ppm, +15.6 ms/hour,
    19.6 ms accumulated in 1.4 hours, which is ~20x a receiver's buffer. The FIX
    does not.
    Two failures, both worth recording:
    1. The trim was applied only after the early return in mcr_compute_gptp_base(),
    which tests g->servo_locked -- the 802.1AS servo flag, on a device that runs
    PTPv1. That early return is the live path, so the trim never reached the NCO.
    Measured proof: +4.83 ppm after, against +4.34 ppm before. No effect at all.
    I should have verified the trim reached the hardware before trusting the loop
    around it.
    2. A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
    [dante_tx.c, mcr.c]
2026-08-01 Fix the media clock drift: mcr was reading the wrong servo entirely
    before +4.34 ppm +15.6 ms/hour (~100 ms overnight)
    after +0.17 ppm +0.61 ms/hour
    25x better, against a receiver buffer of ~1 ms. This is the overnight
    no-audio bug.
    Not a mistuned servo -- an UNCONNECTED one. mcr_compute_gptp_base() derived the
    media clock rate from m->gptp->current_addend_full / base_addend_full, gated on
    g->servo_locked. That flag is set only by gptp_servo_update(), the 802.1AS
    servo. This device runs PTPv1, which maintains its own addend state in g_ptpv1
    and writes NOTHING to the gPTP struct -- confirmed: grep for g_gptp in ptpv1.c
    returns nothing. So the gate was never true, the func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
    [mcr.c]
2026-08-01 Three improvements: bind checking, flow handles, PTPv1 warm start
    1. CHECK EVERY net_udp_bind RETURN. Eight of nine call sites ignored it --
    ARC 4440, mDNS 5353, PTP 319/320, CMC 8800, info 8700, cap, probe. Only the
    two ports added most recently checked. That table has silently overflowed
    TWICE this session, each time presenting as "one port is dead, everything
    else fine"; had it taken mDNS or ARC instead, the device would have vanished
    from Dante Controller with no error anywhere. Every site now says so.
    2. RETURN A FLOW HANDLE. We answered flow requests OK with EMPTY content;
    inferno returns a 6-byte handle -- flow index as u32 BE then a u16 cookie
    (flows_tx.rs:631-6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
    [cap.c, config.h, dante_arc.c, dante_cmc.c, dante_flows.c, dante_info.c, mdns.c, ptpv1.c]
2026-08-01 Revert the media clock discipline: it fixed the drift and broke the audio
    You heard it before the counters showed it. underrun_count went from ~130 total
    to 40547 in four minutes -- about 170/s sustained -- and the packetizer emits
    silence on an underrun, so the audible result was worse than the drift it cured.
    Measured both ways, honestly:
    drift 4.34 ppm -> 0.17 ppm 25x better
    underrun ~130 -> 40547 / 4 min
    and fifo_level read centre (65-66) throughout, which I cannot explain: a ring
    starving at 170/s should not report mid-scale. Rather than leave a guess running
    on the bench, this is back to the gPTP source -- which under PTPv1 means the
    media clock is undiscipline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
    [mcr.c, ptpv1.c, ptpv1.h]
2026-08-01 Design for replacing mcr, and why the operator's AVB-leftover instinct is right
    Not the rewrite -- the design for it, written while the evidence is fresh and
    before guessing again. Three clock failures this session all centre on mcr, and
    the operator identified the cause before I did: it is AVB media-clock-recovery
    machinery running on a device with no CRF.
    mcr carries CRF stream binding, a CRF-loss watchdog that snaps the increment
    back to base, its own servo_locked state machine, and a secondary gPTP path
    gated on gptp_t.servo_locked -- a flag only the 802.1AS servo sets. Under PTPv1
    none of that can fire, so the media clock free-runs at the crystal rate.
    MCR_REPLACEMENT.md records the m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
2026-08-01 Correct the statime reference: inferno-dev is the PTPv1 branch, and it matters
    I dismissed statime as "PTPv2, nothing to copy". Wrong -- origin/inferno-dev is
    the PTPv1 fork, and statime/src/overlay_clock.rs is directly applicable.
    pub struct ClockOverlay { last_sync, shift, freq_scale }
    pub trait ClockOverlayExporter { fn export(&mut self, &ClockOverlay); }
    Two things worth taking:
    1. Rate and phase are SEPARATE explicit state. freq_scale is the standing rate
    correction, shift is phase. Our servo conflates both inside one addend, which
    is why "follow the integral" and "follow the full addend" each went wrong in
    a different way -- neither is cleanly one or the other.
    2.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
2026-08-01 EXPERIMENT: log every NCO increment write, with caller and delta
    Temporary instrumentation to settle the one observation nothing explains:
    underrun climbing while fifo_level reads centre.
    mcr_increment_write() has three call sites (mcr.c:53, 388, 442) computing values
    independently. If two disagree the NCO alternates between rates, which starves
    a ring whose AVERAGE level still looks correct. statime's overlay clock makes
    the opposite choice -- one owner, one export point -- which is what prompted
    looking here.
    inc_write_dbg() logs only on CHANGE, so a steady clock prints nothing and an
    oscillating one prints a visible ping-pong between two values, with the site
    number and the delta in ppb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
    [mcr.c]
2026-08-01 PTP stability: unlock hysteresis and outlier rejection
    The console log identified the real fault, and it was neither drift nor
    underruns. PTP was cycling continuously:
    LOCKED, offset -503 ns -> talker ENABLED
    unlocked, offset +5298 ns -> talker OFF
    LOCKED, offset -379 ns -> talker ENABLED
    unlocked, offset +6201 ns -> talker OFF
    ... +7271, +8845, -6072, +10625, -5981, -10676 ...
    Sub-microsecond steady state, then a single sample 10x past the 5 us unlock
    threshold. Every unlock stops the talker; every relock RE-ANCHORS the media
    clock. The stream was being torn down and restarted every few tens of seconds.
    That explains the bad stream starts, the audio disap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
    [mcr.c, ptpv1.c]
2026-08-01 Design: streaming telemetry and a PTP servo worth trusting
    The operator's point, and it is correct: build a way to read the FPGA directly
    instead of diagnosing through snapshots and pasted terminal scrollback.
    Three wrong conclusions this session all trace to that gap -- underruns blamed
    on a code change that was not causing them, 16506 pps read off stale hand-indexed
    offsets when the rate was 9014, and a "25x drift improvement" credited to a
    mechanism the [inc] experiment later proved never ran. PTP cycling lock/unlock
    every ~30 s went unnoticed for hours because nothing reported transitions.
    TELEMETRY_AND_PTP.md specifies a streaming telemetry channel (per-Sync records
    with t1..t4, raw a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
2026-08-03 rx_gate + mcr_dante: stop losing RX frames, and discipline the media clock
    Two faults from the same investigation, both measured on hardware by toggling
    them at runtime rather than compared across builds.
    ## rx_gate — hardware RX MAC allow-list (plan risk 8)
    The unmanaged bench switch floods other devices' Dante audio at us. With only
    2 RX slots (nrxslots cannot be raised) the writer's status FIFO backs up and
    frames are lost -- including PTPv1 FollowUp/DelayResp, which mispair with the
    wrong Sync and inject +/-5-10 us offset errors.
    Measured A/B, one bitstream, filter toggled at runtime:
    unicast round-trips lost 84/400 (21.0%) off -> 0/400 (0.00%) armed
    writer_errors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
    [dstats.c, main.c, mcr_dante.c, mcr_dante.h, rx_gate.c, rx_gate.h]
2026-08-03 README: point at the terminal Dante controller
    dantectl moved out to its own repository. It is the bench tool that reads
    this device's control plane, PTP state and subscriptions without Dante
    Controller, and its README carries the measurement showing this firmware
    drops ARC requests arriving in a burst with info queries -- 0 of 12
    answered, against 12 of 12 on a RedNet A16R under identical load.
2026-08-04 media clock: correct PHASE, not just rate — fixes total audio loss
    Follow-up to 6bf0bff. That commit disciplined the media-clock RATE and
    validated it with audio: drift +3.61 -> +0.39 ppm, ring level unchanged, zero
    underruns. It was half a fix, and the missing half stopped audio completely.
    ## Symptom
    No audio at any receiver. Dante Controller showed the patch FULLY GREEN, and
    re-patching changed nothing. Every counter on the board read healthy:
    talker 1, 9001 pps, ring centred 55..73, underrun 0/s,
    overrun 0, PTP locked, rx_gate armed and clean
    ## Cause
    emitted 402927.04519 PTP 402926.41611 = +10908 samples = +227 ms AHEAD
    DANTE_TX_TS_OFFSET is +74 samples (1.5 ms).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
    [dante_tx.c, dante_tx.h, mcr_dante.c]
2026-08-04 unicast flows: key on the destination socket, not the peer IP
    One receiver could only ever hold ONE flow, so every device was capped at a
    single flow's worth of channels.
    dante_tx_bind_unicast() reused an existing context by matching the PEER IP
    alone. A second flow request from the same device therefore found the first
    context and overwrote it. Nothing was rejected, because nothing was refused --
    the flow was silently replaced.
    Observed with a RedNet A16R (16 ch) and a RedNet AM2 (2 ch) subscribed:
    flows_active 2 flows_requests 205 flows_rejected 0
    Two contexts bound while both devices were asking for more. Four of the five
    contexts now in use belong to the A16R alone, which had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
    [dante_tx.c]
2026-08-04 media clock: disable the phase term by default -- it caused clock artifacts
    Bisected on the bench 2026-08-04. With the media-clock discipline off, audio
    went clean immediately and 16 channels to a RedNet A16R played correctly. With
    it on, the operator heard clock problems.
    The phase term added in b4bca3f was pure-proportional with a deadband, and its
    output fed the rate SLEW LIMITER -- i.e. the lag sat inside the loop. That is a
    textbook limit cycle. Observed on the bench: phase hunting -27 -> +216 samples
    (a 5 ms excursion against a +74 target) while modulating the media clock rate
    by roughly +/-0.5 ppm on a slow period. Receivers locking to those timestamps
    report exactly that as a clock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
    [dstats.c, mcr_dante.c, mcr_dante.h]
2026-08-04 telemetry: stream both error axes and state transitions, not snapshots
    TELEMETRY_AND_PTP.md item 2. The case for it was made three times over in this
    project, each costing a bench session:
    * the media clock sat 227 ms in the future for two days while every counter
    read healthy and no audio played -- nothing measured PHASE;
    * a phase servo hunted +/-0.5 ppm in a limit cycle, visible only as `drift`
    "wandering" between reads minutes apart;
    * two wrong diagnoses in one evening, both inferred through 0.5 Hz samples of
    already-median-filtered values.
    firmware/telem.[ch]: 96-entry ring of 28-byte records pushed ON EVENT, drained
    over UDP 7779 opcode 't'. Separate opcode with it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
    [dante_tx.c, dstats.c, main.c, mcr_dante.c, ptpv1.c, telem.c, telem.h]
2026-08-04 servo: measured the requested changes, and reverted them
    Asked to remove the median filter and retune KI. Did both, measured both with
    the new telemetry, and neither survived contact with the data. Code is back to
    median 7 / KI 900; this commit is the experiment record.
    Seven 190 s captures, one variable at a time:
    A median7 KI900 (orig) sd 79 ns p2p 293 mean 649 ns rate sd 0.0
    B median1 KI900 sd 171 p2p 1148 mean 1014 rate sd 19.5
    C median1 KI3600 sd 414 p2p 2753 mean 26 rate sd 43.9
    D median7 KI3600 sd 327 p2p 2039 mean 105 rate sd 56.6
    E exact integral KI900 sd 369 p2p 1638 mean 85 rate sd 2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
2026-08-04 servo: 5-run interleaved matrix; adopt exact integral accumulation
    Redone properly after the single-capture table proved to be noise. 5 variants x
    5 rounds, round-robin, switched at RUNTIME via a new 's' opcode so no variant
    needed a reflash -- a reflash reboots the board, which re-locks PTP, re-anchors
    the media clock and restarts the talker, injecting exactly the transients the
    comparison is trying to measure. 25 captures, 140 s each, zero reboots.
    variant off sd |mean| standing rate sd
    A med7 ki900 108 [46..203] 187 [120..535] 0.0 [0.0..0.0]
    B med1 ki900 53 [39..124] 318 [9..764] 0.0 [0.0..0.0]
    C med1 ki3600 59 [46..157]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
    [dstats.c, ptpv1.c, ptpv1.h]
2026-08-04 boot: warm-start the media clock, gate the talker on it, fix the trip guard
    Addresses the reported startup sequence: long silence, then a while of bad
    audio, then clean. Three separate causes, all at boot.
    ## What the references do
    statime (origin/inferno-dev, Apache-2.0/MIT -- safe to reference):
    filters/kalman.rs defaults are explicit about step-vs-steer --
    step_threshold 1 ms above this, re-acquire (step) rather than steer
    steer_time 2 s below it, null the error over 2 s
    max_steer 200 ppm bounded frequency excursion while steering
    and absorb_frequency_steer() adds the applied steer back into the filter's
    own frequency state so it is not counted twice. Th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
    [config.h, dante_tx.c, mcr_dante.c, mcr_dante.h]
2026-08-04 boot: arm rx_gate automatically -- it was the cause of slow lock and bad start
    The reported symptoms -- long silence at boot, then bad audio, slow green Sync
    in Dante Controller -- traced to rx_gate coming up DISABLED after every reboot.
    rx_gate's enable CSR resets to 0 and firmware left it that way, so every reflash
    and every power cycle put 21% control-plane frame loss back on the PTP path.
    PTP then measured through that loss: offset noise 3-7 us, path delay 20 us,
    lock taking minutes or never arriving, and the talker never starting because it
    gates on lock. Arming it by hand recovered lock in ~12 s and pulled path delay
    20427 -> 15034 ns and offset 6632 -> 2573 ns within a minute.
    That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
    [dante_tx.c, ptpv1.c, ptpv1.h, rx_gate.c]
2026-08-04 ptpv1: seed the exact integral accumulator -- lock 144 s -> 18 s
    Regression from 784d43d, which made exact integral accumulation the default.
    With rt_exact_integ the real servo state is freq_integral_num; freq_integral is
    DERIVED from it every update. Two sites still wrote only the derived value:
    ptpv1.c:418 freq_integral = applied - err_ppb; (frequency ACQUISITION)
    ptpv1.c:931 freq_integral = ((warm - base) * 1e9)/base; (NV WARM START)
    So the next Sync computed `freq_integral_num += ...` starting from ZERO and
    then `freq_integral = freq_integral_num / SERVO_KI_DEN` ~= 0, discarding both
    the acquired frequency and the warm start. The servo then re-integrated the
    entire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
2026-08-04 ptpv1: step above 1 ms, not 500 ms -- closes the dead band that stalled lock
    Lock had become intermittent: 18 s, 18 s, then a boot that never locked at all
    in 180 s. Caught the failing state directly -- offset sat at -115969016 ns
    (-116 ms) with the servo unable to move it.
    SERVO_STEP_NS was 500 ms, which left a huge dead band. An offset between the
    ~2 us lock threshold and 500 ms is too large to steer down in any sensible time
    and too small to trip a step, so the servo crawled and lock never arrived. The
    absolute step normally saves the cold-boot case (TSU starts at 0, offset is
    hundreds of thousands of seconds), which is why this only showed up sometimes --
    whenever a boot happened to lan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
    [dante_tx.c, dante_tx.h, dstats.c, ptpv1.c]
2026-08-04 media clock: fix a 1-second read race that was stepping the clock; add wire decoder
    ## The bug the operator's console log caught
    [dtx] media clock phase -48079 samples (-1001 ms) off -- re-anchoring
    -48079 samples is ONE SECOND, near exactly (subtract the +74 the check removes
    and it is -48005). That cannot be drift: rate discipline holds ~1.9 ms/hour, so
    the 44 minutes since the previous anchor should accumulate ~1.4 ms, not 1000 ms.
    A clean one-second error means a seconds FIELD.
    dbg_last_sec and dbg_last_ts are two separate CSR reads, and the gateware
    re-latches that pair on every emitted packet (3000-6000/s). A read that
    straddles a seconds boundary returns sec_old with sub_new --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
    [dante_tx.c, dante_tx.h, mcr_dante.c]
2026-08-05 media clock: phase loop is AUDIBLE -- ship rate-only, keep the loop off
    The operator's ear settled what four measurement rounds could not: with rate
    discipline on and the phase loop OFF, audio is good. With the phase loop on it
    is not. Every counter said the loop was healthy -- ring 57..68, underrun 0/s,
    trips 0, drift converging toward target -- and it still sounded wrong.
    ## Why, and why the AVB mcr sounded better
    The operator's observation was the key: "it was good with avb mcr, only not at
    start stream". MCR_REPLACEMENT.md measured what that mcr actually did under
    Dante -- the gPTP gate was never true, so it free-ran at +4.34 ppm, completely
    undisciplined. It sounded good BECAUSE it wa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
    [mcr_dante.c]
2026-08-05 RETRACT: the fpp=16 timestamp bug does not exist
    643a6a6 recorded as a real unfixed bug that fpp=16 flows are stamped 8 samples
    (167 us) late relative to their own audio, and that an fpp=16 device therefore
    renders 167 us apart from an fpp=8 one. That is wrong.
    The claim came from reading `ts_sub_emit` being latched once per block and
    shared by all flows, plus the read base `rd - Mux(fpp16, 64, 0)` (64 ring
    entries = 8 sample-times), and concluding the two disagreed. It missed:
    f_ts_sub.eq(ts_sub_emit - (cur_fpp - 1))
    which already compensates: fpp=8 subtracts 7, fpp=16 subtracts 15 -- exactly the
    8 sample-times the read base moves. So fpp=8 reads [tick-7, tick] and stamps
    tick-7; fpp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
2026-08-05 latency: fix the timestamp placement that was silencing receivers
    Root cause: DANTE_TX_REANCHOR_SAMPLES was 240 samples (5 ms) -- WIDER THAN THE
    THING IT PROTECTS. A Dante receiver at 1 ms discards anything outside 48
    samples, so a guard tolerating 240 permits a violation five times over and
    reports nothing. The boot anchor landed 116 samples (2.4 ms) out, the guard
    watched it sit there, and both a RedNet A16R and an AM2 reported 127-130 samples
    of actual latency against 1 ms settings -- audible failure with every
    transmit-side counter green.
    That value was chosen as a backstop BEHIND mcr_dante.c's phase term ("this only
    catches a PTP step or phase accumulated while the talker was idle"). T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
    [dante_arc.c, dante_info.c, dante_tx.c, dante_tx.h, dstats.c, mcr_dante.c, mdns.c]
2026-08-05 dante: advertise multicast bundles, and stop inventing protocol constants
    mdns_announce() was called from exactly ONE place -- at init. Bundles are
    created later, by ARC 0x2201, so every announcement carried an empty
    _netaudio-bund set and nothing ever told the network a bundle had appeared. The
    responder could always ANSWER a bundle query (match_bund_inst, W_BUND_PTR,
    W_BUND_ONE were all correct); nobody knew to ask. Bind and unbind now
    re-announce, and our record is byte-identical to a RedNet A16R's:
    A16R id=32 nchan=2 latency_ns=1000000 fpp=16 rate=48000 enc=24 at2
    a.0=239.255.121.190 p.0=4321 SRV 4321
    us ... a.0=239.255.0.71 p.0=4321 SRV 4321
    Note the SRV port i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
    [dante_info.c, dante_tx.c, mdns.c]
2026-08-05 sim: prove arbitrary-fpp pacing, and record why the gateware change stalls
    DVS asks for fpp=60 -- measured on the console, 124 requests, invariant across
    every latency setting it offers (4/6/10 ms). We accept only 8 and 16, so DVS
    cannot subscribe at all, and an A16R at 5 ms (fpp=32) cannot either. The 0.25 ms
    goal needs fpp 2-4 and hits the same wall.
    The sim proves the replacement pacing scheme:
    * per-context phase counter 0..fpp-1, emitting on the last count
    * correct spacing and `emitted % fpp == 0` for 2,4,8,16,24,32,48,60,64
    * alignment SURVIVES the ts_sub wrap at 48000 -- the case the old
    power-of-two mask got for free
    * fpp=36, a NON-divisor of 48000, genuinely misalign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
2026-08-05 sim: sample-granular ring read pointer is smoother, but fpp=60 needs a deeper ring
    Prerequisite for arbitrary fpp, run before touching the packetizer because
    getting it wrong is audible.
    Arbitrary fpp needs rd to advance +8 per MEDIA STROBE rather than +64 per
    8-sample block traversal, because 60 is not a multiple of 8 and no per-context
    offset positions a 60-sample window from an 8-sample-granular pointer. The risk
    was that `level` (= wr - rd) changes shape, since level is the USB feedback
    servo's input and that servo took a long time to stabilise.
    Measured, open loop, 20000 sample-times:
    ripple p-p with a jittery writer
    block rd 56 57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
2026-08-05 WIP: arbitrary fpp -- DVS subscribes at fpp=60, but pacing rate is wrong
    DOES NOT WORK. On a branch so a build from the main line does not pick it up.
    WHAT WORKS: Dante Virtual Soundcard now subscribes. It asks for fpp=60 and
    nothing else, at every latency setting it offers, and was rejected outright
    before. All six contexts bound to it at fpp=60 on the first try.
    WHAT IS BROKEN, measured on hardware:
    packets 1335 pps observed against ~7000 expected
    (5 flows x fpp60 = 4000, + 1 x fpp16 = 3000)
    overrun 1148/s
    anchors 106/s -- the phase guard re-anchoring on every poll
    phase err 34..56 samples, growing between polls 4.7 ms apart
    The rate being ~1/5 of expected say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
    [dante_flows.c, dante_tx.c, dante_tx.h]
2026-08-05 WIP: seed sweep, per-context counters -- pacing still broken, counters unreliable
    Still on the WIP branch. DOES NOT WORK.
    SEED SELECTION WAS A REAL MISTAKE, independent of the code. tools/seed_sweep.sh
    says plainly that a seed may "meet every global Fmax and still produce a broken
    USB datapath, because the seed shuffles the intra-region USB placement and
    global Fmax does NOT predict USB quality", and that a re-sweep is required after
    ANY gateware change. Three builds were made on --seed 8 across three different
    netlists. Build 2 (sys 61.43, usb 89.61, every clock passing) had dead USB --
    textbook failure mode (c). usb_clk, one of four documented pass criteria, was
    never checked at all until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
    [dante_tx.c, dstats.c]
2026-08-05 fpp: latch each context's due until the builder serves it
    THE ACTUAL BUG, found by measurement rather than inspection.
    due_arr[i] is a ONE-STROBE pulse -- high only on the sample where context i
    completes its fpp group. The builder walks contexts one at a time and reaches
    context i many cycles later, by which point the phase counter has moved on and
    the pulse is gone, so the packet is never built.
    The old design did not have this problem because it gated on tick_hi, which its
    own comment describes as "stable for the whole block because tick_hi is latched
    at send_req". Replacing that with a live comparison removed the latch without
    replacing it.
    Measured on hardware with the new per-contex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
    [dstats.c]
2026-08-06 fpp: remove the diagnostic counters -- the bench needs sys >= 60 MHz
    The operator's observation: sys below 60 MHz shows up as a starved FIFO, RX
    looking flooded and a sluggish console -- the CPU cannot keep up. 55 MHz is
    seed_sweep.sh's BUILD-REJECT floor, not a good-audio floor, and bench experience
    beats my reading of that comment.
    The per-context due/emit counters cost about 4 MHz: seed 4 measured 61.53 MHz
    before they were added and 52-58 MHz across two full sweeps afterwards. They
    earned their place -- due 800.1/s against 48000/60 = 800.0 proved the pacing was
    exact and redirected four rounds of wrong suspicion onto the builder, which is
    where the two real bugs were -- but a diagnostic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
    [dstats.c]
2026-08-06 usb: keep the ring inside the servo's integration band; model the loop
    The bench ring oscillated 8..67 against a centre of 64 with ~1400 underrun/s
    while the feedback servo sat at its neutral value. Root cause, from the servo
    source (usb_avb_subsystem.py:420-460, Amaranth, outside this repo):
    fb = (nco_rate << 8) + (err << 6) + (integ >> 6) err = 64 - block_level
    integ accumulates ONLY while -32 <= err <= 32 (anti-windup band)
    The prime hysteresis spans block_level 8..64, i.e. err 0..56. Over most of that
    swing |err| > 32 and the INTEGRATOR IS FROZEN -- exactly when it is needed --
    so the loop never accumulates authority and the host under-delivers ~1.8%.
    That band was s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
2026-08-06 fpp: borrow into seconds when the emitted timestamp crosses the subsec wrap
    FOUND ON THE WIRE, not by inspection. tools/dante_decode.py on our multicast:
    169.254.9.200 -> 239.255.0.68
    step histogram: 16x1998, 4294967312x1, -4294967280x1
    ts multiple of fpp: NO
    continuity gaps(backwards)=1
    audio 63904 non-zero samples, peak -7 dBFS
    Those two steps are +/-2^32. The emitted timestamp is ts_sub_emit - (fpp-1),
    the START of the window the packet covers. With fpp fixed at 8 or 16 the old
    pacing guaranteed ts_sub was congruent to 15 mod 16 at the tick, so the
    subtraction could never go negative. With ARBITRARY fpp the tick fires wherever
    the per-context phase counter sa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
2026-08-06 fpp: fix timestamp alignment; correct the servo model's underrun metric
    THREE timestamp defects fixed, all found by decoding our own multicast rather
    than by reasoning:
    1. BORROW INTO SECONDS (previous commit) -- emitted = ts_sub - (fpp-1) went
    negative once per second with arbitrary fpp and wrapped to ~4.29e9 with the
    seconds untouched. Dante Virtual Soundcard went GREEN on multicast the moment
    this landed, having rejected the stream as "no audio data" before.
    2. ts_anchor() MOVED ts_sub AND LEFT THE PHASE COUNTERS BEHIND. The per-context
    counter must track ts_sub % fpp; seeding it once at bind is not enough when a
    re-anchor then jumps ts_sub. Every bound context was left p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
    [dante_tx.c]
2026-08-06 sim: fix the servo model's base -- the loop is stable, the HOST under-delivers
    The model computed fb = (nco_rate << 8) with nco_rate set to 6. nco_rate is the
    strobe COUNT over 256 SOFs -- 6*256 = 1536 -- which is why the design shifts it
    by 8 to make the Q16.16 base: (6*256)<<8 == 6<<16. With 6 the base was 256x too
    small, so the modelled ring drained in EVERY scenario regardless of host
    behaviour, and a threshold decision was made on that.
    The scaling assertion did not catch it because it checked the authority against
    a separately computed NOMINAL_SOF*Q and never touched the broken path. An
    assertion that does not exercise the code under test is not an assertion.
    Corrected, the conclusio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
2026-08-06 usb: feedback sweep -- the host obeys, our auto loop reports ~3.5% low
    Adds UDP opcode 'F' to hold the async-feedback value (the console 'F' command
    exists but driving the UART perturbs the system being measured).
    FIRST SWEEP WAS INVALID and the result was nearly believed. Writing
    main_usb_fb_ovr directly does nothing: the main loop pushes usb_fb_manual into
    that CSR unconditionally every iteration, so the value was overwritten within a
    millisecond. It read back as 0 while the sweep showed no response, which looks
    exactly like "the host ignores feedback". The opcode now sets usb_fb_manual.
    With the override actually reaching the hardware:
    vs nominal ring avg max underrun/s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
2026-08-06 usb: firmware outer feedback loop -- underruns 2100/s -> ~200/s
    The wrapper's integrator is clamped to +/-2.08% (INTEG_MAX = 0x2000 <<
    KI_SHIFT). The UDP feedback sweep showed the ring needs about +3.5% to stop
    underrunning:
    +2.0% underrun 916/s +3.0% 379/s +4.0% 0/s (ring pinned full)
    so the hardware integrator SATURATES ~1.4% short and can never close the gap,
    however long it runs. That is why the ring limit-cycled between the prime
    thresholds and ~2% of samples went out as silence, and it is not something the
    un-prime threshold or rd granularity could ever have fixed.
    fb_ovr != 0 bypasses the hardware loop, so firmware can own it and supply the
    authority the clamp denies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
    [dstats.c, main.c]
2026-08-06 usb+mdns: target the underrun/overrun balance; advertise a truthful latency_ns
    TWO fixes, and one of them corrects a loop I got wrong in the previous commit.
    1. THE FIRMWARE FEEDBACK LOOP TARGETED AN UNREACHABLE SETPOINT. It integrated on
    (64 - block_level), but the prime hysteresis clamps the average near 50, so
    block 64 cannot be held in steady state and the integrator ran to its rail:
    the trim wound up to +3.96%, which the feedback sweep had already shown pins
    the ring FULL. Underruns were traded for ~9600 overruns/s. A loop whose
    setpoint the plant cannot reach will always wind up.
    Now it integrates on (underruns - overruns) per period. Starved and flooded
    are the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
    [main.c, mdns.c]
2026-08-06 mcr: trip streak 6s -> 45s -- the feedback loop's convergence tripped it
    Answering 'did we break the NCO?': no. The NCO was correct throughout. The trip
    guard had DISABLED the rate discipline, leaving the media clock free-running at
    the crystal's ~4.5 ppm:
    discipline off (dry run), trips=1
    applied +0 ppb against a target of -4531 ppb
    NCO inc 4123169 (nominal) instead of 4123151
    drift climbing +30 -> +42 -> +48 samples
    Re-arming by hand brought drift straight back to -4 with applied -4588 ppb, which
    is the proof the oscillator and the servo were fine all along.
    The trigger was the firmware USB feedback loop. It starts at nominal feedback
    with ~40000 underruns/s and converge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
    [mcr_dante.c]
2026-08-06 stats: UDP opcode 'u' -- expose the USB ingress counters
    rx_beats (core->EP) and ep_out (EP->decoder) were console-only, and reading the
    console perturbs the system being measured. Over UDP they show the gap directly:
    rx_beats 9,042,899 B/s ep_out 8,705,608 B/s leak 3.73%
    Also folds in overrun/underrun so the three can be sampled together.
    NOTE on overrun_count: it folds TWO causes -- send_req arriving while the
    builder is busy (a skipped packet) and a ring-full write drop. Only the second
    loses audio. They cannot be told apart from this CSR, which matters now that the
    pacing fires send_req on any context becoming due rather than on a fixed
    8-sample tick, so builder-busy events ar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
    [dstats.c]
2026-08-06 fpp: revert the un-prime threshold -- it was back-pressuring USB and losing 3.7%
    MEASURED AGAINST THE KNOWN-GOOD BUILD, which is what settled it:
    baseline (main) block 32 (mine) block 8 (reverted)
    rx_beats 9,217,989 9,042,899 9,213,419
    ep_out 9,216,207 8,705,608 9,213,421
    (need 9,216,000)
    leak 0.02% 3.73% -0.00%
    overrun 17/s 7603/s 97/s
    underrun 0/s 2645/s 9/s
    Raising the un-prime threshold from FRAME_SAMPLES (block 8) to _center>>1
    (block 32)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
2026-08-06 fpp: fix the anchor reseed off-by-one; expose the shared-timestamp defect
    ANCHOR RESEED WAS ONE STROBE HIGH. The two phase-seeding paths sample the
    counter at different instants:
    bind seeds from ts_now_sub -- the counter's CURRENT value
    anchor seeds from `sub` -- the value it ADOPTS at the next strobe
    The phase register loads immediately on flow_cfg.re while ts_sub does not take
    `sub` until that strobe, by which point phase has incremented. Measured: a
    freshly bound fpp=60 flow emitted subsec congruent to 0, the same flow after a
    re-anchor emitted 59 -- exactly -1. Invisible at fpp=16 until an anchor fires,
    which is why it survived the earlier alignment work.
    Also adds runt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
    [dante_tx.c, dstats.c]
2026-08-07 usb: disable the firmware feedback loop -- it was solving a problem I created
    The loop existed to supply the +3.5% the hardware integrator could not reach,
    clamped as it is to +/-2.08%. That deficit was never real. It was the USB
    back-pressure leak caused by raising the un-prime threshold: 3.73% measured, and
    gone the instant the threshold was reverted. With no leak the required
    correction is near zero, comfortably inside the hardware loop's authority.
    Leaving the firmware loop running made things measurably WORSE, because it
    targets underrun == overrun and that settles where BOTH occur:
    firmware loop hardware loop (fb_ovr = 0)
    ring level avg 35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
    [dante_tx.c, main.c]
2026-08-07 fpp: size the frame buffer from N_WORDS -- 128 words was the DVS unicast failure
    frame_mem was Memory(32, 128), hardcoded. That was ample while the largest
    packet was 8 slots at fpp=16 (435 bytes = 109 words). Adding fpp=60 to the table
    raised the worst case to 1491 bytes = 373 words, and PAY_LEN/TOTAL were resized
    for it while this was not.
    fpp= 16 slots=8 -> 435 B 109 words fits
    fpp= 60 slots=2 -> 411 B 103 words fits
    fpp= 60 slots=4 -> 771 B 193 words OVERFLOWS 128
    fpp= 60 slots=8 -> 1491 B 373 words OVERFLOWS 128
    The failure is silent and total: the context binds, the FSM runs, and nothing
    reaches the wire.
    This is why DVS unicast never worked. It ne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
    [dstats.c, mdns.c]
2026-08-07 fpp: round the frame buffer to a power of two; 4-slot fpp=60 still not on the wire
    Memory(32, 373) -- N_WORDS exactly -- built cleanly, placed in the same BRAM
    count and passed all four clock criteria, then transmitted NOTHING: packet_count
    incremented at exactly the right rate while zero port-4321 frames left the MAC.
    128 had been a power of two; 373 is not. Rounded up to 512.
    That was a real defect of mine and it is fixed, but it was NOT the DVS cause:
    with 512 words the 4-slot fpp=60 case still produces no frames on the wire.
    STATE OF THE 4-SLOT fpp=60 INVESTIGATION:
    * the context binds (ctx 4sl fpp60 mc=1 -> 239.255.0.68)
    * packet_count rises by exactly the right amount -- 4601 pp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
2026-08-07 fpp: frame buffer sized for the worst case -- necessary, but NOT the DVS cause
    Retested the 512-word buffer on a seed validated by MEASURED USB quality
    (+0.01% leak, 0 underruns) rather than by Fmax, because the previous attempt was
    judged on seed 5 of an earlier sweep which had a 13% USB ingress leak and
    produced starved audio indistinguishable from a broken packetizer.
    Result: 4 slots at fpp=60 STILL produces nothing on the wire.
    ctx2 4sl fpp60 mc=1 -> 239.255.0.68 bound
    packets 4601 pps = 800 + 3000 + 800 exactly right
    on the wire nothing
    2 slots at fpp=60 transmits perfectly
    4 slots at fpp=16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
2026-08-07 litescope: analyzer on the TX seam for the 4-slot fpp=60 blackhole
    Probes the PRODUCING end (packetizer source, byte_idx, rd_idx, f_last_idx,
    f_total, stream_idx, pay_len, send_req, any_pend) and the CONSUMING end
    (arbiter -> mac.core.sink) in one 2048-deep trace, plus jtagbone.
    The question it exists to settle: 4 slots at fpp=60 binds, packet_count rises at
    exactly the right rate -- and that counter increments on (source.last &
    source.ready), so the sink IS accepting every frame -- yet nothing reaches the
    wire. Either the last beat carries wrong byte enables, or the MAC discards the
    frame after accepting it. Both are visible at this seam and neither is visible
    from any CSR.
    Everything che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
2026-08-07 packetizer: fix 512-byte frame ceiling (7-bit address into a 512-word buffer)
    rd_idx_next and fr_adr address frame_mem, which is 512 words, but both were
    left at Signal(max=128) when it grew from 128 words. 128 words = 512 bytes,
    and that was a hard ceiling on transmitted frame size:
    6 slots x fpp=24 483 B on the wire worked
    5 slots x fpp=32 531 B dead
    4 slots x fpp=60 771 B (DVS) dead
    8 slots x fpp=60 1491 B (max shape) dead
    This was chased for a long time as a UNICAST bug, because DVS (fpp=60, 4 ch)
    is the receiver that lands over the ceiling while AM2 (fpp=16) stays under it.
    It is not unicast-specific: 8 slots works, fpp=60 works, and on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
2026-08-07 seed_sweep: record that seed 1 (highest sys Fmax) kills USB outputs, seed 8 validated
    seed 1 has the highest sys Fmax of the clean seeds (63.54) and the lowest USB
    margin (79.62). Flashed, the MacBook enumerated the audio device and showed no
    outputs at all. seed 8 (63.26 sys, 85.55 USB) measures ep_out 9,216,211/s
    against a 9,216,000 baseline (+0.002%), USB leak +0.00%, underrun 0/s, ring at
    65, and carries unicast audio to AM2, A16R and DVS simultaneously.
    That is the second time a seed picked on sys Fmax turned out to be the worst
    one on hardware, so note explicitly: when seeds tie on sys, prefer higher USB_MHz.
    Also record that sys Fmax is not reproducible run-to-run -- seed 8 gave 54.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
2026-08-07 dante: make latency selectable from Dante Controller (ARC 0x1101)
    Controller's latency selection did not stick: set 2 ms, refresh, back to 1 ms.
    Three separate faults, found in this order.
    1. THE DEVICE DISAGREED WITH ITSELF. latency_ns was hardcoded in three places
    that had drifted apart -- mDNS chan said 2 ms, mDNS bundle said 1 ms, and the
    ARC flow descriptor said 1 ms. Controller reads the bundle value, so it showed
    1.0 ms while the chan record claimed 2. All three now read one variable,
    g_latency_ns, settable at runtime over UDP opcode 'L' so a target can be tried
    and reverted in seconds without a firmware push -- which matters because
    advertising too little fails SIL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
    [dante_arc.c, dante_dev.c, dante_dev.h, dante_tx.c, dante_tx.h, dstats.c, mdns.c]
2026-08-07 dante: advertise 0.5 ms, and make the 0x1100 capability table patchable
    ADVERTISED LATENCY -> 0.5 ms. This value is a FLOOR on every receiver: a
    receiver plays out at max(our latency_ns, its own setting), so advertising 2 ms
    pinned a RedNet A16R to >=2 ms no matter what its own Latency tab was set to.
    That, not anything in Dante Controller's UI, was what prevented running at
    0.5 ms.
    Verified at 0.5 ms from the receivers' own 0x8003 heartbeat reports: A16R peak
    0.00 ms, AM2 peak 0.23 ms, no device reporting a peak above its setting. Our
    transmit margin is far larger than the setting needs -- ts_lag.py against the
    PTP timeline puts us 8 samples EARLY with a 2.3-sample spread, while an A16R
    tr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
    [dante_arc.c, dante_arc.h, dante_dev.c, dstats.c]
2026-08-07 arc: rewrite 0x1003 to the layout real Dante devices emit; default latency 1 ms
    0x1003 followed inferno's proto_arc.rs get_device_names::ResponseHeader -- a
    38-byte header with the name offsets at +12/+14/+16. NEITHER RedNet on this
    bench does that. An A16R (Brooklyn-3) and an AM2 (UltimoX2) return a
    byte-identical structure that inferno does not describe:
    +0 0x001c +18 0x0500 +34 router_vers 48-byte header, 2 pad,
    +2 0x001c +20 friendly +38 arcp_vers then FIXED 32-byte name
    +4 0x0028 +22 factory +40 0x0204 fields: friendly @ +50,
    +6 board +24 friendly +42 0x1200 factory @ +82, then board
    +8 revision +30 0x0a0a +44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
    [dante_arc.c, dante_arc.h, dante_dev.c, dstats.c]
2026-08-07 identity: N-Series / USB Switchover / N-Series AOIP
    Manufacturer -> "N-Series", Model Name -> "USB Switchover",
    Dante Model -> "N-Series AOIP".
    Dante Controller reads these from three different places, and a stale comment
    had them confused. send_device_info's 0x38 field is DANTE MODEL; the "Model
    Name" Controller shows comes from send_product_info's 0xac. The old comment on
    0x38 said the two were "kept in step so DC never sees two different models for
    one device", which is wrong -- they are separate fields, and it only looked
    right because both records happened to carry the same string. Following that
    comment and setting both to "USB Switchover" made Controller display Model Name
    and Dante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
    [dante_arc.c, dante_info.c, mdns.c]
2026-08-07 README: 0.25 ms latency works; record the per-flow fpp floor
    Dante Controller now offers 0.25/0.5/1/2/5 ms, sets the value over ARC 0x1101,
    and the change takes effect immediately. At 0.25 ms a RedNet A16R negotiates
    fpp=8 and reports a 125 us peak -- half the budget.
    Records what "0.25 ms" does and does NOT mean here, because the distinction is
    easy to overstate. Latency is per-FLOW: a packet cannot exist until fpp samples
    after its own timestamp, so fpp/48000 is a hard floor per subscription.
    Measured on the bench with all three receivers subscribed at once:
    A16R (Brooklyn-3) fpp=8 0.167 ms -> runs at 0.25 ms, 125 us peak
    AM2 (UltimoX2) fpp=16 0.333 ms -> runs at 1 ms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
2026-08-07 README: document the UDP control surface, the real tools list, and two bugs
    The tools/ listing named six of fourteen scripts -- stats.py, the main telemetry
    entry point, was not among them, nor arc_query.py, which is what decoded the ARC
    property tables by comparing against real hardware.
    The UDP control surface on port 7779 had no reference at all despite being the
    primary way to interrogate and reconfigure a running device. It is also the
    RELIABLE channel: the UART drops output under load (a printf in a UDP handler
    never reached the console while the opcode demonstrably ran), so a console-only
    diagnostic can silently lose the one line that matters. That is now stated.
    Open bugs gains the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
2026-08-07 netload: retry the whole image when the loader NAKs; correct a bogus bug report
    The loader answers EXEC with NAK when its CRC over coderam does not match, and
    sets `started = 0` at that point with the comment "let the host retry cleanly".
    It is explicitly asking for another attempt. netload.py called sys.exit()
    instead, so one corrupted payload ended the session with the board sitting in
    the loader and no firmware running -- which happened on this bench and needed a
    JTAG bitstream reload to recover. It now retries the full transfer up to three
    times, and a DATA NAK restarts rather than aborts.
    A lost or duplicated DATA frame already self-corrected: the loader reports where
    it actually is an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
2026-08-07 README: correct two stale open-bug claims, add the seed and latency hazards
    STALE. The USB entry said the device enumerates as "N-Series USB 48CH"; it was
    renamed to "USB Switchover" this session, so the README described a string that
    no longer appears on the host. The 2-of-48-channel gap is unchanged and stays
    open, now alongside the measured ingress figures (+0.002%, leak +0.00%, 0
    underruns/s) with a note that those cover the transport and NOT the channel
    mapping the 48-channel failure mode lived in.
    The media-clock guard entry said closing it was "worth doing before an
    unattended overnight run". That run has since happened and audio survived it.
    Recorded -- but one run does not close it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
2026-08-07 README: our latency_ns is a FLOOR -- correct an overstated hazard
    The previous entry claimed that selecting 0.25 ms while DVS was subscribed would
    tell DVS to buffer less than our packets can arrive in and make it drop
    silently. That is wrong. A receiver plays out at max(our advertised latency_ns,
    its own setting), so our value can only ever RAISE a receiver's latency, never
    lower it below what the receiver itself chose. A console at 1 ms and a DVS at
    4 ms coexist, each at its own figure.
    The bench had already disproved the claim before it was written: with the device
    advertising 250 us, DVS still bound at fpp=60 and ran clean at 4 ms.
    The real hazard is the opposite direction and is now r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
2026-08-07 README: TODO -- persist settings and the RX patch across a power cycle
    cfgflash.c/config.c already persist a versioned CRC'd blob (static IP, clock
    source, converged PTP addend, media-clock rate), but three things an operator
    sets are not in it and return to compiled defaults on reboot: the advertised
    latency, the device name if renamed from Controller, and the RX patch --
    sub_tx_name[]/sub_tx_host[] in dante_arc.c are plain statics, so every
    subscription made INTO this device is lost.
    Latency is trivial: config.h documents the extension procedure and 55 bytes are
    reserved. The RX patch is not -- DANTE_RX_CHANNELS x 2 name strings exceed the
    spare space, so it needs a second flash region or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
2026-08-07 README: call OUR device AoIP, keep "Dante" only where it names Audinate's thing
    Five uses described this project itself as a Dante product, which is the use
    that reads as a brand claim rather than a statement of interoperability:
    title "48-channel USB -> Dante interface" -> AoIP interface
    intro "a native Dante transmitter" -> a native AoIP
    transmitter,
    interoperating with
    Audinate's Dante
    protocol
    architecture "6 x Dan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
2026-08-07 identity: N-Series AoIP, matching the README's AoIP naming
    The model strings read AOIP while the README now uses AoIP throughout for the
    generic protocol term. Same word, two renderings, and the device is what a user
    actually sees in Dante Controller -- so the wire should match the document.
    mdns router_info= N-Series AOIP -> N-Series AoIP ("Dante Model" in DC)
    ARC 0x1003 board N-Series AOIP -> N-Series AoIP
    info 0x38 (16B) N-Series AOIP -> N-Series AoIP
    info 12 (8B) NSerAOI -> NSerAoI (stays 7 chars: put_fixed
    reserves no terminator)
    Verified on the wire after the push: router_info=N-Series AoI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
2026-08-11 flash.sh: one command to get the current build onto the board
    ./flash.sh volatile: pld load + firmware over Ethernet
    ./flash.sh --permanent SPI: bitstream at 0x0 AND firmware image at 3 MB
    ./flash.sh --unlock once per board (MX25L128 ships write-protected)
    ./flash.sh --fw-only firmware only
    VOLATILE BY DEFAULT. `pld load` writes SRAM configuration, so a power cycle
    falls back to whatever is in SPI -- the cheapest rollback available for a design
    that can in principle take the board off the network. --permanent is for a build
    that has been listened to.
    --permanent writes BOTH images. The bitstream alone boots into the loader, which
    waits for netload and then fall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
2026-08-11 latency: publish changes to the network, and stop reporting a frozen value
    Two separate faults, both from treating live state as constant.
    1. mdns_announce() published ARC and CMC records only -- and latency_ns lives in
    the CHANNEL TXT. Changing the latency updated the device and told nobody:
    receivers and Dante Controller served their cached copy until the 120 s TTL
    expired. Symptom on the bench: set a latency, refresh, the old figure is back;
    a RedNet A16R reporting our latency as 1 ms while the device was on 0.5.
    The records already carry the cache-flush bit, so a resolver REPLACES on
    receipt. The flag was never the problem -- we never sent them. Now every
    channel T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
    [dante_arc.c, mdns.c]
2026-08-11 README: record 3 days of uptime with instant clean audio -- and what it is not
    Observed 2026-08-11: the board had been powered 3 days; starting the host gave
    instantly clean audio, no re-lock wait and no startup artefacts. That is real
    evidence PTPv1 lock and the media-clock discipline survive long uptime, which is
    what the drift work existed for, so phase 6 moves from 'not started' to
    'partial'.
    Explicitly NOT the 24 h test, and the README says so rather than letting a good
    result read as a passed one: audio was not streaming for those three days -- the
    host was off -- so it shows the clock is healthy after long IDLE, not that a
    stream survives 24 h. The soak phase 6 asks for is continuous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
2026-08-11 README: the advertised floor must cover every receiver's fpp window (measured)
    Receivers FOLLOW our advertised latency_ns; they do not take max() with their
    own minimum. Measured on a RedNet AM2 and reproducible in both directions:
    0.25 ms floor -> AM2 reports 1.21 ms and goes red; 0.5 ms -> 0.27 ms green;
    1 ms -> 0.29 ms green. A packet cannot exist until fpp samples after its own
    timestamp, so a receiver negotiating fpp=16 needs 333 us and simply cannot
    comply with a 250 us budget.
    The lowest usable floor is therefore the LARGEST fpp window among subscribed
    receivers -- 0.5 ms for an A16R (fpp=8) plus an AM2 (fpp=16). The same rule
    predicted the fpp=60 device reporting 1.29 ms against a 2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
2026-08-11 flows: runtime cap on accepted fpp -- and the finding that it cannot help
    We advertise "fpp=8,2" in mDNS and accepted anything in FPP_TABLE, so an AM2
    asking for fpp=16 got it. That mismatch looked like the lever for per-receiver
    latency: fpp=16 is a 333 us packetization window, which cannot fit a 250 us
    advertised latency, so forcing the AM2 onto fpp=8 (167 us) would in principle
    let 0.25 ms work for every receiver at once.
    MEASURED, AND IT DOES NOT WORK. With the cap at 8 the A16R came back at fpp=8
    and the AM2 did not come back AT ALL -- rejected at 16, it stops subscribing
    rather than renegotiating downward. The fpp=60 device behaves the same way. A
    receiver's fpp is its choice, not a k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
    [dante_dev.c, dante_dev.h, dante_tx.c, dstats.c]
2026-08-11 flows: mirror flow-control requests, and the finding that they do not change
    Extends the UDP mirror (opcode 'A') to port 4455 so a receiver's flow request
    can be read off a machine that is not in the unicast path. The console cannot do
    it: output is dropped under load, and the [flow] lines are the first thing lost
    while 48 channel TXTs are sweeping.
    WHAT IT SETTLED. A RedNet AM2 reports 0.27 ms of latency when we advertise a
    0.5 ms floor and 1.9 ms when we advertise 0.25 ms, while its fpp stays 16 and
    our transmit timing does not change -- measured 13 samples EARLY at the moment
    it claimed to be 1.9 ms late. Two explanations were possible: the AM2 asks for
    something different at 0.25, or it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
2026-08-11 latency: advertise max(selected, what the bound flows can actually meet)
    Receivers use our advertised latency_ns AS the flow's playout latency -- not
    max() with their own setting. Proven on the bench by mirroring port 4455: a
    RedNet AM2's flow request is BYTE-IDENTICAL when we advertise 0.25 ms and
    0.5 ms (same fpp=16, same channels, only the sequence number differs), yet it
    reports 0.27 ms of latency at 0.5 and 1.9 ms at 0.25. It buffers exactly what we
    tell it to.
    A packet cannot exist until fpp samples after its own timestamp, so a flow at
    fpp=16 needs 333 us and cannot be served inside a 250 us budget however early
    our timestamps are -- and they ARE early, measured 13 samples ahead at t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
2026-08-11 latency: Controller's config page shows the SELECTED value, not the raised one
    The auto-raise made a 0.25 ms selection read back as 2.0 ms on Controller's
    config page, which is indistinguishable from the setting being ignored -- the
    exact symptom this whole area started with, reintroduced by the fix for it.
    0x8205/0x8301 are what Controller's config page reads, so they now report
    g_latency_ns: what the operator CHOSE. The auto-raised figure goes where it
    belongs -- the mDNS channel record and the ARC flow descriptor, which is what
    receivers actually act on.
    Audinate describes the same split: the configured setting stays yours, and
    Dante 'increases it to the lowest supported value' for the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
    [dante_arc.c]
2026-08-11 mdns: make the advertised fpp maximum settable -- a real transmitter caps it at 4
    A RedNet A16R set to 0.25 ms serves an AM2 at 1 ms and DVS at 4 ms
    SIMULTANEOUSLY, each at its own latency, with its own 0.25 propagating to
    neither. It advertises:
    fpp=4,2 latency_ns=250000
    Four samples is an 83 us packetization window, so every flow it serves fits
    inside 0.25 ms whatever the receiver sets -- the receiver's own latency is just
    buffer on top. There is no per-flow latency negotiation doing this. The
    transmitter simply never emits a packet big enough to be a problem.
    We advertised fpp=8 and ACCEPTED up to 60, so DVS asked for 60 (a 1.25 ms
    window) and one such flow dragged the whole dev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
    [dante_dev.c, dante_dev.h, dstats.c, mdns.c]
2026-08-11 latency: cap the advertised fpp at 4 and drop the auto-raise -- per-receiver works
    MEASURED, three receivers at once against a 0.25 ms floor:
    A16R fpp=4 83 us window runs at 0.25 ms, 20 us average
    AM2 fpp=16 333 us runs at 1.0 ms, its own setting
    DVS fpp=60 1250 us runs at 4.0 ms, its own setting
    Each at its OWN latency, simultaneously -- which is what a RedNet A16R does when
    it transmits, and what this could not do an hour ago.
    TWO THINGS WERE WRONG, and the second was my fix for the first.
    The AM2 going red at a 0.25 ms floor was never a latency problem. It was
    negotiating fpp=16 -- a 333 us packetization window that cannot be delivered
    inside 250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
    [dante_dev.c, dante_dev.h, dante_tx.c, dstats.c]
2026-08-11 tx: timestamp offset 0 -- lag = fpp-1, correct at every fpp
    DANTE_TX_TS_OFFSET was 6, calibrated against a large fpp. lag = (fpp-1) - OFFSET,
    so the value only holds for the fpp it was measured at. When a RedNet A16R
    renegotiated to fpp=4 (after we began advertising fpp=4,2) the lag became
    3-6 = -3 samples: our timestamps AHEAD of arrival. The receiver's measured
    latency collapsed to zero and Dante Controller showed a GREY Latency Status --
    not a fault, but the health indicator lost.
    0 makes lag = fpp-1, which is the relationship by construction rather than by
    tuning: the timestamp marks the packet's FIRST sample and the packet is emitted
    when its LAST sample arrives, so PTP_now - timestamp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
    [dante_tx.h]
2026-08-11 README: per-receiver latency works -- record the verified result and the real cause
    Three receivers subscribed at once, each at its OWN latency setting, audio
    confirmed clean by ear on the AM2 and DVS: A16R fpp=4 at 0.25 ms measuring 81 us
    green, AM2 fpp=16 at 1.0 ms, DVS fpp=60 at 4.0 ms. 15,800 pps, no underruns or
    overruns.
    The previous entry said one device-wide value forces the slowest subscriber's
    latency on everyone. That was true of the code at the time and is no longer the
    behaviour, so it is replaced rather than left to mislead.
    THE CAUSE WAS PACKET SIZE, NOT LATENCY. We advertised fpp=8,2 and accepted up to
    60, so receivers negotiated packets we could not deliver quickly -- an A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
2026-08-11 flows: serve an oversized fpp at our maximum instead of refusing it
    DVS cannot be talked down -- its own minimum latency is 4 ms, so it always asks
    for fpp=60, a 1.25 ms packetization window, and measured 1.77 ms from us against
    800 us from a RedNet A16R. Rejecting the request does not help: capped at 4, DVS
    retried the IDENTICAL request 16 times and never renegotiated, and the AM2 did
    the same. Both simply stop subscribing.
    Serving a smaller packet than was asked for works, because a receiver
    reassembles by TIMESTAMP and not by the fpp it requested. That is how the A16R
    gets away with capping at 4. With clamping on, DVS binds at our maximum without
    complaint and its measured latency falls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
    [dante_dev.c, dante_dev.h, dante_flows.c, dstats.c]
2026-08-11 README: record the fpp clamp and the timestamp-offset fix
    The latency section described the state three commits ago and omitted the two
    changes that actually made it work: serving an oversized fpp at our maximum
    instead of refusing it (g_fpp_clamp, cap 16), and DANTE_TX_TS_OFFSET = 0.
    Records the final verified table -- A16R 20 us, AM2 280 us, DVS under 700 us,
    all green with audio clean by ear -- and the measurements behind each choice,
    including why the cap is 16 and not 4: at fpp=4 the AM2's packet rate tripled to
    12,000/s and it went RED at 1.10 ms while our side stayed clean at 48,001 pps
    with zero overruns. A receiver's requested fpp encodes its own capability, not
    just its latency se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
2026-08-11 flows: turn the fpp clamp OFF -- it cost the AM2 more than it gained DVS
    Committed ON in f86c040 on the strength of a 15-second measurement. Ten minutes
    of real running disproved it: the AM2 drifted from 0.46 ms to 1.04 ms and went
    RED. Reverting the clamp restored it within a minute. Measured A/B, same bench,
    audio playing throughout:
    clamp ON, 18,000 pps A16R 0 AM2 50 (1.04 ms) RED DVS 11 (0.42 ms)
    clamp OFF, 9,800 pps A16R 6 AM2 22 (0.46 ms) green DVS 91 (2.73 ms)
    The AM2's own fpp was 16 in BOTH cases -- the clamp never touched its flow. What
    changed is that clamping DVS from 60 to 16 tripled DVS's packet rate and took
    the total from 9,800 to 18,000 pps. Our tra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
    [dante_dev.c, dante_dev.h]
2026-08-11 tx: re-anchor threshold 24 -> 8, so the guard band fits a 0.25 ms budget
    24 samples was sized as "half a 1 ms budget" and does not survive a receiver
    running at 0.25 ms: 24 samples is 0.5 ms, DOUBLE that receiver's entire budget
    of 12 samples. Same shape as the 240-sample threshold that guarded a 48-sample
    budget before it -- a backstop wider than the thing it protects.
    Measured with a RedNet A16R at 0.25 ms: `anchors` rose 5 -> 7 in about thirty
    minutes, so the media clock's residual drift walks the emitted timestamp until
    this fires, and between fires the error sweeps the whole window. A 24-sample
    sweep cannot fit inside a 12-sample budget: the A16R's reported latency sat
    clamped at 0, wh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
    [dante_tx.h]
2026-08-11 README: quantify the residual media-clock drift and what it costs
    +0.35 ppm with discipline ARMED and healthy (target and applied both -4354 ppb,
    0 trips, ring 63-67, 0 underruns), measured with tools/mclk.py watch 120:
    drift slip +2 samples / 120 s = +0.35 ppm = +1.2 ms/hour
    drift is emitted-minus-PTP, so our timestamps run AHEAD and a receiver's measured
    latency falls by 1 SAMPLE PER MINUTE. A RedNet A16R at 0.25 ms was watched doing
    it: 134 us, decaying, then clamped at 0 with a grey Latency Status. At that rate
    the re-anchor backstop fires about every 8 minutes and each fire is a timestamp
    discontinuity.
    Records why neither a timestamp bias nor a tighter re-anchor threshold fixes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
2026-08-11 sim: the phase term cannot be enabled as shipped -- it limit-cycles +-20 samples
    Models mcr_dante's phase PI against the residual actually measured (+0.35 ppm,
    tools/mclk.py watch 120, discipline armed and healthy) before enabling anything,
    because this subsystem has broken audio twice.
    THE SHIPPED GAINS FAIL. Kp = PHASE_KP_NUM/DEN = 2/5 = 0.4 ppb per sample. The
    plant is an INTEGRATOR -- 1 ppb becomes 4.8e-5 samples/s -- so Kp=0.4 is a
    14.5 HOUR time constant. The proportional term cannot control phase on any
    useful timescale, the integral runs the loop alone, and it limit-cycles over
    20 samples. A RedNet A16R at 0.25 ms has a budget of 12 samples. Turning the
    phase term on as-is would be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
2026-08-11 README: the ring can lose prime and never recover
    Seen 2026-08-11: audio stopped on every receiver and a RedNet AM2 became
    unstable, while data was still arriving at the correct rate.
    rx_beats = ep_out = 9,312,144/s leak +0.00% overrun 0/s
    fifo_level 0 underrun 48,001/s
    Writes were not being dropped and nothing was leaking -- the write and read
    pointers were simply chasing each other with NO CUSHION. The ring had lost its
    64-sample buffer, never re-primed, and every packet was built from silence.
    48,001 underruns/s is one per sample tick, which is the signature.
    The media clock was healthy throughout (ARMED, -4367 ppb, 0 trips), so this is
    not a clock faul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
2026-08-11 mclk: fix the phase-loop gains, and reject the second-boundary outlier
    TWO separate problems, and the second is why the phase term must stay off.
    1. THE GAINS COULD NOT HOLD PHASE. Kp was PHASE_KP_NUM/DEN = 2/5 = 0.4 ppb per
    sample. The plant is an INTEGRATOR (1 ppb -> 4.8e-5 samples/s), so 0.4 is a
    14.5 HOUR time constant: the proportional term does nothing on any useful
    timescale, the integral runs the loop alone, and sims/sim_mclk_phase_trim.py
    shows it limit-cycling over 20 samples against a 12-sample budget at 0.25 ms.
    Now Kp=30/1, Ki=10: settles within 1 sample, 1-sample swing, peaks 734 ppb
    against the 2000 clamp, never exceeds the 100 ppb/s slew limiter.
    2. THE DR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
    [mcr_dante.c]
2026-08-11 DRIFT_HANDOFF.md: everything a fresh session needs to fix the +0.35 ppm drift
    The drift is understood and measured but not fixed, and the reason it is not
    fixed is subtle enough to be rediscovered the hard way. This writes it down.
    Contents: the symptom (a receiver's reported latency walking to zero at 1 sample
    per minute until the re-anchor snaps it), the measurement that quantifies it,
    the phase term that was supposed to fix it, and the two separate reasons it did
    The blocker is NOT the gains. It is that drift_samples is computed from two
    reads taken at different instants -- gptp_read_time() and
    dante_tx_read_emitted() -- so a sample straddling a one-second boundary is wrong
    by 4800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
